lyy622516-web/basestation/05_嘉立创EDA工程/UHF_Reader_MultiFuntion_V5/3D模型与结构腔体/1412b6973b29b4b69cf0d955ecb4523.png

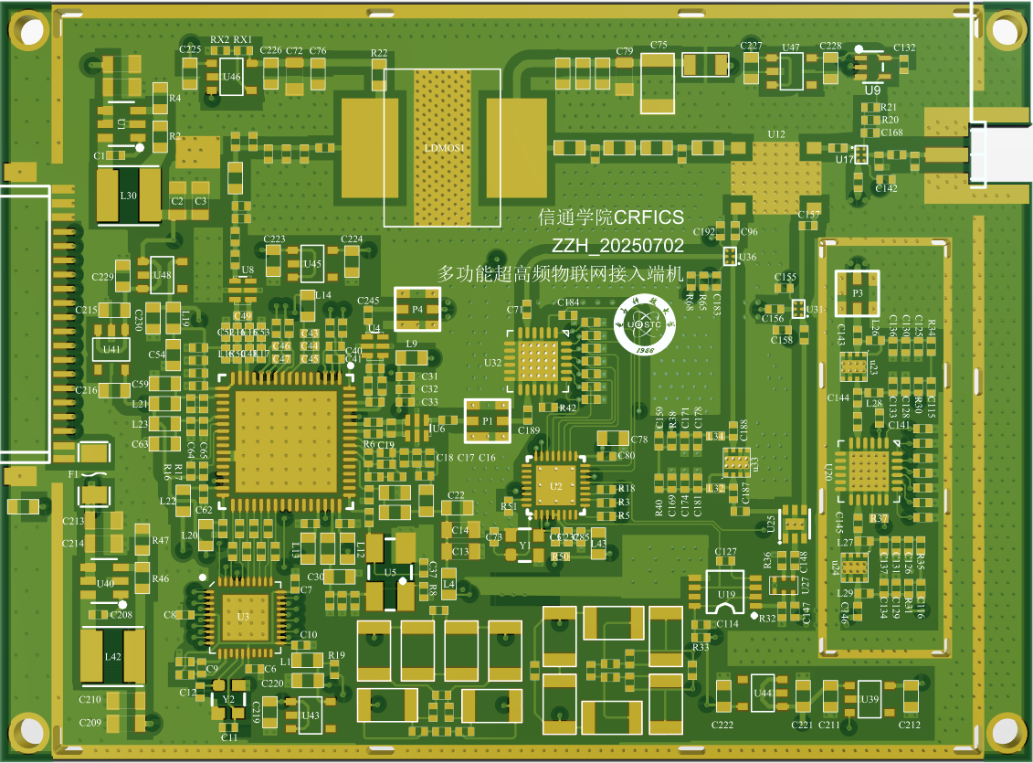
05_嘉立创EDA工程/UHF_Reader_MultiFuntion_V5/3D模型与结构腔体/1412b6973b29b4b69cf0d955ecb4523.png
