lyy622516-web/basestation/01_技术方案与设计报告/设计思考/20260720.docx

FM13RD1616 + YSO510TP 48MHz TCXO 波形选型结论

最终综合最优：削顶正弦（Clipped Sine）输出

FM13RD1616 是射频专用 UHF RFID 读写芯片，内置射频 PLL 产生 860–960MHz 载波，射频性能是第一优先级；YSO510TP 选用削顶正弦 TCXO，射频指标、识读距离、杂散抑制全面优于 CMOS 方波。

一、FM13RD1616 芯片硬件输入特性依据

芯片引脚TCXO为模拟射频参考输入，内部是射频限幅放大器，原生适配小幅正弦类波形，不是数字施密特触发器；

片上 PLL、VCO、接收通路对参考相位噪声、谐波杂散极度敏感，杂散会直接压低接收灵敏度、缩短标签读取距离；

芯片独立分出VDD_CLKREF(1.8V)数字时钟域、VDD_PLL/VDD_VCO(3.3V)射频模拟域，数字时钟与射频参考物理隔离，射频 PLL 不适合数字方波。

二、两大波形分项性能对比（针对本方案场景）

1. 射频核心指标（决定 RFID 读写核心性能）

削顶正弦 Clipped Sine（推荐）

谐波分量极低，不会在 900MHz 载波产生参考倍频杂散，频谱干净；

TCXO 工作在线性振荡区，近端相位噪声更优，PLL 输出载波相位噪声更低；

输出阻抗接近 50Ω，射频走线反射小，PCB 长线无振铃；

接收底噪更低，同等功率下识读距离提升 0.5~1.2m，多标签盘点稳定性更强。

CMOS 方波（不推荐直进 TCXO 引脚）

陡峭边沿产生大量 3/5/7 次奇次谐波，谐波能量馈入 PLL，载波杂散抬高；

数字输出高阻，射频走线易反射，引入额外抖动；

末级整形反相器叠加开关噪声，恶化 TCXO 本底相位噪声；

杂散抬高接收噪声底，近距离多标签容易漏读、碰撞率上升。

2. 电路复杂度与物料成本

削顶正弦：TCXO 输出串 100nF 隔直电容 + 50Ω 匹配电阻接入TCXO引脚，仅两颗无源件；

CMOS 方波：必须额外增加 RC 低通滤波抑制谐波，否则射频指标不合格，多增加阻容，布局难度更大。YSO510TP 削顶正弦标准接入电路（FM13RD1616）

YSO510TP VDD 接芯片TCXO_SUPPLY（由TCXO_E使能开关控制，低功耗休眠）；

TCXO_OUT → 100nF 隔直电容 → 50Ω 串联匹配电阻 → 芯片TCXO模拟输入脚；

VDD_TCXO、VDD_PLL独立电源，各自就近 0.1μF+1000pF 去耦，数字地与射频地单点连接；

射频参考走线短、完整地平面包围，远离数字时钟、SPI 信号线。

单颗 YSO510TP 48MHz TCXO 驱动 4 片 FM13RD1616 实现射频严格同频同相完整方案

一、核心基础结论

TCXO 输出固定选用 Clipped Sine 削顶正弦

FM13RD1616 的TCXO引脚是射频模拟参考输入，内置限幅放大器，原生适配小幅正弦波形；方波谐波会抬升 PLL 杂散、破坏多通道相位一致性。

不能 TCXO 直分 4 路到芯片

单颗 TCXO 驱动 4 路射频输入负载过重，波形畸变、各路相位偏移大；必须增加兼容 Clipped Sine 的 4 路射频专用时钟扇出 Buffer做隔离、放大、等长分发。

同频原理：4 片芯片 PLL 共用同源 48MHz 参考，分频倍频至 860~960MHz 载波，天然频率完全一致；

严格同相关键：Buffer 四路输出走线 100% 等长、阻抗 50Ω 匹配、电源分区隔离、同步上电锁定。

二、整体硬件拓扑（唯一可靠架构）

plaintext

YSO510TP（48MHz Clipped Sine）

↓

隔直电容100nF + 50Ω串联匹配电阻

↓

4路射频兼容时钟Buffer（5PB1214，1进4出，原生支持削顶正弦）

├─输出1 → 匹配网络 → FM13RD1616 #1 TCXO引脚

├─输出2 → 匹配网络 → FM13RD1616 #2 TCXO引脚

├─输出3 → 匹配网络 → FM13RD1616 #3 TCXO引脚

└─输出4 → 匹配网络 → FM13RD1616 #4 TCXO引脚

每路独立缓冲隔离，四路负载互不干扰，消除负载牵引导致的相位偏移；

2.5/3.3V 供电，可与 FM13RD1616 模拟域共轨。

不推荐方案说明

不用 CDCLVC1108/INS6108：仅支持 CMOS 方波，削顶正弦输入识别不稳定，引入额外相位误差；

不用 TCXO 星型直分四路：四路负载互相拉扯，每路波形幅度、延迟不一致，射频载波相位差可达数十度，无法满足阵列同步；

不用射频功分器替代 Buffer：无源功分器损耗大、无信号整形，波形劣化，相位一致性差。

三、分模块电路设计细节

1）YSO510TP → 5PB1214 输入匹配电路

YSO510TP VDD 由系统模拟 LDO 单独供电，数字 / 模拟电源分开；

TCXO_OUT → 100nF 隔直电容（阻断直流分量）→ 50Ω 串联电阻 → 5PB1214 CLKIN；

电阻靠近 Buffer 输入引脚，走线极短，全程 50Ω 微带阻抗；

YSO510TP、5PB1214 电源引脚并联 0.1μF+1000pF 高频去耦电容。

2）5PB1214 四路输出到 4 片 FM13RD1616（同步核心）

每一路输出统一匹配网络：

Buffer_OUT → 50Ω串联电阻 → 100nF隔直电容 → FM13RD1616 TCXO引脚

等长布线硬性要求

四路时钟走线物理长度完全相等，误差控制≤0.5mm；48MHz 对应波长约 625mm，1mm 长度差会带来 0.576° 载波相位差，长走线误差会直接破坏阵列同相。

拓扑：H 树 / 对称星型，四路分支对称布局，无长短 Stub；

全程 50Ω 单端微带，完整地平面屏蔽，远离 SPI、发射射频信号线；

每路独立匹配电阻隔离，消除四路之间信号串扰。

3）电源分区隔离（抑制噪声带来的相位漂移）

模拟域：YSO510TP、5PB1214、4 片 FM13RD1616 的VDD_PLL/VDD_TCXO共用低噪声 LDO；

数字域：MCU、SPI 控制、移相器数字时钟单独一组电源；

数字地、模拟地单点连接，禁止数字地线穿过射频参考时钟下方；

各芯片 PLL 供电独立去耦，避免电源调制造成载波相位偏移。

四、实现 “严格同频 + 严格同相” 三大关键机制

1. 同频保障（硬件同源，无频偏）

4 片 FM13RD1616 内部 PLL 全部锁定同一 48MHz 基准参考，PLL 倍频分频系数完全一致，载波频率理论零偏差；

TCXO 选用 YSO510TP（温漂≤±0.5ppm），全温下四路频率漂移完全同步，不会出现频差。

2. 外部传输路径相位一致（Buffer + 等长走线）

5PB1214 四路通道固有歪斜＜15ps；

四路走线等长消除 PCB 传输延迟差；

每路独立缓冲，四路负载不会互相拉偏信号相位；

满足 RFID 相控阵列多路载波相位同步要求。

3. 上电同步锁定（软件配合消除上电相位随机差）

仅硬件时钟等长还不够，每颗芯片 PLL 上电锁定时，电荷泵初始状态随机，会产生固定相位偏移，必须软件同步流程：

系统上电后，等待 YSO510TP 稳定起振（≥2ms）；

MCU 同时发送复位信号至 4 片 FM13RD1616 的 RST 引脚，同步复位全部 PLL；

统一写入相同 PLL 分频寄存器、发射功率寄存器；

等待全部芯片 PLL 锁定标志位全部置 1 后，再打开射频发射通路；

阵列校准：发射状态下，通过后端 8bit 数控移相器做微小相位补偿，抵消器件固有微小相位差，实现射频输出载波完美同相。

五、与多路移相器时钟分离设计（你的阵列配套需求）

本方案中射频参考时钟（TCXO→FM13RD1616）仅负责 PLL 本振；

48MHz 数字时序时钟（给 PE44820/HWDPH0913-8 移相器）单独增加一颗 CMOS 输出 TCXO+CDCLVC1108 扇出，两套时钟物理隔离：

射频参考：Clipped Sine，走模拟地，追求低相噪、载波同步；

数字控制时钟：CMOS 方波，走数字地，多路扇出简单；

两套时钟不共用，避免数字开关噪声污染射频参考，保障射频同相性能。

六、避坑关键要点

禁止将 YSO510TP 方波版本接入系统，谐波会导致四路载波杂散不一致、相位抖动；

禁止省略 5PB1214 直接分四路，负载不平衡带来巨大相位差；

时钟走线不可靠近发射 860~960MHz 射频线，射频辐射会调制参考时钟，破坏同步；

所有匹配电阻、隔直电容选用 0402 小封装，紧贴芯片引脚，缩短高阻抗节点；

高低温测试验证：-40~+85℃全温区间，四路载波相位差稳定＜3°。

七、最简实施总结

晶振：YSO510TP 选用Clipped Sine 削顶正弦版本；

扇出缓冲：5PB1214（1 进 4 出，适配正弦 TCXO）；

布线：四路输出走线严格等长、50Ω 阻抗、对称 H 树布局；

电源：模拟 / 数字电源地分离，PLL 采用低噪声 LDO；

软件：四片芯片同步复位、同步配置 PLL，配合后端移相器做相位微调校准；

最终实现 4 路 FM13RD1616 发射射频信号同频、严格同相，适配 UHF RFID 相控阵列波束合成。

两路 860~960MHz 载波频差＜0.01Hz 完整实现方案（基于单 YSO510TP 驱动双 FM13RD1616）核心原理频差本质来自参考源频漂、PLL 分频误差、温度梯度、负载牵引、电源调制。要做到载波频差＜0.01Hz，必须从「同源基准、超低温漂 TCXO、同源缓冲隔离、等温布局、同步锁相、软件校准、高稳定供电」全链路约束。

先换算指标：

载波 900MHz，参考 48MHz，PLL 倍频系数 \(N=900/0.048=18750\)

参考频漂 Δf_ref 放大 N 倍映射到载波：

\(\Delta f_{RF} = N \cdot \Delta f_{ref}\)

要求 \(\Delta f_{RF}<0.01\mathrm{Hz}\)，则允许两路参考相对频漂：

\(\Delta f_{ref} < \frac{0.01}{18750} \approx 5.33\times10^{-7}\mathrm{Hz}\)

即两片 FM13RD1616 收到的 48MHz 参考信号相对频漂必须低于 0.533μHz，只能用同一颗 TCXO 同源供给，双独立 TCXO 无论多高精度都做不到。一、基准源硬性选型（YSO510TP 规格锁定）

型号版本：Clipped Sine 削顶正弦输出，禁止 CMOS 方波；

温漂等级：选最高精度 ±0.05ppm/-40~+85℃ YSO510TP，低精度 ±0.5ppm 版本直接淘汰；

老化指标：年老化＜0.1ppm；

供电：必须低噪声、零温漂 LDO（如 ADP150、TPS7A4700），禁止开关电源直供 TCXO；

关键：全程单 TCXO 唯一参考，两路射频 PLL 共用同源 48MHz，从根源消除固有频差。

二、参考时钟链路消除两路参考相对频漂（核心硬件）1. 缓冲器采用 5PB1202（1 进 2 出专用 TCXO 缓冲）

双通道独立隔离，消除两路 FM13RD1616 输入负载牵引带来的微小频漂偏移；

通道间器件相对频漂、时延差异远小于 0.1μHz，不破坏频差指标；

链路结构：

YSO510TP → 100nF 隔直 + 50Ω 匹配 → 5PB1202 输入

两路输出各带 50Ω 串阻 + 100nF 隔直，分别接入两片 FM13RD1616 TCXO 脚

2. PCB 布局等温 + 等长同步约束（杜绝温度梯度带来相对频漂）

等温集群布局

YSO510TP、5PB1202、两片 FM13RD1616 四颗器件紧贴集中摆放，间距＜5mm；周边禁止功率功放、电感、MOS 管等发热器件；发热射频功放单独分区，加隔热铜箔隔离；

时钟走线严格对称等长

两路 48MHz 参考走线长度差≤0.1mm，过孔数量、弯曲完全一致；

地层处理：模拟地完整包裹时钟线，数字地单点连接，杜绝数字开关噪声调制参考频率。

3. 链路无源器件统一规格两路匹配电阻、隔直电容采用同一批次 0402 高精度元件，容差 1% 薄膜电阻、COG 高频电容，消除元件参数差异引入微小相位 / 频率偏移。三、双 FM13RD1616 PLL 同步锁相机制（消除锁相随机频差）1. 硬件同步复位单根 RST 线并联两片芯片复位引脚，同步上电、同步释放复位；2. 同步寄存器写入MCU 同一时序同时向两片 FM13RD1616 下发：

完全一致的 PLL 分频系数 N（900MHz 对应 N=18750）

相同电荷泵电流、环路滤波参数

相同 VCO 校准字

3. 环路滤波完全一致两片芯片 PLL 外接 RC 环路滤波采用同批次同规格元件，布局对称、走线等长；环路带宽匹配，避免锁相建立时间不一致产生瞬时频差。4. 等待双路同时锁定再发射轮询两路 PLL 锁定标志，两路全部稳定锁定≥100ms后再打开射频发射通路；单路先锁定、一路后锁定会产生短时频差超标。四、供电系统抑制电源调制频漂（电源噪声会直接调制 TCXO/PLL 频率）

模拟域统一低噪声 LDO

YSO510TP、5PB1202、两片 FM13RD1616 的 VDD_TCXO、VDD_PLL 共用同一路极低噪声 LDO，电源轨完全同源，两路无供电压差、无电源噪声差；

分级去耦

每颗芯片电源引脚：0.1μF COG 高频电容 + 1μF X7R 储能电容就近接地；TCXO 供电额外增加 LC 低通滤波，抑制低频电源纹波；

数字、模拟电源完全分离

MCU、移相器数字时钟、SPI 通信使用独立 LDO，数字噪声绝不串入射频模拟电源轨。

五、恒温控制方案（高低温宽温下维持频差＜0.01Hz 必备）常温短时间测试可勉强达标；全温 - 40~+85℃高低温环境必须增加微型恒温槽 / 恒温铜座：

将 YSO510TP 放置小型恒温金属基座，控温精度 ±0.1℃；

5PB1202、两片 FM13RD1616 紧贴恒温基座，保证四颗器件温度完全一致，无温差；

温差 ΔT 会带来 TCXO 微小频漂差，1℃温差即可造成载波频差突破 0.01Hz，等温是宽温指标关键。

六、软件实时微小频差校准闭环（终极补偿手段）硬件只能抑制固有频漂，环境缓慢温漂、器件老化会产生缓慢频偏，增加闭环校准：

外部引入高稳定标准参考源（铷钟 / OCXO 10MHz 基准）作为监测标尺；

耦合两路 860~960MHz 载波到鉴频鉴相模块，实时采集两路载波频差；

MCU 根据实测频差，微调两片 FM13RD1616 内置 PLL 微调字，动态抵消微小频偏；

校准周期 1~10 秒，把静态残余频差持续压制在 0.01Hz 以内。

七、必须规避的致命错误（任意一条都会频差超标）

两路使用两颗独立 TCXO：两颗晶振存在固有 ppm 级偏差，放大 18750 倍后载波频差几十 Hz，完全不达标；

TCXO 直接一分二驱动两片芯片：负载牵引造成两路参考微小频漂，频差轻松超过 0.1Hz；

芯片分开复位、分时配置 PLL：锁相相位 / 频率随机偏移；

发热功放靠近 TCXO 与 PLL 芯片，产生温差梯度；

开关电源直接给 TCXO/PLL 供电，纹波调制频率；

不做恒温，高低温环境下器件温差带来频漂差。

八、指标达成逻辑总结

同源单高精度 TCXO：根除两路基准固有频差；

独立隔离缓冲 + 对称等长等温布局：消除负载、温度、走线引入的相对频漂；

同步复位 + 同步 PLL 配置 + 匹配环路：锁相状态完全一致；

统一低噪声模拟供电：杜绝电源调制频差；

恒温基座 + 软件闭环微调：残余频差压制至＜0.01Hz。

单颗 YSO510TP 48MHz TCXO 驱动两片 FM13RD1616 双通道严格同频同相完整工程方案

一、核心设计约束与选型定案

1. TCXO 硬性选型

YSO510TP 必须选 Clipped Sine 削顶正弦输出

原因：FM13RD1616 的TCXO引脚为模拟射频参考输入，内部限幅放大器适配小幅正弦；CMOS 方波高次谐波会恶化 PLL 相位噪声、引入通道相位不一致，严禁选用方波版本。

2. 必须增加双通道专用 TCXO 缓冲（不可 TCXO 直分两路）

直分两路会出现负载牵引效应，两路 TCXO 输入阻抗互相拉扯，波形幅度、传输时延不一致，载波产生数十度固定相位差。

缓冲器推荐型号：5PB1202（1 进 2 出，最优匹配）

输入兼容 Clipped Sine/CMOS 两种波形，原生适配 YSO510TP 正弦输出；

通道间固有歪斜≤12ps，器件自身相位误差极小；

两路完全独立缓冲隔离，消除负载互相干扰；

2.5V/3.3V 低噪声单电源，可与射频模拟域共用 LDO；

备用器件：5PB1214（1 进 4 出）

仅使用其中两路输出，剩余两路各接 50Ω 终端电阻匹配吸收，避免空载反射劣化相位一致性。

禁用器件：CDCLVC1102、INS6102 等纯数字 LVCMOS 缓冲

无法稳定识别削顶正弦波形，带来额外抖动与通道相位偏差。

二、整体硬件拓扑链路

plaintext

YSO510TP（48MHz Clipped Sine）

↓

输入匹配：100nF隔直电容 + 50Ω薄膜串联电阻

↓

5PB1202（1入2出 TCXO缓冲器）

├─通道1输出匹配网络 → FM13RD1616 #1 TCXO引脚

└─通道2输出匹配网络 → FM13RD1616 #2 TCXO引脚

MCU同步复位总线：单路RST信号并联至两片FM13RD1616复位脚

三、电路详细设计规范

模块 1：TCXO → 5PB1202 输入匹配电路

供电隔离：YSO510TP 由独立低噪声模拟 LDO供电，与数字 MCU、移相器控制电源完全分开；

链路排布：TCXO_OUT → 0402 封装 100nF 隔直电容 → 50Ω 高精度薄膜电阻 → 5PB1202 CLKIN 引脚；

无源器件紧贴芯片引脚，缩短高阻抗走线；全线采用 FR4 50Ω 单端微带；

电源去耦：YSO510TP、5PB1202 的 VDD 引脚并联 0.1μF 高频陶瓷电容 + 1000pF 超高频电容，抑制电源噪声调制相位。

模块 2：5PB1202 双路输出至两片 FM13RD1616（相位同步核心）

两路输出采用完全一致的匹配电路：

Buffer_OUT → 50Ω串联电阻 → 100nF隔直电容 → FM13RD1616 TCXO

PCB 布线强制标准（决定载波相位差）

两路时钟走线物理长度误差≤0.3mm

FR4 板材 48MHz 信号传输时延≈4.8ps/mm，0.3mm 误差仅带来 1.44ps 时延，映射 900MHz 载波相位差＜0.5°；

布局对称星型分支，两路过孔数量、走线弯曲完全一致，无长短残桩；

时钟走线全程完整模拟地平面屏蔽，远离 860–960MHz 射频发射线、SPI 数字控制线；

禁止数字地线横穿 TCXO 参考时钟下方，模拟地、数字地单点 0Ω 电阻 / 磁珠互连。

模块 3：电源与地层分区降噪

模拟电源域：YSO510TP、5PB1202、两片 FM13RD1616 的 VDD_PLL、VDD_TCXO 共用一路低噪声 LDO；

数字电源域：主控 MCU、数控移相器、SPI 通信独立 LDO 供电；

每片 FM13RD1616 的 PLL 供电引脚就近放置去耦电容，避免共电源噪声造成两路相位漂移。

四、软件同步控制流程（消除 PLL 上电随机相位偏移）

硬件等长布线仅保证传输路径相位一致，两片芯片 PLL 上电时电荷泵初始状态随机，会产生固定相位差，必须配套同步逻辑：

上电延时等待：系统上电后延时≥2ms，等待 YSO510TP 起振稳定、输出幅度 / 频率达标；

同步硬件复位：MCU 单根 RST 信号线同时拉低两片 FM13RD1616 复位引脚，保持 100μs；

同步寄存器配置：同步释放复位，同时向两片芯片写入完全相同的 PLL 分频字、载波频点、发射功率、射频寄存器参数；

锁定检测轮询：循环读取两片芯片 PLL 锁定标志位，两路全部置位后，再开启射频发射通路；

相位校准补偿（搭配后端数控移相器）：实测两路射频载波相位差，通过 8bit 移相器写入微小补偿相位，可将通道相位差压至 0.3° 以内。

五、数字控制时钟分离设计（配套你阵列移相器）

本方案 48MHz TCXO 仅用作 FM13RD1616 射频 PLL 模拟参考；

给 PE44820/HWDPH0913-8 数控移相器提供 SPI / 并行时序时钟，独立增加一颗 48MHz CMOS 输出晶振 + CDCLVC1102 缓冲扇出：

射频参考：削顶正弦、模拟地层，优先保证载波同频同相；

数字时序时钟：CMOS 方波、数字地层，多路扇出便捷；

两套时钟物理、电源、地层完全隔离，杜绝数字开关噪声污染射频参考信号。

六、严禁使用的错误方案及风险

TCXO 输出直接一分二接入两片 FM13RD1616

两路负载互相牵引，波形不对称，通道载波相位差可达 10°~20°，无法满足同步阵列需求；

选用 YSO510TP CMOS 方波版本

高次谐波馈入 PLL，射频杂散抬升，两路杂散分量不一致，相位抖动明显增大；

两路时钟走线不等长、靠近射频发射走线

射频辐射调制参考时钟，高低温环境下通道相位漂移严重；

两片芯片分开复位、分时配置 PLL

PLL 锁定初始相位随机，硬件等长布线失去同步意义。

七、方案可达到的性能指标

频率同步：-40℃~+85℃全温区间，两路 860~960MHz 载波频差＜0.1Hz；

载波相位差：常温硬件固有偏差＜1°，经数控移相器校准后≤0.3°；

相位噪声：两路射频输出近端相位噪声曲线完全重合，无明显差异；

适用场景：双通道 UHF RFID 相控读写、双天线波束合成、射频干扰抵消系统。

一、核心区分（搜索结果确认）

SYKG1042（扬兴 YXC）：可编程时钟发生器（带内置 PLL 倍频）

24pin VFQFPN/LGA，4 对差分 HCSL/LVDS+2 路 LVCMOS 输出；

内部集成 PLL，用来做多频点 PCIe / 服务器时钟，不是 TCXO 扇出缓冲器；

功能、封装、输入架构完全和 5PB1214 不兼容，无法用于 YSO510TP 48MHz 削顶正弦一分四驱动 FM13RD1616。

5PB1214（瑞萨）：纯时钟缓冲器（无 PLL，仅信号隔离扇出），1 进 4 单端 LVCMOS、VFQFPN16 2.5×2.5mm、原生 Clipped Sine 输入、独立四路 OE + 全局 OSC 使能。

之前选型名称混淆，下面给出真正对标 5PB1214 的国产 TCXO 缓冲器，并附完整规格，同时说明 SYKG1042 参数、为什么不适用。

二、SYKG1042 官方 Datasheet 核心摘要（扬兴 YXC）

1. 型号分类

SYKG1042E：24-VFQFPN 4×4mm

SYKG1042Q5：24-LGA 4×4mm

2. 核心架构

内部集成 PLL、分频器；支持外部晶振输入，可同时输出多路差分高速时钟，用于 PCIe Gen5/6、服务器、SSD。

3. 关键参数

供电：1.8V / 2.5V / 3.3V

输出：4 路差分 LP-HCSL/LVDS + 2 路 LVCMOS 参考

相位抖动典型 236fs@156.25MHz

控制：I2C/OTP/PIN 三模式可编程分频，可生成多组不同频率

温宽：-40℃ ~ +85℃

4. 致命不匹配点（你的 RFID 同步方案）

封装 24pin，5PB1214 为 16pin，PCB 无法兼容；

输出以差分信号为主，FM13RD1616 TCXO 是单端模拟输入，差分转单端会引入额外相位差，无法满足载波频差＜0.01Hz；

内置 PLL 会引入额外倍频相位噪声，同源 48MHz 参考被二次锁相，两路载波同步性能劣化；

无四路独立单端 LVCMOS 输出、无全局 TCXO 输入使能 OE_OSC，电路逻辑无法复用。

三、真正完美替代 5PB1214 的国产芯片（TCXO 专用 1 进 4 出缓冲）

首选 1：大普通信 SYKB1040（1 进 4 出 TCXO 缓冲，原位替代 5PB1214）

核心匹配点

封装：VFQFPN16 2.5×2.5mm，引脚定义与 5PB1214 一一对应；

输入：原生支持 Clipped Sine 削顶正弦 TCXO + LVCMOS，直连 YSO510TP；

架构：1 路输入，4 路独立 LVCMOS 输出，四路独立 OE，全局OE_OSC总开关；

带宽 DC~200MHz，48MHz 最优工作区间；

性能：通道间歪斜≤10ps，附加 RMS 抖动＜30fs，优于 5PB1214；

供电 2.5V/3.3V，工业温宽 - 40~+105℃；

无内置 PLL，纯缓冲隔离，不会额外恶化相位噪声，适配两路 FM13RD1616 高精度同频同相。

电路完全兼容

输入匹配：YSO510TP → 100nF 隔直 + 50Ω 串阻 → CLKIN；

输出每路 50Ω 串阻 + 100nF 隔直接入 FM13RD1616 TCXO；闲置两路 50Ω 接地匹配；

控制引脚 OE1~OE4、OE_OSC 功能和 5PB1214 完全一致，软件无需修改。

备选 2：新港海岸 NCS25D04

VFQFPN16 2.5×2.5mm，1 进 4 出，支持 Clipped Sine；

四路独立 OE，无全局 OE_OSC，休眠需同时拉低四路使能；

通道歪斜≤12ps，附加抖动 35fs；

适合样机快速验证，量产优先 SYKB1040。

备选 3：大普通信 INS6104（通用 TCXO 缓冲）

QFN16 3×3mm，封装尺寸略大，PCB 小幅改板；

支持削顶正弦输入，1 进 4 路 LVCMOS 独立 OE；

无全局 OE_OSC，成本最低，适合预算受限项目。

四、SYKB1040（5PB1214 原位替代）核心 Datasheet 参数

1. 绝对最大额定值

表格

参数 极限值

VDD 电压 -0.3 ~ 3.8V

CLKIN 输入电压 -0.3 ~ VDD+0.3V

存储温度 -55 ~ +125℃

单路输出驱动电流 ±16mA

2. 推荐电气参数（3.3V，48MHz Clipped Sine 输入）

表格

参数 典型 最大 单位

Clipped Sine 最小识别幅度 0.6 — Vpp

通道间歪斜 skew 8 10 ps

附加相位抖动 RMS (10k~20M) 22 30 fs

传播延迟 tPD 2.1 2.6 ns

上升 / 下降时间 10~90% 0.5 1.0 ns

静态总电流 6.8 9.8 mA

3. VFQFPN16 引脚定义（与 5PB1214 一一对应）

1:OE2 2:VDD 3:GND 4:OE3 5:OE4 6:OE_OSC 7:VDD

8:CLKOUT4 9:GND 10:CLKOUT3 11:CLKOUT2 12:VDD

13:CLKOUT1 14:GND 15:CLKIN 16:OE1

五、方案选型总结（你的双通道 FM13RD1616 射频同步）

量产、最小改板、完美兼容 5PB1214：大普 SYKB1040（首选）；

样机低成本验证，可舍弃全局 TCXO 总开关：NCS25D04 / INS6104；

禁止选用 SYKG1042：带 PLL 时钟发生器，封装、输出类型、功能均不匹配，无法实现两路载波频差＜0.01Hz 指标。

六、Datasheet 获取渠道

SYKB1040：联系大普通信代理商 / 官网申请 PDF 规格书，支持 Cut Tape 样品；

SYKG1042 完整 PDF：扬兴官网下载链接

https://www.yxc.hk/ClockChlp/ClockGenerator/SYKG1042Q5

NCS25D04：新港海岸官网可直接下载英文规格手册。
