lyy622516-web/basestation/01_技术方案与设计报告/设计思考/20260723开关插入损耗.docx

ADG9218 0.4-0.7

GX1258EA 0.6

削顶正弦波输入开关后输出幅度大概再0.74到0.76vpp
