lyy622516-web/basestation/01_技术方案与设计报告/设计思考/20260903可重构RFID端机_Ethernet协同组网与Master-Slave角色设计方案_V1.1.docx

可重构 RFID 端机
Ethernet 协同组网与 Master-Slave 角色设计方案

Technical Design Specification

文档版本 | V1.1
系统形式 | 同构可重构端机协同网络
协同网络 | Ethernet + Switch
角色模型 | 1 Master + N Slave
频率参考 | 公共 48 MHz
日期 | 2026-09-03

# 1 方案目标

本方案只描述多台可重构 RFID 端机之间如何通过 Ethernet 形成协同网络，以及同构端机在组网后如何承担不同的软件角色。端机之间的 Master/Slave 关系不由硬件固定，而是在软件运行时确定，因此任意一台端机都可以根据当前任务切换为 Master 或 Slave。

设计目标是把多个完全独立工作的 Reader 节点组织成一个逻辑协同组。组内节点通过交换机进行 Ethernet 通信，Master 负责建立协同任务、确定关键盘存参数和推进协同轮次，Slave 按照 Master 的任务上下文和参数执行对应操作，并通过网络返回 READY、运行状态和盘存结果。硬件保持同构，可以从两节点平滑扩展为 1 Master + N Slave。

# 2 Ethernet 协同组网架构

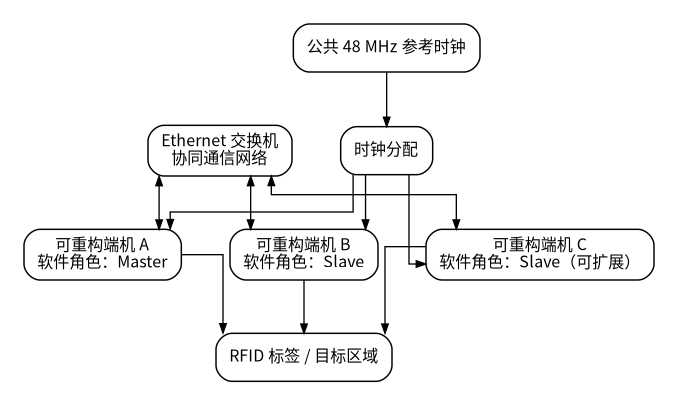
[picture p71: figure]

图 2-1 Ethernet 协同组网总体架构

所有可重构端机通过标准 Ethernet 接口接入同一交换机，由交换机提供节点之间的双向数据通道。网络本身不区分主从，Master/Slave 只存在于端机软件逻辑中。这样可以避免为主端机和从端机设计不同的网络接口或不同的 PCB，降低硬件种类和维护成本。

在两点式模式下，可以由端机 A 作为 Master、端机 B 作为 Slave；下一次任务也可以交换角色。扩展到多节点后，可形成一个 Master 同时协调多个 Slave 的星型协同结构。只要节点能够接入同一 Ethernet 网络，角色和协同关系都可以由软件重新组织。

## 2.1 网络拓扑原则

推荐采用交换机为中心的星型拓扑。每个端机拥有独立 IP 地址和 Node ID，通过 UDP 或 TCP 等现有网络传输机制进行消息交互。Ethernet 在本方案中的主要作用是传递协同控制信息、关键协议参数、节点状态和盘存结果，而不是承担 922.5 MHz RF 载波的相位参考。

内容 | 通过 Ethernet 传输的典型信息 | 作用
节点身份 | Node ID、Role、Group ID | 明确每个节点在协同组中的身份
协同任务 | Round ID、模式、开始/停止命令 | 保证节点处于同一个协同轮次
盘存参数 | Q、Session、Target 等关键参数 | 保证 Master/Slave 生成一致或兼容的协议行为
节点状态 | READY、RUNNING、ERROR | 让 Master 判断组内节点是否可继续协同
盘存结果 | 标签数据、状态、统计信息 | 用于组级结果汇总和下一轮决策

# 3 同构端机与软件定义角色

Master 与 Slave 应理解为“软件角色”，而不是两种不同的硬件型号。所有端机都保留完整的 RFID 发射、接收、控制和 Ethernet 通信能力。角色只决定一次协同任务中谁负责决策、谁负责跟随。这样既符合可重构端机的设计定位，也便于现场替换、故障切换和节点扩展。

角色 | 核心职责 | 不应承担的职责
Master | 建立协同轮次；确定关键盘存参数；向 Slave 同步任务和参数；确认 Slave 状态；推进下一轮协同流程 | 不需要通过专用硬线永久占据“主节点”地位
Slave | 接收 Master 的任务和参数；校验一致性；进入 READY；按协同要求执行发射/接收；回传状态和结果 | 在要求同波形协同时，不应独立修改会改变 Query 内容的关键动态参数

## 3.1 Master 角色

Master 是当前协同组的逻辑协调节点。它负责生成本轮 Round ID，确定需要同步给 Slave 的关键盘存参数，并通过 Ethernet 下发协同消息。Master 在收到各 Slave 的 READY 或状态反馈后，决定是否进入协同执行阶段。盘存结束后，Master 可以依据各节点返回的结果更新下一轮参数。

对于现有协议栈，Master 可以继续使用原有 INVENTORY_18k6c、invDynamicQ、xmitQueryCmd 等主要流程。需要新增的主要内容是：把本轮关键参数从本地变量提升为“协同组参数”，在适当时机通过 Ethernet 同步给 Slave。

## 3.2 Slave 角色

Slave 并不是简单的功放辅助设备，而是具备完整 Reader 能力的协同节点。它从 Ethernet 接收 Master 的任务上下文和关键盘存参数，在本地完成参数校验后进入 READY，并按照 Master 的协同轮次执行对应的发射、接收和状态上报。

当目标是让 Master 和 Slave 发射相同 Query 波形时，Slave 不应独立运行会改变 Query 内容的 Dynamic Q 决策。否则可能出现 Master 的 Q=4、Slave 的 Q=5，导致两路调制数据本身不同。更合理的方式是由 Master 进行关键协议决策，Slave 加载或镜像相同参数，再由本地协议栈生成一致的 Query。

## 3.3 角色可切换性

为了体现可重构特性，角色切换不应要求改变硬件连接。端机 A 在一次任务中可以是 Master，下一次任务中可以变为 Slave；端机 B 则可以反向切换为 Master。角色变化只影响软件状态机和 Ethernet 消息处理逻辑。

Role ∈ { STANDALONE, MASTER, SLAVE }

任务 1：Node A = MASTER，Node B = SLAVE

任务 2：Node A = SLAVE，Node B = MASTER

多节点：Node A = MASTER，Node B/C/D = SLAVE

# 4 Ethernet 协同通信机制

端机之间的 Ethernet 通信建议按“任务级协同”设计，而不是把每一个 RFID 空口命令都通过网络实时转发。Master 需要向 Slave 同步的是一轮协同任务的上下文和关键参数；Query、RN16、ACK、EPC 等严格时序动作仍尽量由各端机本地协议栈执行。这样可以避免把网络时延和操作系统调度直接引入 Gen2 的细粒度空口时序。

## 4.1 建议的协同消息类型

消息 | 发送方向 | 主要内容
ROLE_SYNC | Master/系统 → 节点 | Role、Group ID、Node ID
PARAM_SYNC | Master → Slave | Round ID、Q、Session、Target、频点/模式相关参数
READY | Slave → Master | 参数校验通过，可进入本轮协同任务
START / ARM | Master → Slave | 本轮任务正式进入执行阶段
STATUS | 双向 | RUNNING、ERROR、完成度等状态
RESULT | Slave → Master | 标签结果、接收状态、统计信息
STOP | Master → Slave | 终止当前协同任务

## 4.2 协同通信流程

协同通信主线：Master 建立 Round ID 和关键参数 → Ethernet 参数同步 → Slave 校验并返回 READY → Master 确认组内就绪 → START / ARM → Master 与 Slave 按角色执行本地协议 → Slave 回传状态和结果。

一轮协同工作的基本过程是：Master 首先建立 Round ID 和本轮关键参数，然后通过 Ethernet 同步给所有 Slave；Slave 校验后返回 READY；Master 确认组内节点均满足条件，再进入 START 或 ARM；随后各端机按各自角色执行本地 RFID 协议流程，并通过 Ethernet 持续反馈状态和结果。

这种方式的重点不是追求“一个 Ethernet 报文同时到达所有节点”，而是保证所有节点在逻辑上处于同一个协同轮次，并且使用一致的关键参数。若后续需要精确到 RF 发射时刻，还应在协同网络之上叠加统一执行时刻 T0 或其他时间同步机制。

# 5 Master 与 Slave 的协议分工

对于现有盘存协议链，协同改造的核心不是把整条链路拆开，而是在角色判断处明确谁负责动态协议决策。Master 保留完整的盘存决策逻辑，Slave 在需要一致 Query 的协同模式下采用 Master 的关键参数。

Master：

INVENTORY_18k6c

→ invDynamicQ

→ 得到本轮关键参数

→ Ethernet PARAM_SYNC

→ 生成 Query

Slave：

接收 PARAM_SYNC

→ 校验 Round ID / 参数

→ 加载 Master 参数

→ 生成相同 Query

→ READY / 执行

这种分工可以保证 Master 和 Slave 的“逻辑角色”清晰，同时最大程度复用现有代码。Master 不需要通过 Ethernet 逐字节远程控制 Slave 的 TX FIFO；Slave 也不需要把整个协议控制权交给 Master。双方只同步决定协同行为所需的最小参数集合。

# 6 共享 48 MHz 与 Ethernet 角色的边界

虽然本文件重点是 Ethernet 组网和角色分工，但两者需要与现有公共 48 MHz 参考时钟保持清晰边界。Ethernet 负责建立协同关系、同步任务和参数；公共 48 MHz 负责让多个端机具有统一的频率基准。Master/Slave 软件角色改变时，共享时钟拓扑无需改变。

因此 Master 不应被定义为“48 MHz 时钟提供者”，而应定义为“本轮协同任务的逻辑协调者”。共享参考时钟属于系统同步资源，与软件角色解耦。后续如果需要实现相干发射，再在公共频率参考基础上增加时间对齐和相位校准。

层次 | 主要作用 | Master/Slave 是否相关
Ethernet 协同网络 | 任务、参数、状态、结果通信 | 强相关：角色决定消息方向和决策权
公共 48 MHz | 统一频率参考 | 基本无关：角色切换不改变时钟连接
时间同步/T0 | 进一步统一 RF 执行时刻 | Master 可作为逻辑协调者
相位校准 | 实现目标点 RF 相干增强 | Master 可作为参考，Slave 进行补偿

# 7 可扩展性设计

两端机方案应从一开始按照 1 Master + N Slave 设计消息格式和状态机，而不是把协议写死为两个固定 IP 地址。Master 对多个 Slave 的处理可以采用节点表方式，每个 Slave 独立维护 Node ID、状态、参数版本和最近一次心跳/结果。

Cooperative Group

Master : Node A

Slave : Node B

Slave : Node C

Slave : Node D

每个 Slave 独立维护：

Node_ID / IP / READY / Round_ID / Param_Version / Status

这样后续从两点式扩展到三点式、多点式时，不需要重新定义整个 Ethernet 协议，只需要增加节点数量和相应的同步策略。

# 8 建议验证项目

第一阶段验证不需要追求最终相干增益，而应先确认 Ethernet 协同组本身工作可靠。测试时重点观察角色切换是否正确、参数是否一致、Round ID 是否匹配、Slave 是否能稳定进入 READY，以及在网络丢包或节点掉线时 Master 能否识别异常。

测试项 | 验证内容 | 通过标准
NET-01 | 端机经交换机双向通信 | Master 与 Slave 可稳定收发协同消息
ROLE-01 | 软件角色切换 | 同一硬件可在 Master/Slave 间切换
PARAM-01 | Master 参数同步 | Slave 接收到的关键参数与 Master 一致
ROUND-01 | 协同轮次一致性 | Master/Slave 的 Round ID 始终匹配
READY-01 | 组级就绪状态 | Slave 校验后正确返回 READY
FAULT-01 | 节点掉线/丢包 | Master 能进入异常处理而不是继续错误协同
SCALE-01 | 1 Master + N Slave | 增加节点后协议结构无需改动

# 9 结论

新版协同方案的核心是“同构硬件、Ethernet 组网、软件定义角色”。多台端机通过交换机组成统一协同网络，Master 负责建立协同轮次、确定关键盘存参数和推进任务，Slave 负责接收并镜像关键参数、进入 READY、跟随执行并反馈状态和结果。Master/Slave 不是固定硬件身份，任意端机都可以在软件上切换角色。

这一架构能够直接支持两点式 Master-Slave 协同，并自然扩展为 1 Master + N Slave。Ethernet 解决节点间的任务和参数协同，公共 48 MHz 继续承担统一频率参考。后续若需要实现更严格的同步发射或相干增强，可在本协同网络之上继续增加时间同步和 RF 相位校准，而不需要改变端机的基本组网方式。

# 附录 A Mermaid 图源码

以下 Mermaid 源码用于后续在 Markdown 或研发文档中复用。

flowchart TD

SW[Ethernet 交换机]

A[可重构端机 A\nRole = Master]

B[可重构端机 B\nRole = Slave]

C[可重构端机 C\nRole = Slave]

TAG[RFID 标签/目标区域]

CLK[公共 48 MHz 参考时钟]

SW <--> A

SW <--> B

SW <--> C

A --> TAG

B --> TAG

C --> TAG

CLK --> A

CLK --> B

CLK --> C

flowchart TD

M1[Master 建立 Round ID 和关键参数]

M2[PARAM_SYNC]

S1[Slave 校验并 READY]

M3[Master 确认组内就绪]

M4[START / ARM]

EX[Master/Slave 按角色执行本地协议]

R[Slave 返回状态和结果]

M1 --> M2 --> S1 --> M3 --> M4 --> EX --> R

可重构 RFID 端机 Ethernet 协同组网与 Master-Slave 角色设计方案
