lyy622516-web/basestation/01_技术方案与设计报告/设计思考/20260903可重构RFID端机_以太网协同通信与Master-Slave同步技术方案_V1.0.docx

可重构 RFID 端机
以太网协同通信与 Master-Slave 同步技术方案

Technical Design Specification

文档版本 | V1.0
适用对象 | 可重构 UHF RFID 端机系统
核心频点 | 922.5 MHz（按现有项目配置）
同步参考 | 公共 48 MHz 参考时钟
协同网络 | Ethernet + Switch
日期 | 2026-09-03

# 文档修订记录

版本 | 日期 | 修订说明
V1.0 | 2026-09-03 | 基于现有“分别配置、分别点击盘存”流程，提出以太网协同、软件定义 Master/Slave、共享 48 MHz、时间同步与 RF 相位校准的分阶段改造方案。

# 1 项目背景与改造目标

现有可重构端机已经具备独立配置和 RFID 盘存能力。当前使用方式是：在上位机上分别选择不同端机，完成频率、发射功率、工作模式等参数配置后，再分别点击各端机对应的“盘存”按钮，使端机进入标准 RFID 盘存流程。该方式适用于单端机调试和多个端机独立工作，但端机之间没有形成显式的协同组关系，也没有统一的 READY、START、轮次和角色管理机制。

本方案的目标不是推翻现有射频硬件与 RFID 协议栈，而是在现有基础上增加一层以太网协同控制机制，将多个同构端机从“分别受控的独立设备”升级为“软件定义角色的协同节点”。硬件层继续共用现有 48 MHz 参考时钟，软件层通过上位机配置 Master/Slave 角色、协同组、盘存任务和状态，并为后续统一执行时刻 T0、相位校准以及 PushID 类协同发射预留接口。

方案坚持兼容性优先。单机盘存、单端机调试和现有 0x52/0x12 调用链应继续保留；新增协同功能通过扩展上位机界面、网络控制帧和端机状态机实现，避免一次性大范围改写底层 RFID 驱动。

# 2 现有系统与问题定义

## 2.1 当前上位机控制方式

现阶段上位机对端机的控制是“先配置、后盘存”，且两个端机的盘存按钮分别点击。参数配置阶段本身没有明显问题，因为协同工作所需的大部分静态参数可以在正式盘存前完成。真正需要改变的是启动阶段：人工分别点击两个盘存按钮会引入明显的启动时间差，而且两台端机后续经过各自的软件调度和 RFID 芯片发送流程，最终 RF Query 的起始时刻更加无法保证一致。

环节 | 现有方式 | 协同方案要求
参数配置 | 分别配置各端机 | 继续保留，增加 Role、Group ID、协同模式等参数
盘存启动 | 分别人工点击盘存按钮 | 增加组级“协同盘存”入口
端机状态 | 主要面向单机 | 增加 CONFIG_OK / READY / ARMED / RUNNING 等状态
角色关系 | 端机之间无明确角色 | 上位机软件定义 Master / Slave
时间基准 | 盘存命令到达后直接执行 | 相干模式增加 ARM + T0
频率基准 | 公共 48 MHz | 继续保留并纳入同步架构说明

## 2.2 已确认的盘存命令调用链

现有端机从自定义开始帧进入 RFID 发射的主要软件调用链如下。该链路是本方案进行最小侵入式改造的重要依据。

0x52 自定义开始帧

→ 注入 0x12 标准盘存命令

→ handle_tag_query()

→ HST_CMD = CMD_18K6CINV

→ protocol_scheduler

→ INVENTORY_18k6c

→ invDynamicQ

→ xmitQueryCmd()

→ TxBuffer 写入 FM13RD TX FIFO

→ RF 发射

本方案不假设 FM13RD 内部尚未确认的寄存器时序。对于“xmitQueryCmd() 到 RF 真正出现在天线口之间还包含多少固定或随机延迟”，应在后续测试阶段通过示波器或包络检波实测，而不在设计阶段虚构。

# 3 总体技术架构

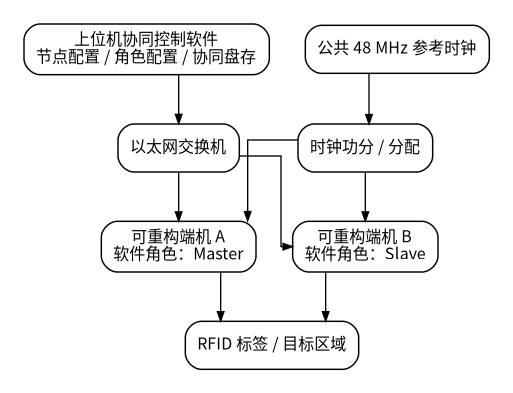
[picture p72: figure]

图 3-1 以太网协同与共享时钟总体架构

新架构将系统分成控制网络和同步参考两条相互独立但协同工作的路径。以太网负责节点发现、参数配置、角色设置、任务下发、状态确认和盘存结果回传；公共 48 MHz 参考时钟负责为多端机提供统一的频率基准。Master/Slave 是软件运行角色，不等同于时钟源角色，因此软件角色切换时不需要改变 48 MHz 的物理连接关系。

端机硬件保持同构，即任意一台端机原则上均具备作为 Master 或 Slave 的能力。上位机在一次协同任务开始前确定节点角色，并将角色写入端机。下一次任务可以交换角色。该方式可以避免把“主基站”和“从基站”固化为两套硬件版本，同时便于后续扩展为 1 Master + N Slave。

# 4 以太网协同控制层设计

## 4.1 设计定位

以太网在本项目中承担的是控制面，而不是 922.5 MHz 载波相位参考。换句话说，以太网需要保证多个节点收到同一个协同任务、使用同一组参数并按照同一轮次执行，但不要求普通 Ethernet 报文到达的瞬间就是 RF 发射时刻。

Ethernet：做什么 48 MHz：频率是否一致 T0：什么时候做 相位校准：能否相干叠加

## 4.2 节点与协同组模型

建议上位机在现有端机列表基础上新增协同组概念。每个节点至少具有 Node ID、IP 地址、Role、Group ID、工作模式、RF 参数和当前状态。协同组由一个 Master 和一个或多个 Slave 组成。单机模式继续使用 STANDALONE 角色，避免影响现有调试流程。

字段 | 建议含义 | 说明
Node ID | 节点唯一编号 | 用于上位机和日志定位
Group ID | 本次协同组编号 | 避免不同任务相互串扰
Role | STANDALONE / MASTER / SLAVE | 由上位机软件配置
Mode | 普通盘存 / 协同盘存 / 相干验证 | 便于分阶段实现
Round ID | 盘存轮次号 | 用于消息匹配和日志追踪
Status | IDLE / CONFIGURED / READY / ARMED / RUNNING / ERROR | 作为组级启动条件

## 4.3 上位机界面改造

现有“每个端机独立配置、独立盘存”的界面建议保留，以保证单机调试能力。在此基础上新增一个“协同组”区域：用户先选择参与的端机，为其中一台配置 Master、其余配置 Slave；分别完成参数下发后，上位机等待各节点返回 READY；当所有节点满足条件后，启用一个统一的“协同盘存”按钮。

第一阶段不必删除原有两个盘存按钮。原按钮继续用于单端机排障，新按钮只用于协同模式。这样软件回归风险最低，也便于对比独立盘存和协同盘存的行为差异。

# 5 Master/Slave 软件角色设计

## 5.1 角色原则

Master 与 Slave 均是完整可重构端机，只是一次协同盘存任务中的软件职责不同。Master 负责关键盘存参数决策和协同流程基准，Slave 不应在需要发射同一 Query 波形的模式下独立决定会改变 Query 内容的动态参数。

该要求尤其影响现有 invDynamicQ。若 Master 和 Slave 分别执行独立 Dynamic Q 决策，则可能出现不同的 Q 值，最终两台设备产生的 Query 调制内容不同。即使两路 RF 频率和相位已经一致，也无法形成预期的同波形协同发射。因此相干/同波形模式下，应采用“Master 决策、Slave 镜像”的机制。

## 5.2 Master 建议职责

Master 负责本轮盘存的关键协议参数选择与轮次推进。对于现有代码，可优先保持 Master 侧的 INVENTORY_18k6c、invDynamicQ 和 xmitQueryCmd 主流程不变，只在协同控制接口处增加参数发布和 READY/ARM 状态处理。Master 的目标不是把每一个 Gen2 时序动作都通过以太网实时控制 Slave，而是向 Slave 提供本轮需要一致的关键参数和统一任务上下文。

## 5.3 Slave 建议职责

Slave 在协同模式下加载上位机或 Master 已确定的协同参数，并按照与 Master 一致的 Query 构造逻辑进入 QUERY_READY。Slave 仍保留完整 Reader 能力，必要时可以独立接收标签回复；但在需要同波形发射的阶段，不独立修改 Q、Session、Target 等会导致 Query 内容变化的关键字段。

# 6 盘存流程与状态机改造

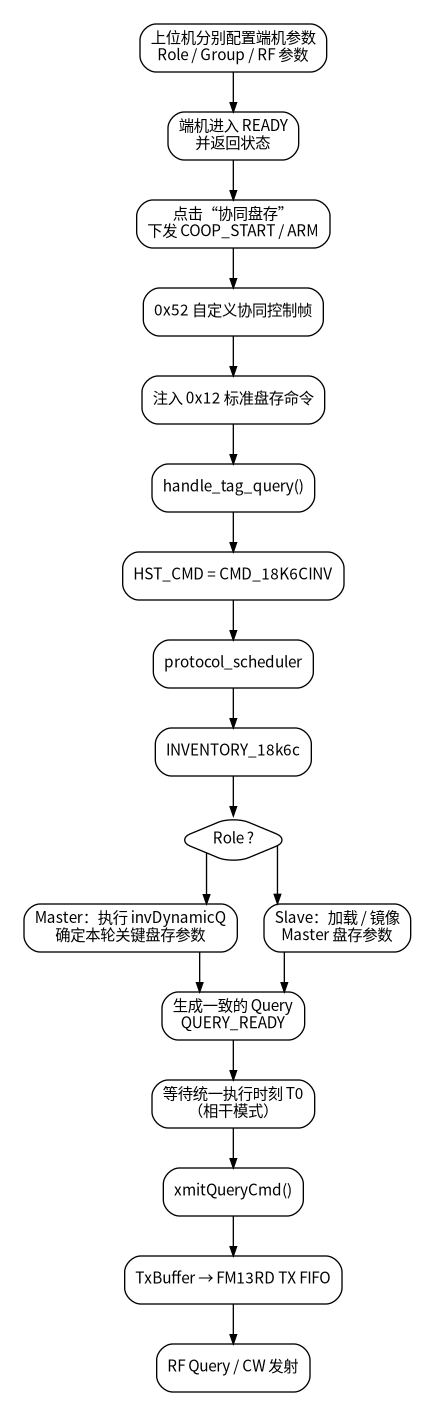
[picture p73: figure]

图 6-1 协同盘存建议软件主线

图 6-1 所示改造以现有调用链为核心，只在其前后增加协同状态。端机收到协同 PREPARE 后先完成角色和 RF 参数配置，不立即触发 0x12；完成配置后进入 READY。上位机确认整个 Group 的节点均 READY 后，再下发 COOP_START 或 COOP_ARM。

对于第一阶段的软件协同验证，COOP_START 可以直接进入现有 0x52/0x12 主线。对于后续相干模式，则建议在 Query 生成完成后增加 QUERY_READY/WAIT_T0 状态，等到统一执行时刻再进入 xmitQueryCmd()。

## 6.1 推荐状态定义

状态 | 含义 | 典型进入条件 | 典型退出条件
IDLE | 空闲 | 上电或任务结束 | 收到配置
CONFIGURED | 协同参数已写入 | Role/Group/RF 参数完成 | 本地检查通过
READY | 具备启动条件 | 配置和硬件状态正常 | 收到 START/ARM
ARMED | 已接收本轮任务，等待 T0 | 相干模式收到 ARM | 本地时间到达 T0
RUNNING | 正在盘存 | 进入 0x12 / RFID 协议流程 | 任务结束或 STOP
ERROR | 异常状态 | 网络、RF、参数或芯片错误 | 复位/重配

## 6.2 现有 0x52 的改造建议

0x52 可以继续保留为自定义控制入口，但建议增加子命令或扩展字段，使其从单纯的“立即开始”语义升级为协同控制帧。第一版最少应支持 PREPARE、START、STOP、STATUS；相干版再增加 ARM 和 START_TIME/T0。具体字节编码应由现有协议规范和兼容要求决定，本方案仅给出逻辑字段，不直接虚构字节值。

逻辑字段 | 用途 | 第一阶段是否必须
CMD_TYPE | PREPARE / START / ARM / STOP / STATUS | 必须
GROUP_ID | 协同组标识 | 建议必须
NODE_ID | 节点标识 | 建议必须
ROLE | Master / Slave / Standalone | 必须
ROUND_ID | 本轮协同盘存编号 | 建议必须
MODE | 普通协同 / 相干模式 | 必须
START_TIME(T0) | 统一执行时刻 | 相干阶段必须
PARAM_VERSION | 协同参数版本 | 可选

# 7 共享 48 MHz 频率同步设计

现有方案中多端机共用同一个 48 MHz 参考时钟，这一设计建议继续保留，并在新版技术方案中明确其工程作用：公共参考主要用于压低端机之间的长期频率偏差，使各端机 PLL 的频率基准一致。相比每台端机使用独立 TCXO 的方案，这会显著降低后续相位持续漂移的压力。

Δφ(t) = 2π·Δf·t + Δφ₀

当 Δf 被公共参考显著压低后，系统主要面对的是固定或缓慢变化的相位偏差 Δφ₀，以及不同射频链路、PLL 初相、线缆和空间传播带来的路径相位差。需要注意，共用 48 MHz 不等同于 RF 绝对相位天然一致，也不等同于两台端机的软件计数器具有相同起点。

# 8 时间同步与统一执行时刻 T0

## 8.1 为什么不能直接用 Ethernet 到达时刻作为发射时刻

即使上位机增加一个“协同盘存”按钮，内部依次向两个 IP 地址发送 START 报文，报文仍会经历操作系统调度、协议栈、交换机、端机 MAC/MCU 处理等不同延迟。更重要的是，这些延迟存在抖动。因此第一阶段的单按钮可以消除人工点击产生的几十毫秒甚至更大的差异，但不能直接视为 RF 精确同步。

建议把网络报文从“立即执行命令”升级为“提前下发任务”。在相干模式下，端机完成 Query 准备后进入 ARMED，等待本地统一时间基准到达 T0，再触发真正的发送流程。

## 8.2 T0 的工程实现路线

T0 机制可以分阶段实现。近期可以先通过软件统一启动并实测 Query 包络时间差，得到真实系统数据；中期在端机中增加硬件或高精度定时器和统一时间基准；后续根据 MCU/Ethernet MAC 能力考虑 PTP 硬件时间戳，或者利用 Master 的 RF Query 前导进行 OTA 时间校准。

阶段 | 同步机制 | 主要目标
V1 | 一个协同盘存按钮 + Ethernet START | 消除人工点击误差，建立组级协同
V2 | READY / ROUND_ID / 状态确认 | 保证任务一致性与可追踪性
V3 | 实测 Query 包络 Δt | 确定真实同步误差来源
V4 | ARM + T0 + 本地 Timer | 把网络到达时间与 RF 执行时间解耦
V5 | PTP/硬件时间戳或 OTA 时间校准 | 提高多端机时间一致性

# 9 RF 相位协同与相干发射

时间同步解决的是“Query 什么时候开始”，但相干增强还需要解决“相同 RF 波形在目标位置是否具有合适相位”。对于两路等幅信号，目标点的叠加功率取决于相位差。

P = P₁ + P₂ + 2√(P₁P₂)·cos(Δφ)

当两路等幅且 Δφ = 0° 时，相对单路理论上可以获得约 6 dB 功率提升；当相位偏差增大时，相干增益下降。因此公共 48 MHz 主要压低 Δf，移相器和相位校准机制负责补偿 Δφ。

建议近期先采用固定场景标定：在目标点测量功率或相位，扫描 Slave 移相器寻找增强点并记录补偿值。后续再升级为 OTA Master-Slave 相位反馈闭环。该分阶段路线可以避免同时引入网络同步、协议同步和实时相位闭环三个复杂变量。

# 10 三层同步架构

图 10-1 协同系统分层同步关系

技术方案中应把不同层次的“同步”严格区分，避免软件、硬件和 RF 团队使用同一个词却指不同问题。以太网协同层负责让节点处于同一个任务和轮次；公共 48 MHz 负责频率基准；T0/Timer/PTP/OTA 负责时间对齐；移相器和 RF 校准负责相位对齐。

这种分层还便于故障定位。例如两个端机频率一致但 Query 包络错位，优先检查时间同步；Query 同时出现但目标点功率没有增强，优先检查相位和幅度；两个节点进入不同 Q 参数，则应检查 Master/Slave 协议参数同步，而不是检查 RF。

# 11 软件改造建议

## 11.1 上位机侧

上位机侧建议新增协同组管理模块，同时保持现有单端机控制页。协同组模块至少负责节点选择、角色配置、参数一致性检查、状态收集和单按钮协同盘存。第一版不必追求复杂的自动 Master 选举，可以由用户在界面上手工选择 Master/Slave。

点击“协同盘存”后，上位机应先确认所有节点处于 READY，再下发同一 Round ID 的 START/ARM。任何节点未 READY 时，应阻止组级盘存并在界面上明确显示原因。

## 11.2 端机侧

端机侧建议在现有 0x52 处理逻辑前增加协同控制解析，在 protocol_scheduler/INVENTORY_18k6c 周围增加 Role 和协同状态判断。不要在第一版中重写 FM13RD 底层驱动；优先通过增加状态变量和参数镜像完成兼容性改造。

建议逻辑（示意，不代表现有源码）：

收到 PREPARE：

保存 Group_ID / Role / Mode / Round_ID

应用本地 RF 参数

状态 = READY

回复 READY

收到 START：

if 状态 != READY:

拒绝启动

else:

进入现有 0x52 → 0x12 盘存主线

相干模式：

Master：invDynamicQ → 生成本轮关键参数

Slave ：加载 Master 参数

两端生成一致 Query

状态 = QUERY_READY / ARMED

等待 T0

→ xmitQueryCmd()

# 12 不建议采用的实现方式

第一，不建议继续依赖人工分别点击两个盘存按钮作为协同方案，因为它只能实现两个独立 Reader 的先后启动，不能形成可重复的组级时序。

第二，不建议把普通 Ethernet 报文到达时刻直接定义为 RF 同步触发时刻。网络适合提前传递任务和时间信息，但精确执行应下沉到端机本地。

第三，不建议在需要同波形发射时让 Master 和 Slave 各自独立运行 Dynamic Q 决策。这样会造成 Query 内容不一致。

第四，不建议第一版就让每一个 Query、RN16、ACK 等 RFID 命令都通过 Ethernet 在端机间实时转发。Gen2 交互时序较紧，网络调度和软件栈的不确定性会显著增加实现难度。更合理的边界是“以太网负责盘存任务/轮次级协同，端机本地负责协议细节时序”。

# 13 验证与测试方案

## 13.1 V1 软件组网功能验证

首先完成两个端机通过交换机连接上位机，支持 Role/Group 配置和一个“协同盘存”按钮。测试重点是确认两个节点能够稳定进入同一 Round ID、均返回 READY、均收到 START，并且单机调试功能不受影响。

## 13.2 Query 包络同步误差测试

V1 完成后应立即测量两台端机实际 RF Query 的起始时间差。建议在保证仪器安全的前提下，通过合适衰减将两路 RF 输出接入示波器或先经过包络检波后接两个通道，重复触发多次，统计 Δt_Query 的平均值、最大值和抖动范围。

Δt_Query = t_Query,Slave − t_Query,Master

该测试结果决定下一步是否必须把同步点继续下沉到 xmitQueryCmd()、FM13RD 发送触发层，或者通过 T0/硬件 Timer 执行。设计报告中不要用估算替代这一关键实测数据。

## 13.3 频率与相位验证

在公共 48 MHz 条件下测量两端机 922.5 MHz 输出频率差和相位稳定性，确认共享参考是否真正进入两套 RF 生成链路。随后固定目标位置，保持两路功率接近，扫描 Slave 移相器并记录目标点功率曲线。若出现稳定的周期性增强/抵消关系，可作为相干控制链路有效性的直接证据。

测试编号 | 测试内容 | 判定目的
NET-01 | 节点上线、IP 与 Node ID 识别 | 确认网络基础连接
COOP-01 | Master/Slave 角色配置 | 确认软件定义角色有效
COOP-02 | READY / START / Round ID | 确认组级状态机闭环
TIME-01 | 两端 Query 包络 Δt 统计 | 量化 Ethernet+软件启动误差
CLK-01 | 公共 48 MHz 与 922.5 MHz 频差 | 确认频率基准同步
PHASE-01 | 移相扫描与目标点功率 | 验证相位可控与相干趋势
RF-COH-01 | 两路协同相对单路功率提升 | 验证最终相干增强效果

# 14 风险与工程边界

风险 | 影响 | 建议措施
Ethernet 启动抖动 | Query 起始时刻不稳定 | 采用 READY + ARM + T0，将网络到达时间与执行时间解耦
Master/Slave Query 参数不一致 | 调制波形不同，无法协同 | Master 决策、Slave 镜像关键参数
共享时钟但 RF 初相不一致 | 目标点相干增益不稳定 | 移相器标定，后续 OTA 相位闭环
Timer 起点不一致 | 即使频率相同仍无法按同一 T0 执行 | 增加时间同步/硬件时间戳/OTA 时间校准
底层 FM13RD 发送延迟未知 | 软件同步点与 RF 实际时刻存在偏差 | 示波器实测 xmitQueryCmd 到 RF 的行为
一次性改动过大 | 难以定位问题 | 按 V1~V5 分阶段实现并保留单机模式

# 15 分阶段实施计划

推荐按照“先组网、再测量、再精同步、最后相干”的顺序推进。该顺序能够让每一阶段都有独立可验证结果，避免出现协同失败后无法区分是上位机、Ethernet、协议参数、时间同步还是 RF 相位的问题。

版本阶段 | 主要改动 | 交付结果
V1 | 协同组 + Role + 单按钮协同盘存 | 两个端机由独立控制升级为组级任务
V2 | READY / Round ID / 状态与错误处理 | 形成可追踪的控制闭环
V3 | Query 包络 Δt 实测与日志 | 得到真实同步误差模型
V4 | ARM + T0 + 本地 Timer | 建立确定性启动框架
V5 | 时间校准 + 移相标定 | 具备稳定协同发射能力
V6 | OTA 相位/时间闭环（可选） | 向 PushID 类动态协同演进
V7 | 相干增益完整验证 | 形成系统级性能证明

# 16 与 PushID 思路的关系

本方案借鉴 PushID 中“多个完整 Reader 组网、指定 Master/Slave、通过同步保证协同发射”的系统思想，但不直接照搬其实现。PushID 原型需要面对多个独立时钟节点的频率与时间同步问题；本项目已经具备公共 48 MHz 参考，因此可以优先利用现有硬件降低长期频偏，再把主要工程资源放在组级控制、统一执行时刻和 RF 相位校准上。

因此，本项目更适合采用“共享频率参考 + Ethernet 控制协同 + 本地 T0 执行 + RF 相位补偿”的路线。若后续需要支持远距离分布式节点、不方便共享 48 MHz，再考虑引入更完整的 OTA Master-Slave 同步机制。

# 17 结论

现有技术方案的核心射频链路和 FM13RD 盘存调用链可以继续保留。以太网协同改造的重点不是更换射频器件，而是把上位机从“分别控制多个端机”升级为“管理一个协同组”，把端机从“收到盘存立即执行”升级为“配置、READY、任务、必要时 ARM/T0 后执行”，并把 Master/Slave 的协议职责明确下来。

最终技术路线可以概括为：以太网负责让所有节点执行同一个任务；公共 48 MHz 负责让各端机具有统一频率基准；时间同步和 T0 负责让任务在可控时刻执行；移相器及相位校准负责让多路 RF 在目标处形成相干增强。该分层设计既兼容当前系统，又为后续两点式、多点式和 PushID 类分布式协同提供了扩展基础。

# 附录 A Mermaid 架构图源码

以下 Mermaid 源码用于后续在 Markdown、Typora、Obsidian 或研发文档平台中复用系统架构图。

flowchart TD

PC[上位机协同控制软件]

SW[以太网交换机]

A[可重构端机 A<br/>Role = Master]

B[可重构端机 B<br/>Role = Slave]

TAG[RFID 标签/目标区域]

CLK[公共 48 MHz 参考时钟]

DIV[时钟功分/分配]

PC -->|配置/角色/READY/协同盘存| SW

SW --> A

SW --> B

A -->|RF 发射与接收| TAG

B -->|RF 发射与接收| TAG

CLK --> DIV

DIV -->|频率基准| A

DIV -->|频率基准| B

flowchart TD

A[分别配置端机参数] --> B[节点返回 READY]

B --> C[点击协同盘存]

C --> D[0x52 协同控制帧]

D --> E[注入 0x12]

E --> F[handle_tag_query]

F --> G[CMD_18K6CINV]

G --> H[protocol_scheduler]

H --> I[INVENTORY_18k6c]

I --> J{Role}

J -->|Master| K[invDynamicQ<br/>确定关键盘存参数]

J -->|Slave| L[加载/镜像 Master 参数]

K --> M[生成一致 Query]

L --> M

M --> N[QUERY_READY / ARMED]

N --> O[等待 T0]

O --> P[xmitQueryCmd]

P --> Q[TxBuffer → FM13RD TX FIFO]

Q --> R[RF 发射]

# 附录 B 参考文献

[1] Jingxian Wang, Junbo Zhang, Rajarshi Saha, Haojian Jin, Swarun Kumar, “Pushing the Range Limits of Commercial Passive RFIDs,” 16th USENIX Symposium on Networked Systems Design and Implementation (NSDI 2019), pp. 301–316.

[2] IEEE 1588, Precision Clock Synchronization Protocol for Networked Measurement and Control Systems. 本方案仅将其作为后续时间同步候选技术，是否采用取决于端机 MCU/Ethernet MAC 的硬件时间戳能力。

可重构 RFID 端机以太网协同通信与 Master-Slave 同步技术方案
