lyy622516-web/basestation/01_技术方案与设计报告/设计思考/20260904可重构RFID端机_相干增强与PushID分布式同步理论分析.docx

# 可重构 RFID 端机相干增强与 PushID 分布式同步理论分析

面向 922.5 MHz 多端机协同与相干增强设计

公式格式：Word 原生公式（可编辑）

2026-09-04

# 1. 文档目的

本文面向现有可重构 UHF RFID 端机方案，对多端机相干增强的基本理论进行系统整理，并结合 PushID 论文 Pushing the Range Limits of Commercial Passive RFIDs 中的分布式 MIMO、Master-Slave 频率同步、时间同步和多节点扩展方法，分析这些理论如何映射到当前“Ethernet 协同组网 + 公共 48 MHz 参考时钟 + 软件定义 Master/Slave + 移相器”的端机架构。

本文重点讨论的是多端机如何形成可控的相干发射条件，而不是上位机界面如何配置。公式均采用复数基带和相位模型表达，便于后续直接作为技术报告中的“相干增强工作原理”和“多端机同步理论”章节使用。

# 2. 多端机相干增强基本原理

## 2.1 两路同频信号的相干叠加

对于两路频率相同的射频信号，可分别表示为

s_1 (t)=A_1 cos(2πft+ϕ_1 )

s_2 (t)=A_2 cos(2πft+ϕ_2 )

两路信号经过各自的射频链路和空间传播后，在目标位置形成合成场。若以到达目标位置后的功率分别记为 P_1 、 P_2 ，两路信号在该位置的相位差记为 Δϕ ，则合成功率可表示为

P_(sum) =P_1 +P_2 +2√(P_1 P_2)cos(Δϕ)

当两路到达功率相等，即

P_1 =P_2 =P_0

且相位差满足

Δϕ=0^(∘)

两路信号完全同相，得到

P_(sum) =4P_0

因此相对于单路发射，理想功率增益为

G_(coh) =10log_10 ((4P_0)/(P_0))≈6 dB

这就是两路等幅信号相干增强能够获得理论 6 dB 增益的根本原因。这里的 6 dB 并不是“两台设备各自增加 3 dB”简单相加，而是由于两个电场矢量同相相加后，场幅翻倍，功率与场幅平方成正比，因此功率变为单路的 4 倍。

当 Δϕ 不为零时，相干增益会下降；当 Δϕ=180^(∘) 且两路等幅时，两路信号发生理想相消。因此，相干增强最核心的控制量不是“两个端机是否同时打开”，而是它们在目标位置处的幅度关系和相位关系。

## 2.2 相位差的来源

对于两个独立的发射端机，目标位置处的总相位差可以分解为本振/PLL 初相、射频链路相位和空间传播相位等部分，可写为

Δϕ_(tot) =Δϕ_(RF) +Δϕ_(chain) +Δϕ_(channel)

其中， Δϕ_(RF) 表示两个端机载波源本身的相位差， Δϕ_(chain) 表示滤波器、放大器、射频开关、线缆等链路产生的相位差， Δϕ_(channel) 表示空间传播路径产生的相位差。

因此，即使两个端机设置为相同的 922.5 MHz，目标位置仍然不一定同相。移相器的作用就是在已知或可估计的相位误差基础上，增加一个可控补偿量 ϕ_c ，使得

Δϕ_(tot) +ϕ_c ≈0

从而使目标点进入相干增强状态。

## 2.3 频率偏差导致的相位漂移

若两个端机存在载波频率偏差 Δf ，即使在某一时刻已经调到同相，相位关系仍会随时间持续变化：

Δϕ(t)=2πΔf t+Δϕ_0

其中 Δϕ_0 为初始相位差。由此可见，固定移相器只能补偿固定相位误差；如果 Δf 较大，相位会不断旋转，最大增强点也会不断漂移。

当前端机采用公共 48 MHz 参考时钟，其重要意义就在于显著减小不同端机的长期频率偏差，使 Δf 尽可能接近零，从而把问题从“不断追赶快速相位漂移”简化为“校准固定或缓慢变化的相位偏差”。但公共参考并不能保证两套 PLL 的绝对射频初相天然一致，因此仍然需要相位校准或移相补偿。

## 2.4 时间误差与射频相位的关系

同一正弦载波如果存在时间偏移 Δt ，也会表现为相位偏移：

Δϕ_(time) =2πfΔt

在 f=922.5 MHz 时，载波周期为

T_(RF) =1/(922.5×10^6)≈1.084 ns

因此，纳秒级时间误差对于载波相位已经非常显著。这个关系说明：Ethernet 可以承担协同控制和任务下发，但普通网络报文的到达时间不能直接等价为 RF 载波相位同步。网络同步解决的是“多个端机执行同一任务”，而真正的载波相干还需要公共频率参考、确定的发射时序以及相位补偿共同保证。

# 3. 多端机分布式波束形成模型

PushID 将多个空间分离的 RFID Reader 看作分布式 MIMO 发射节点。对于 L 个发射节点，可将其复数波束形成权重写为

b=[w_1 ,w_2 ,…,w_L ]^T

其中

w_l =a_l e^(jθ_l)

a_l 表示第 l 个节点的幅度权重， θ_l 表示其发射相位控制量。对于空间中的目标点 j ，定义从各 Reader 到该点的复信道向量为

h_j =[h_(1j) ,h_(2j) ,…,h_(Lj) ]^T

在自由空间近似下，第 l 个 Reader 到目标点 j 的信道可以表示为

h_(lj) =(α_(lj))/(d_(lj))e^(−j(2πd_(lj))/λ)

其中 d_(lj) 为传播距离， λ 为波长， α_(lj) 可用于综合表示天线方向图、极化和其他幅度衰减因素。目标点接收到的复数合成幅度与

b^T h_j

成正比，因此该点的接收能量可写成

E_j ∝|b^T h_j |^2

PushID 的本质就是通过选择不同的波束形成向量 b ，改变各 Reader 的相位与幅度，使空间中不同位置形成能量峰值和谷值。当某个目标点满足

|b^T h_j |^2 >τ

其中 τ 为无源 RFID 标签能够被激活并产生有效响应所需的能量阈值，则该波束形成向量能够“覆盖”该位置。[1]

对于当前两端机方案，上述分布式 MIMO 模型可以简化为两个节点。Master 端机的幅度和相位作为参考，Slave 端机通过可调衰减和移相改变 w_2 ，本质上就是在搜索一个合适的二维波束形成权重，使目标位置的 |b^T h_j |^2 最大。

# 4. PushID 的 Master-Slave 分布式同步理论

## 4.1 为什么 PushID 需要专门做同步

PushID 要求多个空间分散的 RFID Reader 同时参与分布式 MIMO。论文指出，RFID 场景相比 Wi-Fi 有两个突出困难：一是 RFID 交互持续时间更长，残余频偏会在较长时间内积累成明显的相位漂移；二是 RFID 信号本身较窄带，直接利用宽带相位斜率估计时延比 Wi-Fi 更困难。[1]

PushID 因此采用 Master-Slave 架构：指定一个 Reader 作为 Master，其余 Reader 作为 Slave。Slave 的目标不是独立产生任意相位，而是不断估计自己相对于 Master 的频率、相位和时间误差，并在发射时进行补偿，使多个 Reader 的波形能够保持相干关系。[1]

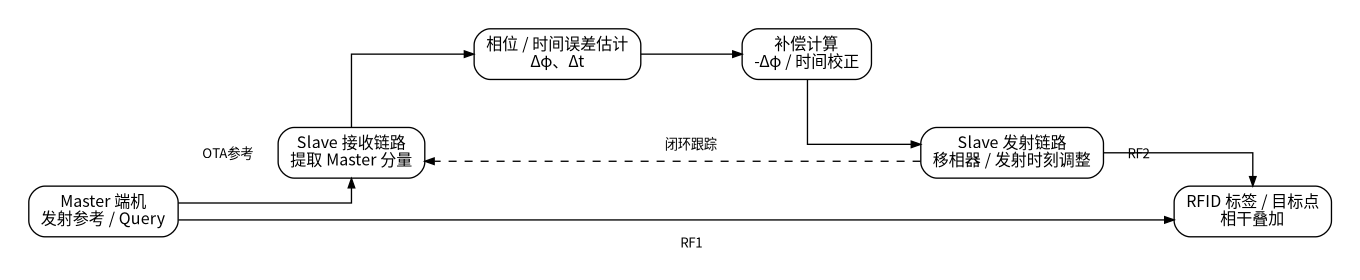
[picture p74: figure]

PushID 类 Master-Slave OTA 闭环同步原理

## 4.2 全双工条件下的 Master 相位提取

PushID 利用了 RFID Reader 的全双工特性。Slave 在自身也进行发射时，接收端观测信号可抽象为

y_S (t)=h_(MS) x_M (t)+h_(SS) x_S (t)+n(t)

其中 x_M (t) 为 Master 发射信号， x_S (t) 为 Slave 自身发射信号， h_(MS) 为 Master 到 Slave 的无线信道， h_(SS) x_S (t) 为 Slave 的自干扰分量。

若 Slave 能够利用已知的自身发射波形消除或抑制自干扰，则得到近似的 Master 分量

y_S (t)≈h_(MS) x_M (t)+n(t)

Slave 就可以从该参考中估计 Master 的相位随时间如何变化。这一点是 PushID 频偏闭环补偿的基础。[1]

## 4.3 频偏的闭环补偿

PushID 首先完成初始相位同步，然后持续观察 Master 相位是否随时间漂移。若在相邻两次同步之间观测到 Master 相位变化量

δϕ_M =phase(t+Δt)−phase(t)

则 Slave 对自己的发射相位施加反向补偿

ϕ_(S,new) =ϕ_(S,old) −δϕ_M

从控制角度看，这是一个典型闭环：测量相位漂移，估计残余频偏带来的相位误差，再把误差的负值反馈到 Slave 发射相位中。这样即使初始同步以后仍存在很小的残余频差，系统也能持续抑制相位漂移。[1]

这一思想与当前端机方案具有直接对应关系。当前公共 48 MHz 已经能够从硬件上显著减小 Δf ，因此闭环补偿所面对的残余频偏通常会比 PushID 的独立时钟场景更小。现阶段可以先使用移相器扫描完成开环校准，后续再增加 OTA 相位测量，把固定相位值升级为动态闭环补偿。

## 4.4 粗时间同步：利用 Query 已知前导

PushID 的时间同步分为粗同步和细同步。粗同步利用 RFID Query 命令具有已知前导这一特点。Slave 接收 Master 的 Query，并将接收序列 y[n] 与已知前导模板 p[n] 做相关：

R_(yp) [k]=∑_n^() y[n]p^(*) [n−k]

相关峰位置可用于估计 Master 信号的到达位置

k_(max) =argmaxk|R_(yp) [k]|

若采样周期为 T_s ，则粗时间偏移可近似表示为

Δt_(coarse) =k_(max) T_s

PushID 论文中正是利用 Query 的已知 preamble 进行符号级粗对齐，并通过多次相关提高可靠性。[1]

对于当前可重构端机，这一思路很有价值，因为现有盘存流程中本来就会产生标准 Query。后续若希望减少单纯依赖 Ethernet START 所带来的不确定性，可以让 Slave 监听 Master 实际发出的 Query，并把其前导作为真实 RF 时间参考。

## 4.5 细时间同步：频率-相位斜率法

一个时间偏移 Δt 会在不同射频频率上产生不同相位偏移：

Δϕ(f)=2πfΔt+ϕ_0

因此相位关于频率的斜率为

m=(dϕ)/(df)=2πΔt

于是可以反推出时间偏移

Δt=m/(2π)

PushID 利用了 UHF RFID 在 900 MHz ISM 频段内的跳频特性，在多个工作频率上测量 Master 的相位，并通过线性拟合估计相位-频率曲线的斜率，从而获得细时间漂移。[1]

这一方法与当前固定 922.5 MHz 的实验条件并不完全相同。如果现阶段只在单一频点进行相干增强验证，则无法直接复现这种跨频率斜率估计；此时更现实的做法是利用共享 48 MHz 降低频漂，使用 Query 包络或硬件 Timer 解决发射时刻对齐，再通过移相器补偿固定 RF 相位误差。若后续恢复跳频工作，则可以进一步考虑 PushID 的细时间同步思想。

## 4.6 多节点扩展：生成树同步

当系统从两个 Reader 扩展到多个分布式 Reader 时，并非所有 Slave 都一定能够直接可靠接收到 Master。PushID 因此构造以 Master 为根节点的同步生成树，使距离 Master 较远的 Slave 可以先同步到附近已同步节点，再间接继承 Master 的时间和频率基准。[1]

这一思想与当前 Ethernet 组网中的“1 Master + N Slave”具有很好的架构兼容性。当前端机若主要部署在同一实验区域并且共享 48 MHz，可暂时不需要复杂的多跳 RF 同步；但在未来远距离、多区域部署且无法共用参考时钟时，可以把每个 Slave 的“参考节点”抽象成软件可配置关系，从两节点主从逐步扩展成同步树。

# 5. PushID 理论与当前可重构端机方案的对应关系

当前方案和 PushID 的共同点是：多个完整 RFID 端机参与同一协同任务，需要通过角色划分和同步控制保证 RF 信号能够形成有效的分布式合成。不同点在于，PushID 原型的 USRP 节点使用独立时钟，因此必须主动估计并补偿频率和时间偏差；当前可重构端机已经设计公共 48 MHz 参考时钟，从硬件层先解决了最主要的频率基准统一问题。[1]

因此，当前方案可以把同步问题分成三个层次理解。Ethernet 负责端机之间的协同组网和信息交换，它决定“哪些节点参与、谁是 Master、谁是 Slave、需要执行什么协同任务”；公共 48 MHz 负责“各端机的长期频率基准是否一致”；移相器和后续 OTA 校准负责“各路信号到达目标位置后是否满足相干相位关系”。如果进一步要求 Query 起始时刻也高度一致，则需要再增加确定性时间同步机制，例如统一执行时刻 T_0 、本地硬件 Timer 或利用 Master Query 进行 OTA 时间校准。

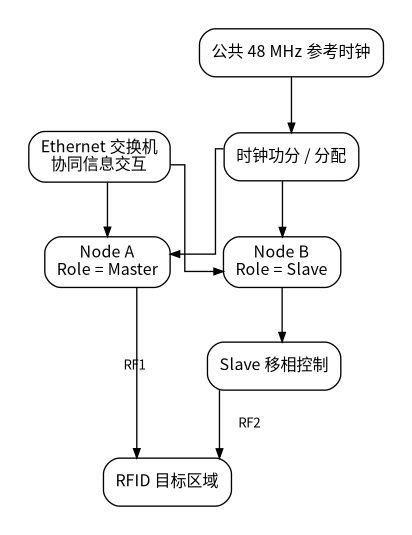
[picture p75: figure]

当前端机的 Ethernet 协同、公共时钟与相干增强关系

从当前项目的实现难度看，最合理的演进路线不是一步完全复现 PushID，而是分阶段把关键理论映射到现有硬件中。第一阶段利用公共 48 MHz 保证同频，并通过 Slave 移相器全范围扫描，观察目标位置功率是否形成明显的周期性增强/减弱；第二阶段固定 Master/Slave 角色，并确保两路发射的 Query 参数和调制波形一致；第三阶段测量 Master 与 Slave 的 Query 起始时间差，必要时加入统一执行时刻；第四阶段再引入 OTA 相位测量和闭环补偿，使相干增强从静态标定升级为动态跟踪。

# 6. 对当前设计最关键的理论结论

对于现有可重构端机，公共 48 MHz 并不是“相干增强已经完成”的充分条件，而是把困难的独立频率同步问题大幅简化。真正的相干条件仍然要求相同工作频率、可接受的波形时间对齐、相同或兼容的 RFID 调制内容、以及目标位置处受控的相位差。

从数学上看，相干增强最终只取决于每个节点复权重与空间信道的乘积之和，即

E_j ∝|∑_(l=1)^L w_l h_(lj) |^2

因此，对于当前两端机验证系统，只要能够使两路 w_l h_(lj) 在目标位置接近同相，就可以观察到相干增强；对于未来多端机系统，则需要进一步解决更多节点的权重选择、同步传播和空间多径问题。

PushID 给当前项目最有价值的启发并不是必须完全复制其算法，而是建立了一条清晰的工程逻辑：先建立 Master-Slave 参考关系，再从频率、时间和相位三个维度逐层消除误差，最终让分布式 Reader 的发射信号具有稳定的相干关系。当前项目使用共享 48 MHz，可以把其中的频率同步大幅简化，而把重点放在 Ethernet 协同、Query 时序一致性和 RF 相位补偿上。

# 7. Mermaid 图源码

下面给出可用于后续 Markdown/技术笔记中的 Mermaid 图源码。

flowchart LR
CLK[公共48 MHz参考时钟]
ETH[Ethernet协同网络]
M[Master端机]
S[Slave端机]
PH[移相与相位校准]
TAG[RFID目标区域]

CLK --> M
CLK --> S
ETH --> M
ETH --> S
M -->|RF1| TAG
S --> PH
PH -->|RF2| TAG

flowchart LR
M[Master RF参考 / Query]
RX[Slave接收Master]
EST[估计 Δφ / Δt]
CTRL[计算补偿量]
TX[Slave移相 / 时间调整]
TAG[目标点相干叠加]

M --> RX
RX --> EST
EST --> CTRL
CTRL --> TX
M --> TAG
TX --> TAG
TX -.闭环跟踪.-> RX

# 参考文献

[1] Jingxian Wang, Junbo Zhang, Rajarshi Saha, Haojian Jin, Swarun Kumar. “Pushing the Range Limits of Commercial Passive RFIDs.” 16th USENIX Symposium on Networked Systems Design and Implementation (NSDI 2019), pp. 301-316, 2019.
