lyy622516-web/basestation/01_技术方案与设计报告/设计思考/20260907协议.docx

在盘存命令之前，先进行一个上位机和两台端机的同步，比如先做准备信息的下发，然后两台端机各自进行响应，比如说A先到达上位机完成响应有一个时间戳，B后到达上位机响应又有一个时间戳，这样两个时间戳对比就有一个两台端机传输时延差，在上位机下发给两个端机时可以人为补偿这个时延差，这个时延可能会不固定，我们可以规定经过十个盘存周期之后，对这个时延进行一个重新计算
