lyy622516-web/basestation/01_技术方案与设计报告/设计思考/20260909ISO18000-6C_T1_T2阈值计算_5-320kbps.docx

ISO/IEC 18000-6C 标签后向散射速率下 T1/T2 时序阈值计算

— 按用户文档计算口径，并结合协议表 11 / 表 12 / 表 13 校核 —

1. 计算目标与结论说明

本文以用户提供文档中的示例参数 Tari = 25 μs、RTcal = 75 μs 为固定前向链路条件，按照 ISO/IEC 18000-6C 的 T1/T2 公式，计算标签后向散射数据速率从 5 kbps 到 320 kbps 时的时序阈值。

• 协议规定 Miller 副载波数据速率为 R = LF/M，其中 M ∈ {2,4,8}；因此“数据速率 R”本身不能唯一决定 T1/T2，必须同时知道 M（或等价地知道 LF）。

• 主表列出 5、10、20、40、80、160、320 kbps 这些代表性速率下所有满足 40 kHz ≤ LF ≤ 640 kHz 的 Miller 组合。它们覆盖用户要求的最低到最高 320 kbps 范围，但不是说协议只允许这些离散速率。

• T1/T2 最终应以 FM13RD1616/E 实际 Query 中的 DR、M、TRcal 为准；本表可直接作为底层代码排查和时延预算的计算模板。

2. 协议依据与计算公式

ISO/IEC 18000-6C 表 12 给出标签到读写器的数据速率关系：FM0 时数据速率等于 LF；Miller 副载波时数据速率为 LF/M。表 13 定义 T1、T2 的时序窗口；Tpri = 1/LF。FT 取表 11 中的标签链路频率容差。

R_tag = LF / M

LF = M × R_tag

Tpri = 1 / LF

B = max(RTcal, 10 × Tpri)

T1_min = B × (1 − FT) − 2 μs

T1_typ = B

T1_max = B × (1 + FT) + 2 μs

T2_min = 3 × Tpri

T2_max = 20 × Tpri

采用 kbps / kHz / μs 单位时，可直接写成：

Tpri[μs] = 1000 / (M × R_tag[kbps])

T2_min[μs] = 3000 / (M × R_tag[kbps])

T2_max[μs] = 20000 / (M × R_tag[kbps])

3. FT 取值口径

FT 并不是单纯由“数据速率”决定，而是由 DR、TRcal 和 LF 在协议表 11 中的位置决定。为了与用户文档的示例完全衔接，主表采用“正常温度、文档一致/偏保守”的 FT 口径：

LF (kHz) | 主表采用 FT | 说明
40 | 4% | DR=8 的低 LF 区间
80 | 4% | DR=8，40<LF<107 kHz 区间
160 | 10% | 为复现用户文档示例，采用 FT=10% 的保守口径
320 | 10% | 协议表 11 的 320 kHz 标称点
640 | 15% | DR=64/3、LF=640 kHz 标称点

边界说明：用户文档在 LF=160 kHz 时直接采用 FT=10%，从而得到 T1=65.5~84.5 μs。严格按协议表 11 的某些精确 DR/TRcal 组合（例如 DR=8、TRcal=50 μs）可得到 FT=7%，此时 T1 会变为 67.75~82.25 μs。为保证与原文档计算结果一致，主表保留 10% 口径；实际写入技术报告或固件前，应根据 FM13 的真实 DR/TRcal 再做一次最终校核。

4. Miller 5~320 kbps 的 T1/T2 完整代表性计算表

固定条件：Tari=25 μs，RTcal=75 μs。表中同一数据速率出现多行，表示不同 M 会产生不同 LF，因此 Tpri、T1、T2 也会不同。

R_tag (kbps) | M | LF (kHz) | Tpri (μs) | FT | T1_min (μs) | T1_typ (μs) | T1_max (μs) | T2_min (μs) | T2_max (μs)
5 | 8 | 40 | 25 | 4% | 238 | 250 | 262 | 75 | 500
10 | 4 | 40 | 25 | 4% | 238 | 250 | 262 | 75 | 500
10 | 8 | 80 | 12.5 | 4% | 118 | 125 | 132 | 37.5 | 250
20 | 2 | 40 | 25 | 4% | 238 | 250 | 262 | 75 | 500
20 | 4 | 80 | 12.5 | 4% | 118 | 125 | 132 | 37.5 | 250
20 | 8 | 160 | 6.25 | 10% | 65.5 | 75 | 84.5 | 18.75 | 125
40 | 2 | 80 | 12.5 | 4% | 118 | 125 | 132 | 37.5 | 250
40 | 4 | 160 | 6.25 | 10% | 65.5 | 75 | 84.5 | 18.75 | 125
40 | 8 | 320 | 3.125 | 10% | 65.5 | 75 | 84.5 | 9.375 | 62.5
80 | 2 | 160 | 6.25 | 10% | 65.5 | 75 | 84.5 | 18.75 | 125
80 | 4 | 320 | 3.125 | 10% | 65.5 | 75 | 84.5 | 9.375 | 62.5
80 | 8 | 640 | 1.5625 | 15% | 61.75 | 75 | 88.25 | 4.6875 | 31.25
160 | 2 | 320 | 3.125 | 10% | 65.5 | 75 | 84.5 | 9.375 | 62.5
160 | 4 | 640 | 1.5625 | 15% | 61.75 | 75 | 88.25 | 4.6875 | 31.25
320 | 2 | 640 | 1.5625 | 15% | 61.75 | 75 | 88.25 | 4.6875 | 31.25

5. 关键结果解读

• 最低 5 kbps：只能采用 M=8、LF=40 kHz。Tpri=25 μs，T1=238~262 μs，T2=75~500 μs。低 LF 时 10Tpri 大于 RTcal，因此 T1 主要由 10Tpri 决定。

• 用户文档的 LF=160 kHz 示例可对应 Miller 20 kbps (M=8)、40 kbps (M=4) 或 80 kbps (M=2)。按原文档 FT=10% 口径，这三种组合都得到相同的 T1=65.5~84.5 μs、T2=18.75~125 μs，成功复现原文计算。

• 最高 320 kbps：只能采用 M=2、LF=640 kHz。Tpri=1.5625 μs，按 FT=15% 得 T1=61.75~88.25 μs，T2=4.6875~31.25 μs。此时真正紧张的是 T2，而不是 T1。

• 当 LF≥160 kHz 后，10Tpri 已小于 RTcal=75 μs，因此 T1 的中心值被 RTcal“钳住”在约 75 μs；但 T2 仍随 LF 增大而按 1/LF 快速缩短。

• 因此，在分布式/三点式结构中，如果“标签响应结束 → 主/从基站完成处理并开始下一条 Reader 命令”的整条路径落在 T2 约束内，则高后向链路速率会显著压缩网络、MCU、SPI 和 FM13 触发所能占用的时延预算。

关于此前 68 μs 测量值：该 68 μs 是三点式架构中主基站到辅助/从基站的信号转发链路时延，并不等同于交换机两个端口的 skew，也不能在未确认测量端点前直接当作 T1 或 T2。若后续确认这 68 μs 完整落在某个 T2 受限路径上，则在 LF=320 kHz 时 T2_max=62.5 μs、LF=640 kHz 时 T2_max=31.25 μs，均会出现超限风险；应以实际时序端点重新测量和分解。

6. 对 FM13RD1616/E 底层代码排查的直接要求

• 确认 Query 中 DR、M、TRcal 的真实设置位置；只有拿到这三个量，才能唯一确定 LF、FT 和最终 T1/T2。

• 确认 FM13 是否由芯片自动控制 T1/T2，还是 MCU 在 RN16/ACK/QueryRep 间负责软件调度；若由 MCU 参与，则需要统计中断、SPI/QSPI、Ethernet 和任务切换时延。

• 记录标签实际编码模式（FM0 / Miller）以及 M=1/2/4/8。若当前 FM13 固件固定使用某一种 M，可从主表中直接删去其他组合，形成最终工程阈值表。

• 对于双端机协同，最终应测“Tag 最后一位响应结束 → 下一条 Reader 指令 RF 第一边沿”的实际 T2，而不是只测上位机/交换机/MCU中的某一段软件时延。

附录 A：若 FM13 使用 FM0，40~320 kbps 的对应结果

FM0 对应 M=1，数据速率 R=LF。虽然 FM0 协议范围可到 640 kbps，但这里仅列到用户要求的 320 kbps。

FM0 R (kbps) | LF (kHz) | Tpri (μs) | FT | T1_min (μs) | T1_typ (μs) | T1_max (μs) | T2_min (μs) | T2_max (μs)
40 | 40 | 25 | 4% | 238 | 250 | 262 | 75 | 500
80 | 80 | 12.5 | 4% | 118 | 125 | 132 | 37.5 | 250
160 | 160 | 6.25 | 10% | 65.5 | 75 | 84.5 | 18.75 | 125
320 | 320 | 3.125 | 10% | 65.5 | 75 | 84.5 | 9.375 | 62.5

7. 计算示例：320 kbps

对于 Miller 320 kbps，仅有 M=2、LF=640 kHz 这一代表性组合：

LF = M × R = 2 × 320 = 640 kHz

Tpri = 1 / 640 kHz = 1.5625 μs

B = max(75, 10 × 1.5625) = 75 μs

T1_min = 75 × (1 − 0.15) − 2 = 61.75 μs

T1_max = 75 × (1 + 0.15) + 2 = 88.25 μs

T2_min = 3 × 1.5625 = 4.6875 μs

T2_max = 20 × 1.5625 = 31.25 μs

8. 来源与使用说明

• 用户提供《新建 DOCX 文档》：第 6 页表 2-3 及示例计算，给出 Tari=25 μs、RTcal=75 μs、LF=160 kHz、FT=10%，并得到 T1=65.5~84.5 μs、T2=18.75~125 μs。

• ISO/IEC CD 18000-6C 中文版：表 11（标签到读写器链接频率及 FT）、表 12（FM0/Miller 数据速率）、表 13（T1/T2 链路时序）。

• 本文主表按正常温度 FT 计算；非正常温度下 FT 可不同，如需做极限环境时序预算，应按表 11 的非正常温度列重新计算。

T1/T2 时序阈值计算 - ISO/IEC 18000-6C / FM13RD1616/E
