lyy622516-web/basestation/01_技术方案与设计报告/设计思考/20260918可重构端机接收链路灵敏度分析_两点式与三点式_160k_40k.docx

可重构超高频蜂窝物联网端机
接收链路灵敏度分析与预算

两点式自发自收模式 / 三点式收发分离模式
160 kbps 与 40 kbps 等效带宽案例

分析依据：白若明硕士论文、邹卓航硕士论文及当前可重构端机设计
编制日期：2026 年 9 月 18 日

# 结论摘要

本报告采用“热噪声 + 级联噪声系数 + 最小载噪比 + 工程余量”的标准接收灵敏度模型，并将自干扰作为独立于热噪声预算之外的附加限制项进行分析。白若明论文给出的接收灵敏度公式为 Smin=-174+10log10(BW)+NF+CNRmin，并指出 UHF RFID 接收灵敏度还会受到自干扰相位噪声、阻塞和链路线性度影响。因此，仅用芯片标称灵敏度直接加减耦合损耗，无法完整反映本端机的两点式和三点式接收能力。

按当前接收链路器件与典型参数计算，两点式接收链路的外部前端总增益约为 8.65 dB、级联噪声系数约为 10.63 dB；三点式基站 RX 支路总增益约为 37.25 dB、级联噪声系数约为 3.31 dB。两点式噪声系数主要被 10 dB 耦合接收路径所支配，而三点式噪声系数主要由接收开关、前置 BPF 及第一级 LNA 之前的损耗决定。

采用 CNRmin=10 dB、工程余量 M=3 dB，并以等效噪声带宽 Bn=160 kHz 和 40 kHz 分析时，两点式热噪声受限灵敏度分别约为 -98.33 dBm 和 -104.35 dBm，远优于 -74 dBm 指标。因此两点式在 33 dBm 发射条件下的实际灵敏度并非由热噪声决定，而主要由强自干扰、相位噪声、阻塞和压缩决定。三点式热噪声受限灵敏度分别约为 -105.65 dBm 和 -111.67 dBm，相对于 -100 dBm@-40 dBm 自干扰指标分别保留约 5.65 dB 和 11.67 dB 的理论余量。

从既有论文与当前样机测试结果看，邹卓航论文给出的两点式实测灵敏度约 -75 dBm，三点式在 -40 dBm 自干扰下达到 -100 dBm；当前可重构端机报告也记录了两点式约 -76 dBm、三点式 -100 dBm 的结果。上述实测结果与本报告的理论判断一致：两点式属于“自干扰受限”，三点式在低衰减高增益状态下属于“噪声系数 + 残余自干扰共同受限”。

# 1 分析依据与边界条件

## 1.1 两篇论文对本次分析的直接依据

白若明论文给出了完整的接收机灵敏度理论框架：在 290 K 条件下，以 -174 dBm/Hz 为热噪声密度，通过等效噪声带宽、接收机噪声系数和最低载噪比计算接收灵敏度；同时进一步指出，自干扰载波的相位噪声会抬高接收机噪声基底，因此强自干扰条件下不能只看热噪声。该论文还给出了级联噪声系数分析思路，并在一个 160 kHz 带宽、CNRmin=10 dB 的案例中直接使用灵敏度公式进行计算。

邹卓航论文则与当前端机硬件架构高度一致：两点式模式下，标签反向散射信号由天线进入 10 dB 定向耦合支路，再经过 SPDT、LNA、BPF 后进入 FM13RD1616E RX；三点式基站模式下，天线信号经过 SPDT 和 AGC 链路后分成 RX 与 LO 两路。论文实测结果给出了 -40 dBm 自干扰下约 -100 dBm 的三点式灵敏度，以及 33 dBm 发射下约 -75 dBm 的两点式灵敏度。

## 1.2 关于“PIE 160 kbps / 40 kbps”的说明

严格按照 ISO/IEC 18000-6C 的物理层定义，PIE 是读写器到标签的前向链路编码；标签到读写器的反向链路通常采用 FM0 或 Miller（MMS）编码。因此，读写器“接收灵敏度”本质上应按反向链路实际 BLF、FM0/Miller 编码及接收滤波器等效噪声带宽确定。用户本次要求以 160 kbps 和 40 kbps 的 PIE 编码信号为例，本报告将其作为两个“等效基带速率/噪声带宽案例”用于比较灵敏度随带宽的变化，方法本身可直接替换为实际反向链路 BLF。

白若明论文指出，PIE 的第一零点带宽随 PW 在约 80～320 kHz 之间变化；同时，增加 BLF/数据率会增加噪声带宽，从而恶化接收灵敏度。因此，本报告除按 Bn≈Rb（40 kHz、160 kHz）进行主预算外，还按 Bn≈2Rb（80 kHz、320 kHz）进行一组偏保守的工程校核。这里的 2Rb 仅作为带宽裕量校核，并非把 PIE 的第一零点带宽强制定义为 2Rb。

# 2 接收灵敏度理论模型

## 2.1 热噪声与灵敏度公式

在常温 T0=290 K 下，50 Ω 匹配系统的可用热噪声功率谱密度可近似写为 -174 dBm/Hz。设接收机等效噪声带宽为 Bn，总噪声系数为 NFtotal，解调所需最小载噪比为 CNRmin，则接收端口的热噪声受限灵敏度为：

P_sens = -174 + 10log10(B_n) + NF_total + CNR_min + M [dBm] (1)

其中 M 为工程余量。本报告采用白若明论文案例中的 CNRmin=10 dB，并取 M=3 dB，用于覆盖 PCB 走线、连接器、器件离散性、滤波器实际带宽以及芯片内部未公开噪声参数等未建模因素。

## 2.2 级联噪声系数

多级接收链路的总噪声因子采用 Friis 公式计算。所有增益和噪声因子先转为线性量；对于无源器件，若插入损耗为 L dB，则其功率增益为 10^(-L/10)，噪声系数在常温下可近似等于其插入损耗。

F_total = F_1 + (F_2-1)/G_1 + (F_3-1)/(G_1G_2) + ... (2)

该公式说明：第一级之前的无源损耗会直接恶化整个接收机噪声系数，而第一级高增益低噪声 LNA 之后的损耗贡献会被前级增益压低。因此，两点式的 10 dB 耦合接收路径是总 NF 的主要来源；三点式则应重点压低 SPDT、前置 BPF 等位于第一级 LNA 之前的损耗。

## 2.3 自干扰条件下的等效噪声

强自干扰并不能简单用“自干扰功率直接加到热噪声上”的方式处理。白若明论文基于距离相关效应指出，当解调 LO 与自干扰信号同源或高度相关时，残余相位噪声与 LO/自干扰相对时延有关，相关解调可以显著抑制一部分近端相位噪声。工程上可把自干扰产生的相位噪声、互调、压缩和阻塞等影响归结为附加等效噪声 N_SI。

N_SI(Δf) ≈ P_SI + L(Δf) + 10log10[4sin²(πΔf·t_d)] [dBm/Hz] (3)

其中 P_SI 为接收机输入端自干扰载波功率，L(Δf) 为载波单边带相位噪声，td 为 LO 与自干扰路径相对时延。由于当前资料没有给出 FM13/发射本振的完整相位噪声曲线和实际 td，本报告不虚构 N_SI 的具体数值，而是通过“为满足目标灵敏度，允许的带内附加干扰噪声上限”反推设计约束。

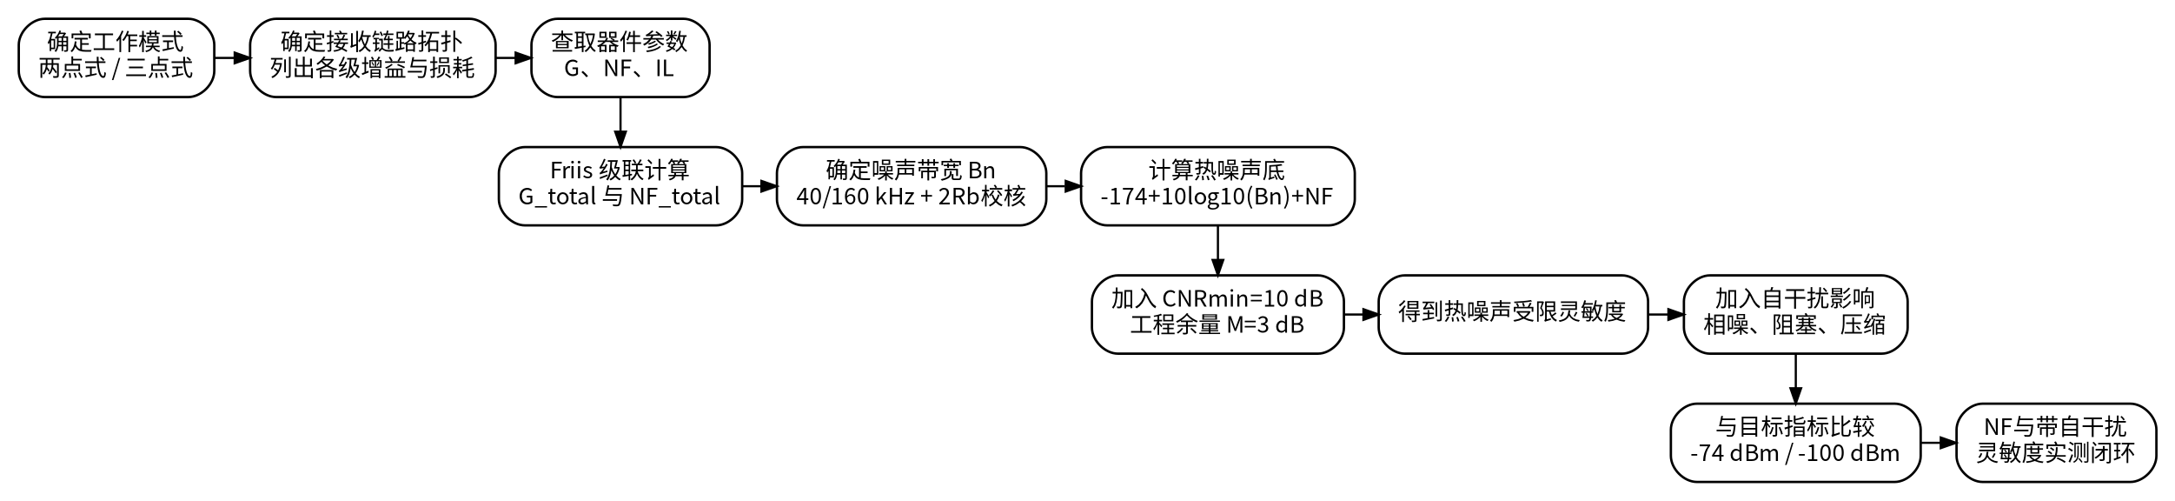
[picture p126: figure]

图 2-1 接收链路灵敏度分析流程图

# 3 器件参数与预算假设

器件参数优先采用论文中已经用于本端机链路预算的数值；对能够从公开资料核实的器件，使用厂家/数据手册典型值。对于同一器件在论文图和正文中存在轻微差异的情况，本报告采用偏保守值。

项目 | 采用参数 | 预算处理 | 依据
DC0900P10 定向耦合器 | 接收耦合路径约 10.0 dB；920 MHz 典型耦合约 9.92 dB | 两点式期望信号走耦合口，因此按 10 dB 接收损耗计入 NF | Yantel 数据手册 + 端机论文
MXD8625C SPDT | 700～960 MHz 典型插损 0.25 dB；隔离典型约 40 dB；P0.1dB 约 36 dBm | 灵敏度计算取 0.4 dB | Maxscend 数据手册
FW1103 LNA | 增益约 23 dB；最低 NF 约 0.35 dB | 计算取 G=21 dB、NF=0.35 dB | 通量科技公开参数；论文约 0.37 dB
SF9078 BPF | 插入损耗约 2.7 dB | 按无源器件 NF=2.7 dB | 邹卓航论文/当前端机链路预算
HGC2005LP4 数控衰减器 | 0 dB 衰减设置仍有固有插损；论文正文预算取 1.4 dB | 本报告取 1.5 dB；图示 1.2 dB，取较保守值 | 邹卓航论文
功分器 | 理想分配损耗约 3 dB | RX 分支按 3 dB；额外损耗由 3 dB 工程余量覆盖 | 端机论文
SLBL18-1R500G-05-31T RX 巴伦 | 插入损耗约 1.4 dB | 作为 FM13 RX 前最后一级无源损耗 | 邹卓航论文
最低载噪比 CNRmin | 10 dB | 与白若明论文 160 kHz 灵敏度计算案例保持一致 | 白若明论文
工程余量 M | 3 dB | 覆盖未建模损耗、器件离散性及芯片内部未知项 | 本报告工程假设

# 4 两点式自发自收模式灵敏度预算

## 4.1 接收链路及强自干扰特点

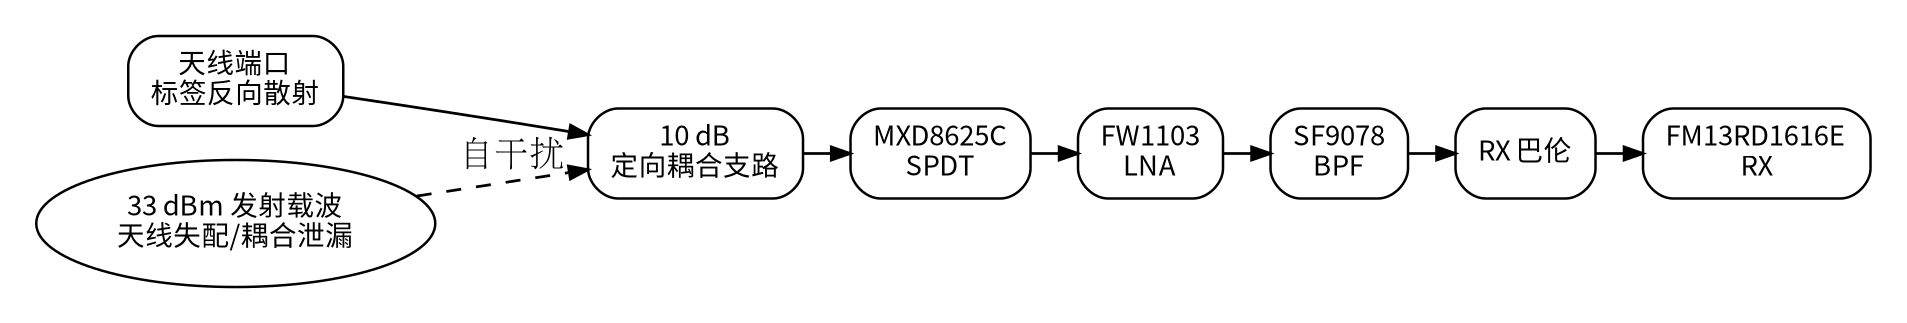
[picture p127: figure]

图 4-1 两点式自发自收模式接收链路

两点式模式中，端机同时以 33 dBm 量级发射并接收标签反向散射。期望信号由天线进入定向耦合器的耦合支路，因此在到达第一级 LNA 之前已经承受约 10 dB 的耦合损耗。与此同时，发射载波通过耦合器有限方向性和天线失配反射进入接收链路。邹卓航论文按天线回波损耗约 15 dB 计算，反射路径形成的自干扰约 7.25 dBm，明显高于微弱标签信号。因此两点式不是单纯的热噪声受限接收机，而是典型的自干扰/阻塞受限接收机。

## 4.2 级联增益与噪声系数

级次 | 增益/损耗 (dB) | NF (dB) | 说明
10 dB 定向耦合支路 | -10.00 | 10.00 | 第一级前大损耗，主导 NF
MXD8625C SPDT | -0.4 | 0.4 | 典型值
FW1103 LNA | +21.00 | 0.35 | 第一级有源低噪声放大
BPF | -3 | 3 | LNA 后损耗贡献被前级增益压低
RX 巴伦 | -1.5 | 1.5 | FM13 RX 前无源损耗
合计/级联结果 | | | Friis 计算

级联结果表明，两点式外部接收前端的总增益约 8.65 dB，总噪声系数约 10.63 dB。尽管 FW1103 本身的 NF 只有约 0.35 dB，但由于其前面存在约 10 dB 的耦合损耗，低 NF LNA 的优势无法恢复已经损失的信噪比。因此，若只从热噪声角度优化两点式灵敏度，继续降低 LNA NF 的收益有限；实际优化重点应放在降低接收耦合损耗和强自干扰影响。

## 4.3 160 kbps 与 40 kbps 灵敏度计算

速率 (kbps) | 带宽口径 | Bn (kHz) | 输入噪声底 (dBm) | CNR=10 dB 灵敏度 | +3 dB余量后 | 相对 -74 dBm 指标余量
160 | 主预算 Bn≈Rb | 160 | -111.33 | -101.33 | -98.33 | 24.33
160 | 保守校核 Bn≈2Rb | 320 | -108.32 | -98.32 | -95.32 | 21.32
40 | 主预算 Bn≈Rb | 40 | -117.35 | -107.35 | -104.35 | 30.35
40 | 保守校核 Bn≈2Rb | 80 | -114.34 | -104.34 | -101.34 | 27.34

按 Bn=160 kHz 的主预算，两点式热噪声受限灵敏度为约 -98.33 dBm；按 40 kHz 预算为约 -104.35 dBm。即使采用更保守的 320 kHz 和 80 kHz 带宽，结果仍分别约为 -95.32 dBm 与 -101.34 dBm，均远优于 -74 dBm 的系统指标。

## 4.4 33 dBm 发射条件下的自干扰预算解释

上述 -98～-104 dBm 是“接收机保持线性且只受热噪声限制”的理论值，并不能直接作为两点式实际灵敏度。若要求在 -74 dBm 有用信号下保留 10 dB 最低 CNR 和 3 dB 工程余量，则接收决策带宽内允许的总等效噪声上限约为 -87 dBm。以 160 kHz 主预算为例，热噪声经前端 NF 后仅约 -111.33 dBm，因此从功率预算上看，系统允许约 -87.02 dBm 的附加自干扰相关噪声/失真；换言之，两点式约有 24 dB 的“自干扰恶化空间”，最终仍能达到 -74 dBm 指标。

需要特别强调：约 7.25 dBm 的自干扰载波本身并不等于 -87 dBm 的噪声。载波会通过同源 LO、滤波和芯片内部解调机制被大幅抑制，真正决定灵敏度的是进入判决带宽的残余相位噪声、互调失真、基带残留以及前端是否发生阻塞/压缩。白若明论文也明确指出，自干扰会通过抬高噪声基底使灵敏度恶化。

从已有样机结果看，邹卓航论文在 33 dBm 发射条件下得到约 -75 dBm 的两点式灵敏度，当前可重构端机报告记录约 -76 dBm。二者均优于本次要求的 -74 dBm，说明该指标在现有架构下具有实测基础。但由于当前端机器件、PCB 和屏蔽结构已有变化，最终仍应重新实测确认。

# 5 三点式收发分离模式灵敏度预算

## 5.1 RX 支路结构与 AGC 工作点

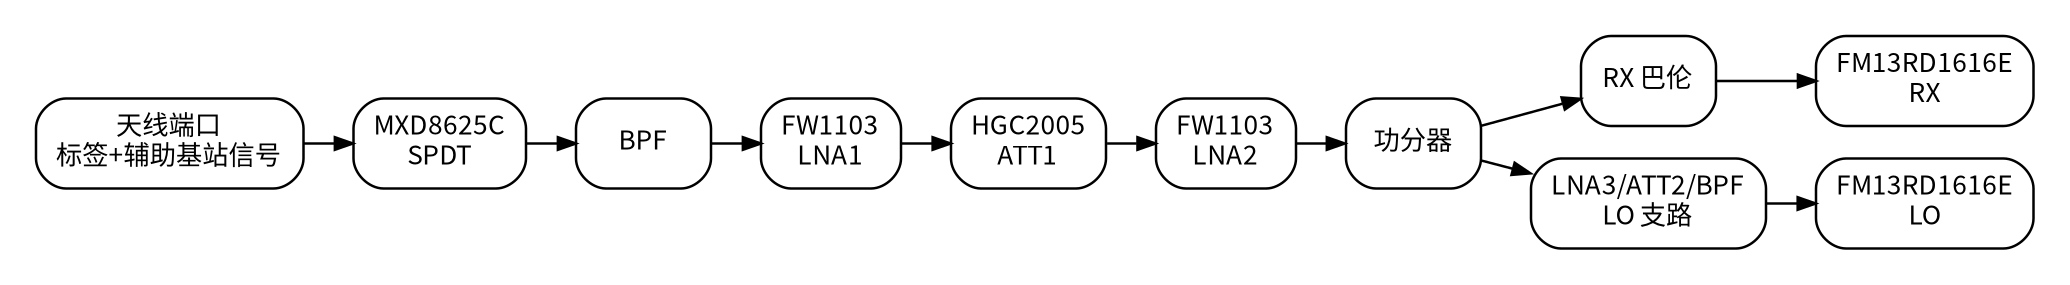
[picture p128: figure]

图 5-1 三点式基站模式 RX/LO 接收链路

三点式基站端不承担同频高功率发射，天线同时接收到标签反向散射与辅助基站载波。输入首先经过 SPDT、BPF、LNA 和第一级数控衰减器，再经第二级 LNA 与功分器分为 RX 与 LO 两支。当前端机测试记录显示，当输入自干扰为 -40 dBm 时，ATT1 设为 0 dB、ATT2 约 11 dB，RX 输出约 -9.9 dBm、LO 约 0.4 dBm。因 ATT1 位于 RX 主链路中，在目标 -40 dBm 工况下保持最小衰减有利于获得最低级联 NF。

用于 LO 支路的第三只 LNA、第二只衰减器和末端 BPF主要决定 LO 功率调节范围，并不直接进入 RX 有用信号的级联 NF，因此本节 RX 灵敏度预算只计算到功分器后的 RX 巴伦和 FM13 RX 端。

## 5.2 RX 支路级联增益与噪声系数

级次 | 增益/损耗 (dB) | NF (dB) | 说明
MXD8625C SPDT | -0.25 | 0.25 | 天线后首级
前置 BPF | -2.70 | 2.70 | 第一级 LNA 前损耗，直接抬高 NF
FW1103 LNA1 | +23.00 | 0.35 | 关键低噪声增益级
HGC2005 ATT1（0 dB码） | -1.40 | 1.40 | 按论文正文的保守固有插损
FW1103 LNA2 | +23.00 | 0.35 | 进一步提高增益
功分器 RX 支路 | -3.00 | 3.00 | 理想分配损耗
RX 巴伦 | -1.40 | 1.40 | FM13 RX 前损耗
合计/级联结果 | 37.25 | 3.31 | Friis 计算

三点式 RX 支路总增益约 37.25 dB，总噪声系数约 3.31 dB。这里最值得注意的是：总 NF 约 3.31 dB 并不是由 LNA 的 0.35 dB NF 决定，而主要由第一级 LNA 之前约 0.25 dB 的开关损耗和 2.7 dB 的 BPF 损耗决定。第一级 LNA 之后的 ATT、第二级 LNA、功分器和巴伦对总 NF 的增量已经被前级 23 dB 增益显著压低。

## 5.3 160 kbps 与 40 kbps 灵敏度计算

速率 (kbps) | 带宽口径 | Bn (kHz) | 输入噪声底 (dBm) | CNR=10 dB 灵敏度 | +3 dB余量后 | 相对 -100 dBm 指标余量
160 | 主预算 Bn≈Rb | 160 | -118.65 | -108.65 | -105.65 | 5.65
160 | 保守校核 Bn≈2Rb | 320 | -115.64 | -105.64 | -102.64 | 2.64
40 | 主预算 Bn≈Rb | 40 | -124.67 | -114.67 | -111.67 | 11.67
40 | 保守校核 Bn≈2Rb | 80 | -121.66 | -111.66 | -108.66 | 8.66

以 Bn=160 kHz 为主预算时，三点式在包含 3 dB 工程余量后可达到约 -105.65 dBm 的热噪声受限灵敏度，相对 -100 dBm 指标保留约 5.65 dB；40 kHz 时约 -111.67 dBm，余量约 11.67 dB。即使采用 Bn=320 kHz 的偏保守校核，理论值仍约 -102.64 dBm，仍比指标好约 2.64 dB。

## 5.4 -40 dBm 自干扰下的剩余噪声预算

在 -100 dBm 有用信号、CNRmin=10 dB 且另保留 3 dB 工程余量的设计口径下，接收带内总噪声目标应低于约 -113 dBm。对 160 kHz 带宽，热噪声+前端 NF 为 -118.65 dBm，因此允许叠加的自干扰相关等效噪声约不高于 -114.38 dBm；对 40 kHz 带宽，相应上限约为 -113.31 dBm。该值是“带内残余噪声/失真”的要求，而不是要求把 -40 dBm 的载波本身衰减到该水平。

三点式中的 -40 dBm 辅助基站载波比 -100 dBm 标签信号高 60 dB，但它同时被用于构造 LO 参考。只要接收链路保持线性、AGC 不在第一级前引入过多衰减，并且相关解调后的残余相位噪声与失真满足上述等效噪声预算，-100 dBm 灵敏度在理论上可实现。邹卓航论文和当前端机测试均在 -40 dBm 自干扰条件下得到 -100 dBm 量级的实测结果，为该预算提供了工程验证。

# 6 两种模式预算对比与结论

模式 | 外部前端增益 | 外部前端 NF | 160 kHz（含3 dB余量） | 40 kHz（含3 dB余量） | 指标 | 判定
两点式，自发自收 | 8.65 | 10.63 | -98.33 dBm | -104.35 dBm | 优于 -74 dBm@33 dBm TX | 热噪声余量很大；强自干扰/阻塞主导
三点式，收发分离 | 37.25 | 3.31 | -105.65 dBm | -111.67 dBm | 优于 -100 dBm@-40 dBm SI | 160 kHz 下约 5.65 dB 理论余量；需控制残余 SI 噪声

综合判断如下：第一，两点式目标 -74 dBm 并不是一个热噪声极限问题。当前 10 dB 耦合接收结构使理论 NF 已达到约 10.63 dB，但即便如此，160 kHz 下的热噪声受限灵敏度仍约 -98.33 dBm。真正把实际灵敏度拉回 -75 dBm 左右的是 33 dBm 发射带来的自干扰相位噪声、残余载波、前端阻塞和非线性。因此，两点式后续测试应优先测“带发射条件的灵敏度”，不能用关掉发射载波后的静态灵敏度替代。

第二，三点式目标 -100 dBm 是一个更典型的低噪声接收问题。其链路在 -40 dBm 自干扰工作点可以把第一级数控衰减器保持在最小衰减，从而获得约 3.31 dB 的外部前端 NF。160 kHz 下理论余量约 5.65 dB，说明指标具有可实现性，但余量并不宽裕；若实际接收滤波带宽接近 320 kHz，则理论余量收窄至约 2.64 dB，因此必须控制 BPF 插损、第一 LNA 前走线/开关损耗以及自干扰残余噪声。

第三，40 kbps 相比 160 kbps 的理论灵敏度改善约 6.02 dB，这是因为热噪声功率与带宽成正比，带宽缩小 4 倍使噪声下降 10log10(4)=6.02 dB。因此，在允许降低数据率的场景中，40 kbps 可以显著增加灵敏度裕量；代价是盘存吞吐率降低。

# 7 设计与测试建议

## 7.1 两点式模式

两点式应把“自干扰下的线性工作能力”放在比 LNA 噪声系数更高的优先级。建议在 33 dBm 天线口发射条件下分别测量：天线反射回来的接收端自干扰功率、LNA 输入/输出是否压缩、FM13 RX 前噪声底、不同天线回波损耗下的灵敏度变化。若自干扰过强，优先改善天线 S11、耦合器方向性、屏蔽腔隔离与自干扰抵消，而不是简单增加接收增益。

## 7.2 三点式模式

三点式应尽量避免在第一只 LNA 之前增加可调衰减。当前 -40 dBm 工况下 ATT1=0 dB 的控制策略是合理的。若后续需要进一步提高 160 kbps 灵敏度，最有效的硬件方向是降低前置 BPF 插损、缩短天线到第一 LNA 的走线、选择更低插损开关，并确保第一级 LNA 供电和匹配稳定。按照 Friis 公式，第一 LNA 之后再优化功分器或巴伦的损耗，对总 NF 的改善相对有限。

## 7.3 推荐的灵敏度测试闭环

建议实际测试同时输出“静态 NF”和“带自干扰灵敏度”两个结果。静态 NF 可参考白若明论文的方法：注入与 LO 略有频偏的点频信号，测量链路增益 G；关闭信号源后在相同 IF 频点测量输出噪声功率谱密度，再折算输入 NF。带自干扰灵敏度则保持两点式 33 dBm 发射或三点式 -40 dBm 自干扰条件，逐步降低标签模拟信号功率，以规定盘存成功率作为判决门限。这样可以把“热噪声能力”和“自干扰惩罚”分开量化。

# 附录 A Mermaid 流程图源码

以下源码用于后续在 Markdown/Typora/Obsidian 等环境中复用本报告的分析流程图。

```mermaid
flowchart TD
A[确定工作模式：两点式/三点式] --> B[列出接收链路各级器件]
B --> C[查取增益、插损、噪声系数]
C --> D[用Friis公式计算G_total与NF_total]
D --> E[确定等效噪声带宽：40/160 kHz，并做2Rb校核]
E --> F[计算热噪声底 -174+10log10(Bn)+NF]
F --> G[加入CNRmin=10 dB和工程余量3 dB]
G --> H[得到热噪声受限灵敏度]
H --> I[叠加自干扰相位噪声、阻塞与非线性影响]
I --> J[对比两点式-74 dBm与三点式-100 dBm指标]
J --> K[通过NF与带自干扰灵敏度实测闭环验证]
```

# 参考资料

[1] 白若明. 国产化超高频 RFID 读写器射频前端电路技术研究与设计[D]. 电子科技大学, 2024.

[2] 邹卓航. 多功能超高频物联网接入端机及标签设计与实现[D]. 电子科技大学, 2026.

[3] 可重构超高频蜂窝物联网端机设计报告, 2026-09-12/13 版本（用户提供）.

[4] 成都通量科技. FW1103 0.4～2.0 GHz 高线性高增益低噪声放大器公开产品参数：增益 23 dB，最低 NF 0.35 dB.

[5] Maxscend. MXD8625C SPDT datasheet：700～960 MHz 典型插损 0.25 dB，典型隔离约 40 dB，P0.1dB 约 36 dBm.

[6] Yantel. DC0900P10 Directional Coupler datasheet：800～1000 MHz，约 10 dB 耦合；920 MHz 典型耦合约 -9.92 dB.

[7] 上海复旦微电子集团. FM13RD1616E 超高频读写器芯片产品页：支持 EPC Global C1G2 / ISO18000-6C.

公开器件资料网址（检索日期 2026-09-18）：

https://www.fluxworks.cn/products_detail.aspx?cid=17&t=12

https://manuals.plus/m/73457f334385dfa9ccd67eee915d64a5fed228e783c13fbc6fcac24266f99ae7

https://datasheet4u.com/pdf/908258/DC0900P10.pdf

https://www.fmsh.com/cgpdxqxp/

说明：本报告中的噪声系数为依据当前公开/论文参数得到的理论预算值，不替代样机噪声系数实测。尤其是 FM13RD1616E 芯片内部接收机的完整 NF、相位噪声抵消细节和实际基带等效噪声带宽未在公开资料中完整给出，因此采用 3 dB 工程余量进行覆盖。正式验收应以实测 NF、带自干扰灵敏度和盘存成功率为准。
