lyy622516-web/basestation/02_硬件架构与拓扑图/L1_Top_Layer_Routing.png

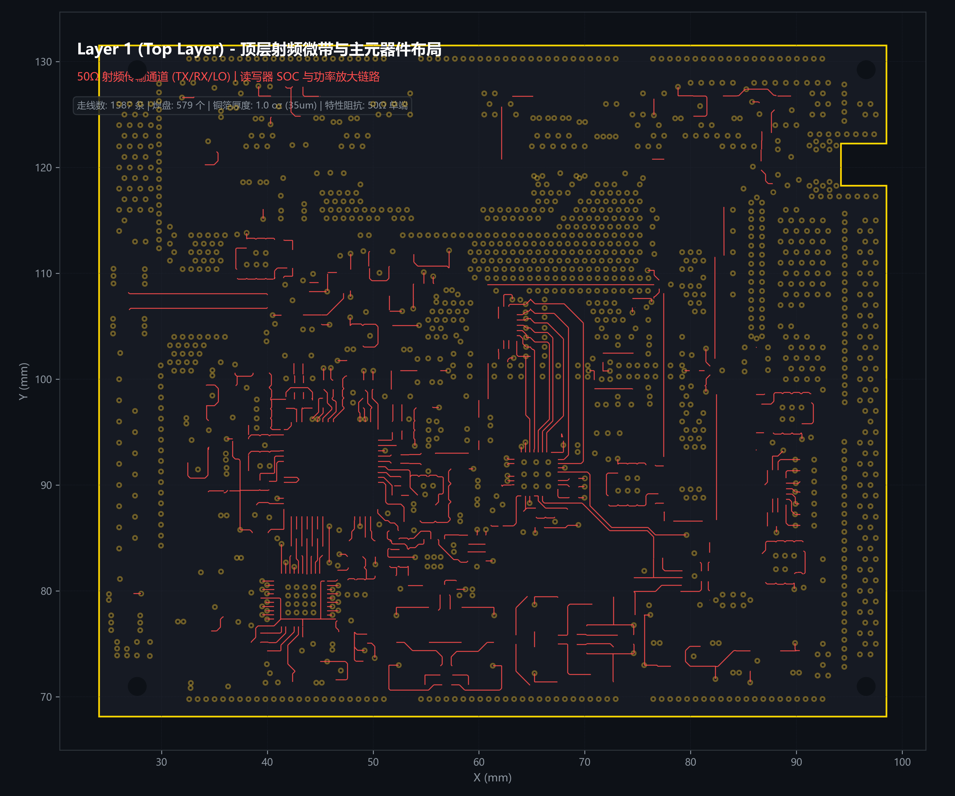
02_硬件架构与拓扑图/L1_Top_Layer_Routing.png
