lyy622516-web/basestation/02_硬件架构与拓扑图/L2_GND_Plane_Routing.png

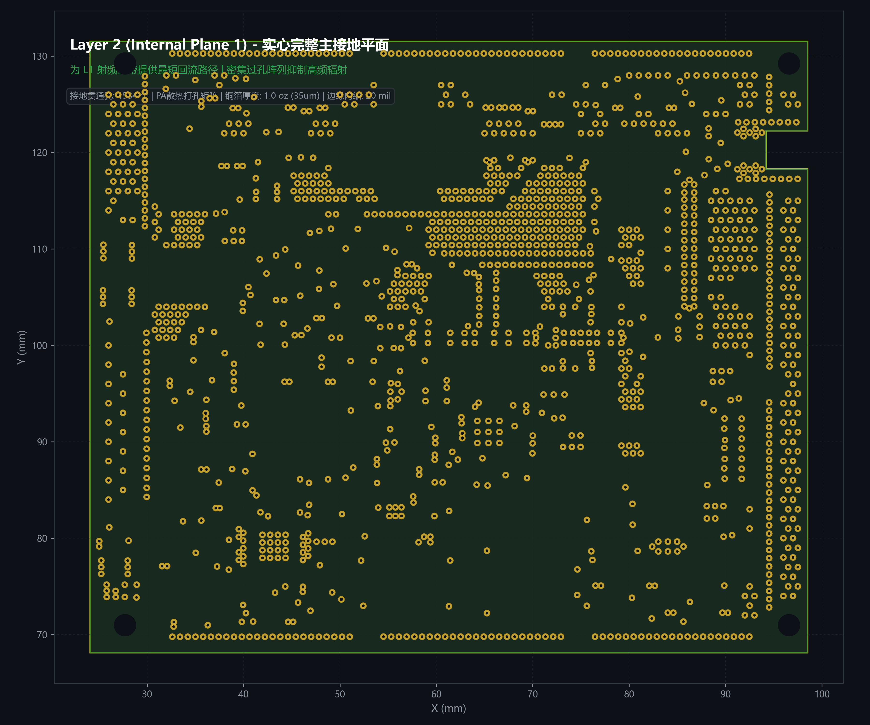
02_硬件架构与拓扑图/L2_GND_Plane_Routing.png
