lyy622516-web/basestation/02_硬件架构与拓扑图/L3_Signal1_Power_Routing.png

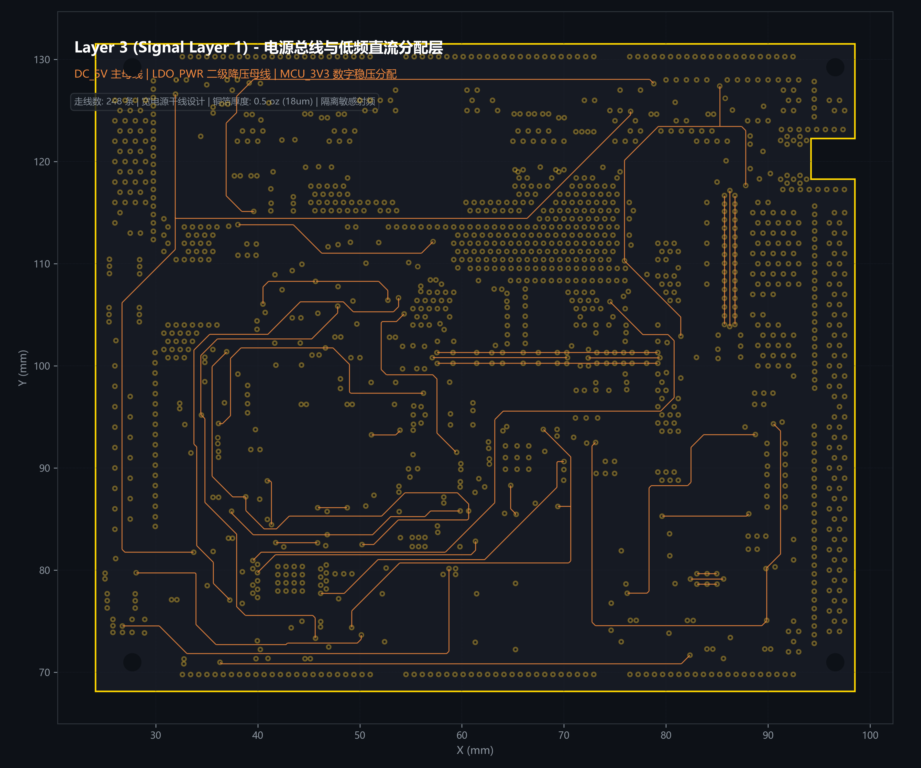
02_硬件架构与拓扑图/L3_Signal1_Power_Routing.png
