lyy622516-web/basestation/02_硬件架构与拓扑图/L4_Signal2_Digital_Routing.png

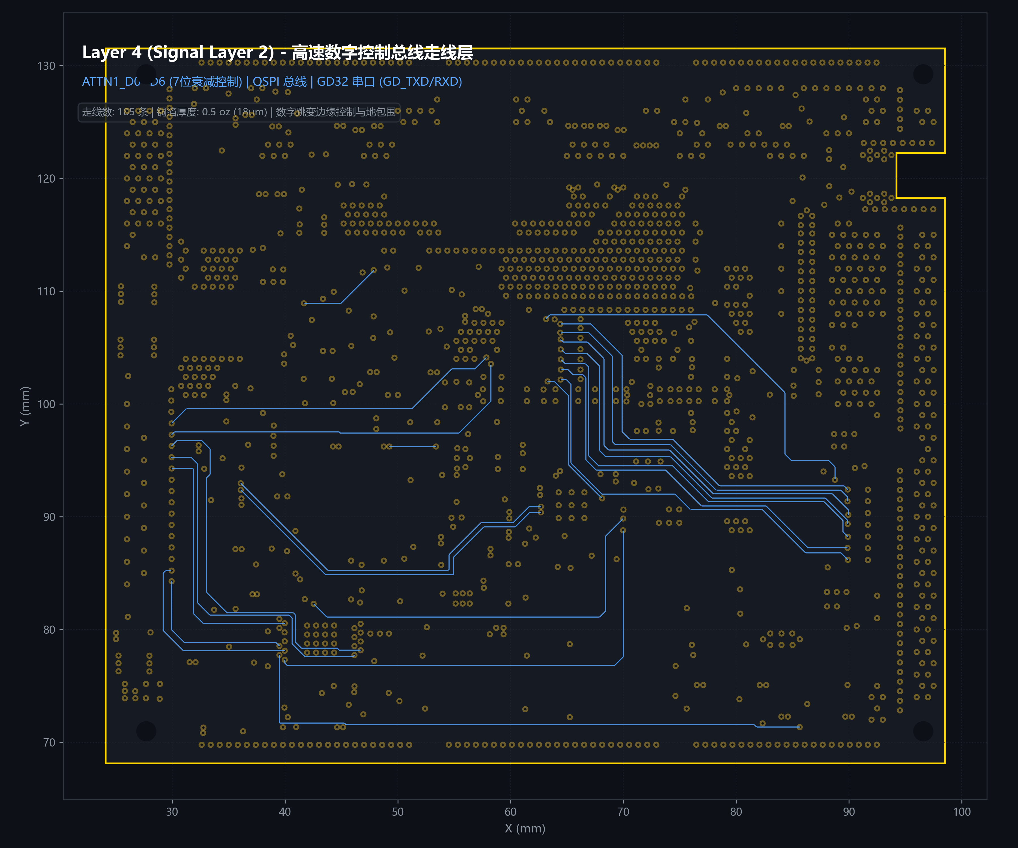
02_硬件架构与拓扑图/L4_Signal2_Digital_Routing.png
