lyy622516-web/basestation/02_硬件架构与拓扑图/L5_Signal3_Analog_Routing.png

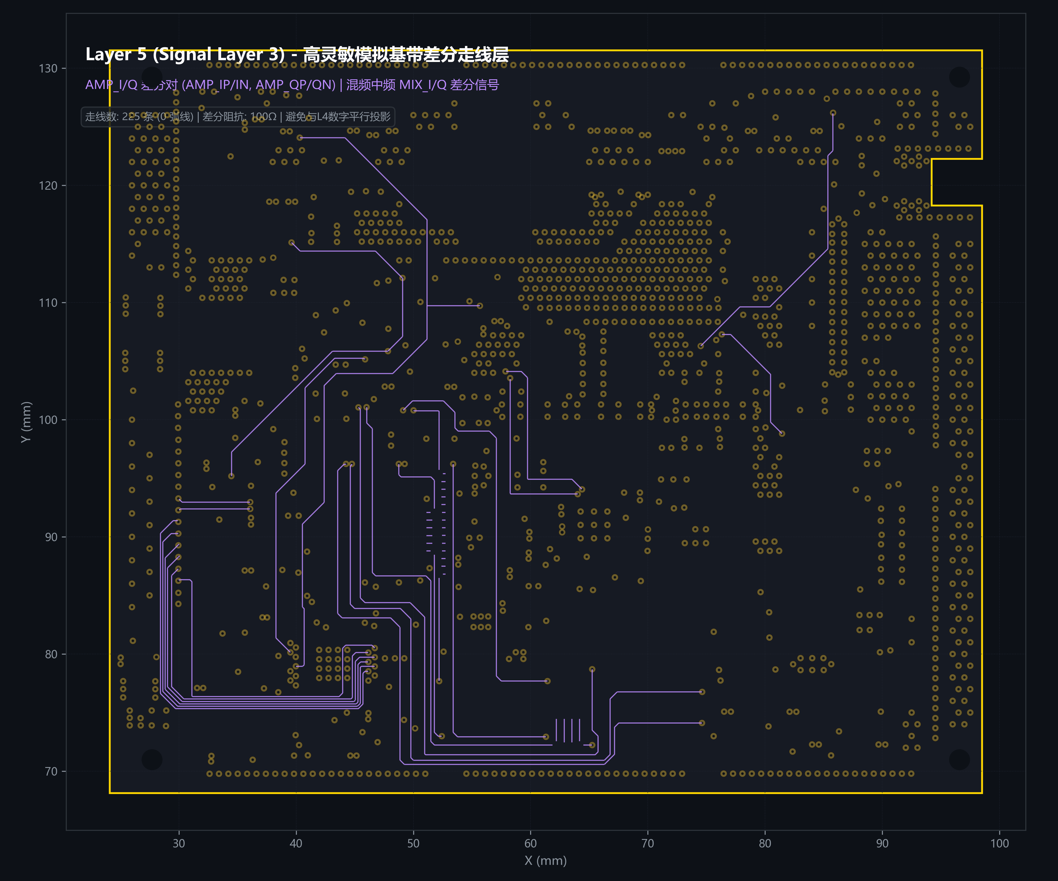
02_硬件架构与拓扑图/L5_Signal3_Analog_Routing.png
