lyy622516-web/basestation/02_硬件架构与拓扑图/PCB_All_Layers_Composite.png

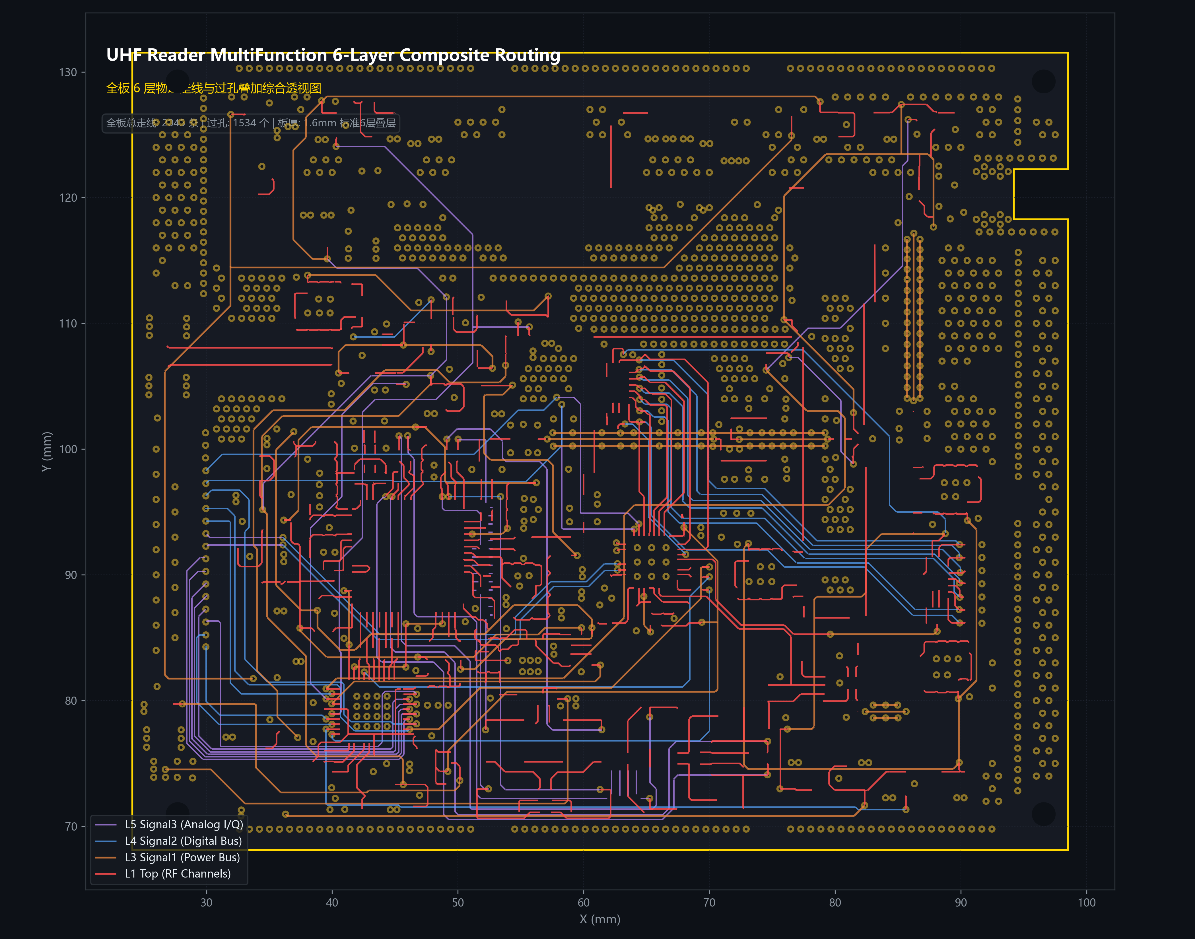
02_硬件架构与拓扑图/PCB_All_Layers_Composite.png
