lyy622516-web/basestation/03_BOM_物料清单/UHF_Reader_MultiFunction_V5_LCSC_BOM.csv

Designator | Value | Package | LCSC_Part_No | Manufacturer | MPN | Description | Layer | X_mm | Y_mm | Rotation | Module
RF6 | BWIPX-1-001E | IPEX-SMD_BWIPX-1-001E | C2934254 | 星坤(XKB) | BWIPX-1-001E | 一代 IPEX/U.FL 贴片射频插座 2x2mm | TOP | 74.6 | 97.6 | 270.0 | U_RF_circuit
RF5 | BWIPX-1-001E | IPEX-SMD_BWIPX-1-001E | C2934254 | 星坤(XKB) | BWIPX-1-001E | 一代 IPEX/U.FL 贴片射频插座 2x2mm | TOP | 74.6 | 103.95 | 90.0 | U_RF_circuit
R49 | 0 | 0402_Z | C17168 | 厚声(UniOhm)/风华高科 | 0402WGF0000TCE | 0402 0Ω ±1% 贴片电阻 | TOP | 71.325 | 100.775 | 180.0 | U_RF_circuit
R48 | 0 | 0402_Z | C17168 | 厚声(UniOhm)/风华高科 | 0402WGF0000TCE | 0402 0Ω ±1% 贴片电阻 | TOP | 70.9 | 99.5 | 90.0 | U_RF_circuit
R46 | 0 | 0402_Z | C17168 | 厚声(UniOhm)/风华高科 | 0402WGF0000TCE | 0402 0Ω ±1% 贴片电阻 | TOP | 71.725 | 102.05 | 270.0 | U_RF_circuit
U36 | SGM2036-2.8V | SOT-23-5 | C312520 | 圣邦微(SGMICRO) | SGM2036-2.8YN5G/TR | 300mA 超低噪声高PSRR LDO SOT-23-5 | TOP | 50.6 | 109.275 | 270.0 | U_Power_Sch
C215 | 1uF | 0603_Z | C15849 | 国巨(Yageo)/风华高科 | CC0603KRX7R9BB105 | 0603 1uF ±10% 50V X7R | TOP | 50.8 | 106.4 | 0.0 | U_Power_Sch
C214 | 1uF | 0603_Z | C15849 | 国巨(Yageo)/风华高科 | CC0603KRX7R9BB105 | 0603 1uF ±10% 50V X7R | TOP | 50.425 | 112.1 | 180.0 | U_Power_Sch
U7 | ADG918 | ADG918 | C128537 | ADI/国产宽带替代 | ADG918BRM | 宽带DC-4GHz 50Ω SPDT射频开关 MSOP-8 | TOP | 55.782 | 82.726 | 180.0 | U_FMRD1616E
C83 | 1uF | 0402_Z | C52923 | 国巨(Yageo)/风华高科 | CC0402KRX5R6BB105 | 0402 1uF ±10% 10V X5R | TOP | 51.532 | 86.076 | 90.0 | U_FMRD1616E
R15 | 50 | 0402_Z | C25118 | 厚声(UniOhm)/风华高科 | 0402WGF499JTCE | 0402 49.9Ω ±1% 贴片电阻 | TOP | 53.332 | 82.776 | 270.0 | U_FMRD1616E
R20 | 100 | 0402_Z | C25078 | 厚声(UniOhm)/风华高科 | 0402WGF1000TCE | 0402 100Ω ±1% 贴片电阻 | TOP | 51.545 | 84.426 | 270.0 | U_FMRD1616E
R19 | 100 | 0402_Z | C25078 | 厚声(UniOhm)/风华高科 | 0402WGF1000TCE | 0402 100Ω ±1% 贴片电阻 | TOP | 58.899 | 85.344 | 270.0 | U_FMRD1616E
R16 | 0 | 0402_Z | C17168 | 厚声(UniOhm)/风华高科 | 0402WGF0000TCE | 0402 0Ω ±1% 贴片电阻 | TOP | 60.545 | 85.326 | 90.0 | U_FMRD1616E
C85 | 100pF | 0402_Z | C1546 | 国巨(Yageo)/风华高科 | CC0402JRNPO9BN101 | 0402 100pF ±5% 50V C0G | TOP | 52.932 | 83.901 | 180.0 | U_FMRD1616E
C84 | 1uF | 0402_Z | C52923 | 国巨(Yageo)/风华高科 | CC0402KRX5R6BB105 | 0402 1uF ±10% 10V X5R | TOP | 53.307 | 80.926 | 270.0 | U_FMRD1616E
C82 | 1uF | 0402_Z | C52923 | 国巨(Yageo)/风华高科 | CC0402KRX5R6BB105 | 0402 1uF ±10% 10V X5R | TOP | 52.407 | 85.301 | 90.0 | U_FMRD1616E
C81 | 100pF | 0402_Z | C1546 | 国巨(Yageo)/风华高科 | CC0402JRNPO9BN101 | 0402 100pF ±5% 50V C0G | TOP | 58.057 | 83.758 | 90.0 | U_FMRD1616E
C80 | 100pF | 0402_Z | C1546 | 国巨(Yageo)/风华高科 | CC0402JRNPO9BN101 | 0402 100pF ±5% 50V C0G | TOP | 53.332 | 85.319 | 270.0 | U_FMRD1616E
U12 | AiP74LVC1G14GC.TR | SOT-353 L2.1-W1.3-P0.65 | C386629 | 无锡中微爱芯(I-CORE) | AiP74LVC1G14GC.TR | 单路反相施密特触发器 SOT-353 | TOP | 45.757 | 111.726 | 0.0 | U_RF_circuit
U11 | MXD8625C | MXD8625C | C2838505 | 卓胜微(Maxscend) | MXD8625C | 高隔离度大功率 SPDT 射频开关 DFN-6 | TOP | 42.564 | 108.378 | 270.0 | U_RF_circuit
U10 | MXD8625C | MXD8625C | C2838505 | 卓胜微(Maxscend) | MXD8625C | 高隔离度大功率 SPDT 射频开关 DFN-6 | TOP | 42.223 | 106.474 | 90.0 | U_RF_circuit
C122 | 100 pF | 0402_Z | C1546 | 国巨(Yageo)/风华高科 | CC0402JRNPO9BN101 | 0402 100pF ±5% 50V C0G | TOP | 45.282 | 109.951 | 180.0 | U_RF_circuit
C119 | 100 pF | 0402_Z | C1546 | 国巨(Yageo)/风华高科 | CC0402JRNPO9BN101 | 0402 100pF ±5% 50V C0G | TOP | 41.357 | 105.644 | 270.0 | U_RF_circuit
C118 | 100 pF | 0402_Z | C1546 | 国巨(Yageo)/风华高科 | CC0402JRNPO9BN101 | 0402 100pF ±5% 50V C0G | TOP | 45.307 | 113.301 | 0.0 | U_RF_circuit
C103 | 100 pF | 0402_Z | C1546 | 国巨(Yageo)/风华高科 | CC0402JRNPO9BN101 | 0402 100pF ±5% 50V C0G | TOP | 43.932 | 108.701 | 90.0 | U_RF_circuit
C102 | 100 pF | 0402_Z | C1546 | 国巨(Yageo)/风华高科 | CC0402JRNPO9BN101 | 0402 100pF ±5% 50V C0G | TOP | 43.382 | 105.644 | 270.0 | U_RF_circuit
U6 | 48MHzÎÂ²¹¾§Õñ | 48MHÎÂ²¹¾§Õñ | C99999 | 国产优质供应 | 48MHzÎÂ²¹¾§Õñ | 48MHÎÂ²¹¾§Õñ 48MHzÎÂ²¹¾§Õñ | TOP | 51.157 | 80.951 | 0.0 | U_FMRD1616E
RF2 | BWIPX-1-001E | IPEX-SMD_BWIPX-1-001E | C2934254 | 星坤(XKB) | BWIPX-1-001E | 一代 IPEX/U.FL 贴片射频插座 2x2mm | TOP | 26.942 | 105.051 | 270.0 | U_RF_circuit
RF3 | BWIPX-1-001E | IPEX-SMD_BWIPX-1-001E | C2934254 | 星坤(XKB) | BWIPX-1-001E | 一代 IPEX/U.FL 贴片射频插座 2x2mm | TOP | 26.932 | 109.751 | 90.0 | U_RF_circuit
RF1 | BWIPX-1-001E | IPEX-SMD_BWIPX-1-001E | C2934254 | 星坤(XKB) | BWIPX-1-001E | 一代 IPEX/U.FL 贴片射频插座 2x2mm | TOP | 26.732 | 77.026 | 90.0 | U_FMRD1616E
R24 | 1k | 0402_Z | C25087 | 厚声(UniOhm)/风华高科 | 0402WGF1001TCE | 0402 1kΩ ±1% 贴片电阻 | TOP | 45.107 | 105.644 | 270.0 | U_RF_circuit
R23 | 2k | 0402_Z | C25890 | 厚声(UniOhm)/风华高科 | 0402WGF2201TCE | 0402 2.2kΩ ±1% 贴片电阻 | TOP | 44.245 | 105.644 | 270.0 | U_RF_circuit
R22 | 1k | 0402_Z | C25087 | 厚声(UniOhm)/风华高科 | 0402WGF1001TCE | 0402 1kΩ ±1% 贴片电阻 | TOP | 60.557 | 83.776 | 270.0 | U_FMRD1616E
R21 | 2k | 0402_Z | C25890 | 厚声(UniOhm)/风华高科 | 0402WGF2201TCE | 0402 2.2kΩ ±1% 贴片电阻 | TOP | 59.728 | 83.776 | 270.0 | U_FMRD1616E
R14 | 10K | 0402_Z | C25744 | 厚声(UniOhm)/风华高科 | 0402WGF1002TCE | 0402 10kΩ ±1% 贴片电阻 | TOP | 52.42 | 82.776 | 270.0 | U_FMRD1616E
R18 | 100 | 0402_Z | C25078 | 厚声(UniOhm)/风华高科 | 0402WGF1000TCE | 0402 100Ω ±1% 贴片电阻 | TOP | 58.887 | 83.758 | 90.0 | U_FMRD1616E
R17 | 0 | 0402_Z | C17168 | 厚声(UniOhm)/风华高科 | 0402WGF0000TCE | 0402 0Ω ±1% 贴片电阻 | TOP | 59.716 | 85.326 | 90.0 | U_FMRD1616E
L34 | BEAD | 0603_Z | C1005 | 顺络(Sunlord)/麦捷科技 | SDCL1005CBEADSTF | 0402 BEAD 高频叠层贴片电感 | TOP | 48.996 | 83.99 | 90.0 | U_FMRD1616E
C121 | NC | 0402_Z | C1525 | 国巨(Yageo)/风华高科 | CC0402KRX7RNC | 0402 NC ±10% X7R | TOP | 40.432 | 107.951 | 180.0 | U_RF_circuit
C120 | NC | 0402_Z | C1525 | 国巨(Yageo)/风华高科 | CC0402KRX7RNC | 0402 NC ±10% X7R | TOP | 40.432 | 106.801 | 180.0 | U_RF_circuit
C86 | 100 pF | 0402_Z | C1546 | 国巨(Yageo)/风华高科 | CC0402JRNPO9BN101 | 0402 100pF ±5% 50V C0G | TOP | 44.832 | 108.701 | 90.0 | U_RF_circuit
C116 | 100 pF | 0402_Z | C1546 | 国巨(Yageo)/风华高科 | CC0402JRNPO9BN101 | 0402 100pF ±5% 50V C0G | TOP | 42.382 | 105.626 | 90.0 | U_RF_circuit
C74 | 10pF | 0402_Z | C1551 | 国巨(Yageo)/风华高科 | CC0402JRNPO9BN100 | 0402 10pF ±5% 50V C0G | TOP | 51.545 | 82.776 | 270.0 | U_FMRD1616E
C79 | 1uF | 0402_Z | C52923 | 国巨(Yageo)/风华高科 | CC0402KRX5R6BB105 | 0402 1uF ±10% 10V X5R | TOP | 57.882 | 80.576 | 270.0 | U_FMRD1616E
C78 | 100pF | 0402_Z | C1546 | 国巨(Yageo)/风华高科 | CC0402JRNPO9BN101 | 0402 100pF ±5% 50V C0G | TOP | 58.057 | 85.344 | 270.0 | U_FMRD1616E
C69 | 1uF | 0603_Z | C15849 | 国巨(Yageo)/风华高科 | CC0603KRX7R9BB105 | 0603 1uF ±10% 50V X7R | TOP | 48.382 | 82.226 | 180.0 | U_FMRD1616E
C68 | 100nF | 0402_Z | C1525 | 国巨(Yageo)/风华高科 | CC0402KRX7R7BB104 | 0402 100nF ±10% 16V X7R | TOP | 48.412 | 80.901 | 270.0 | U_FMRD1616E
C67 | 1nF | 0402_Z | C1532 | 国巨(Yageo)/风华高科 | CC0402KRX7R9BB102 | 0402 1nF ±10% 50V X7R | TOP | 47.586 | 80.901 | 270.0 | U_FMRD1616E
C66 | 100 pF | 0402_Z | C1546 | 国巨(Yageo)/风华高科 | CC0402JRNPO9BN101 | 0402 100pF ±5% 50V C0G | TOP | 49.237 | 80.901 | 270.0 | U_FMRD1616E
U27 | SGM2036-5V | SOT-23-5 | C312522 | 圣邦微(SGMICRO) | SGM2036-5.0YN5G/TR | 300mA 超低噪声高PSRR LDO SOT-23-5 | TOP | 54.799 | 110.415 | 90.0 | U_Power_Sch
C197 | 1uF | 0603_Z | C15849 | 国巨(Yageo)/风华高科 | CC0603KRX7R9BB105 | 0603 1uF ±10% 50V X7R | TOP | 57.182 | 109.767 | 90.0 | U_Power_Sch
C196 | 1uF | 0603_Z | C15849 | 国巨(Yageo)/风华高科 | CC0603KRX7R9BB105 | 0603 1uF ±10% 50V X7R | TOP | 54.574 | 107.577 | 180.0 | U_Power_Sch
u8 | FW1103 | FW1103W | C2901240 | 国产射频 | FW1103 | 多功能射频数字衰减/移相器 QFN-16 | TOP | 42.642 | 111.356 | 0.0 | U_RF_circuit
R30 | 292R | 0402_Z | C25076 | 厚声(UniOhm)/风华高科 | 0402WGF292RTCE | 0402 292R ±1% 贴片电阻 | TOP | 40.882 | 103.551 | 180.0 | U_RF_circuit
R31 | 292R | 0402_Z | C25076 | 厚声(UniOhm)/风华高科 | 0402WGF292RTCE | 0402 292R ±1% 贴片电阻 | TOP | 40.875 | 104.425 | 180.0 | U_RF_circuit
R29 | 17R | 0402_Z | C25076 | 厚声(UniOhm)/风华高科 | 0402WGF17RTCE | 0402 17R ±1% 贴片电阻 | TOP | 42.357 | 104.026 | 270.0 | U_RF_circuit
R26 | 50 | 0402_Z | C25118 | 厚声(UniOhm)/风华高科 | 0402WGF499JTCE | 0402 49.9Ω ±1% 贴片电阻 | TOP | 37.143 | 109.953 | 90.0 | U_RF_circuit
R25 | 6.5k | 0402_Z | C25076 | 厚声(UniOhm)/风华高科 | 0402WGF6.5kTCE | 0402 6.5k ±1% 贴片电阻 | TOP | 38.057 | 112.822 | 270.0 | U_RF_circuit
P3 | SF9078 | SF8009 | C99999 | 国产优质供应 | SF9078 | SF8009 SF9078 | TOP | 42.378 | 116.248 | 0.0 | U_RF_circuit
L37 | 47nH | 0402_Z | C1005 | 顺络(Sunlord)/麦捷科技 | SDCL1005C47nHSTF | 0402 47nH 高频叠层贴片电感 | TOP | 41.107 | 113.176 | 0.0 | U_RF_circuit
L36 | 18nH | 0402_Z | C1005 | 顺络(Sunlord)/麦捷科技 | SDCL1005C18nHSTF | 0402 18nH 高频叠层贴片电感 | TOP | 41.132 | 109.626 | 0.0 | U_RF_circuit
C105 | 100 pF | 0402_Z | C1546 | 国巨(Yageo)/风华高科 | CC0402JRNPO9BN101 | 0402 100pF ±5% 50V C0G | TOP | 42.384 | 113.521 | 90.0 | U_RF_circuit
C104 | 100 pF | 0402_Z | C1546 | 国巨(Yageo)/风华高科 | CC0402JRNPO9BN101 | 0402 100pF ±5% 50V C0G | TOP | 42.407 | 109.301 | 90.0 | U_RF_circuit
C93 | 100 pF | 0402_Z | C1546 | 国巨(Yageo)/风华高科 | CC0402JRNPO9BN101 | 0402 100pF ±5% 50V C0G | TOP | 39.862 | 109.953 | 90.0 | U_RF_circuit
C91 | 100 pF | 0402_Z | C1546 | 国巨(Yageo)/风华高科 | CC0402JRNPO9BN101 | 0402 100pF ±5% 50V C0G | TOP | 38.96 | 112.822 | 270.0 | U_RF_circuit
C90 | 1nF | 0402_Z | C1532 | 国巨(Yageo)/风华高科 | CC0402KRX7R9BB102 | 0402 1nF ±10% 50V X7R | TOP | 38.96 | 109.953 | 90.0 | U_RF_circuit
C89 | 100nF | 0402_Z | C1525 | 国巨(Yageo)/风华高科 | CC0402KRX7R7BB104 | 0402 100nF ±10% 16V X7R | TOP | 39.862 | 112.822 | 270.0 | U_RF_circuit
C88 | 100nF | 0402_Z | C1525 | 国巨(Yageo)/风华高科 | CC0402KRX7R7BB104 | 0402 100nF ±10% 16V X7R | TOP | 38.057 | 109.953 | 90.0 | U_RF_circuit
C87 | 100 pF | 0402_Z | C1546 | 国巨(Yageo)/风华高科 | CC0402JRNPO9BN101 | 0402 100pF ±5% 50V C0G | TOP | 37.155 | 112.822 | 270.0 | U_RF_circuit
U14 | AiP74LVC1G14GC.TR | SOT-353_L2.1-W1.3-P0.65 | C386629 | 无锡中微爱芯(I-CORE) | AiP74LVC1G14GC.TR | 单路反相施密特触发器 SOT-353 | TOP | 87.154 | 126.827 | 90.0 | U_RF_circuit
R34 | 1k | 0402_Z | C25087 | 厚声(UniOhm)/风华高科 | 0402WGF1001TCE | 0402 1kΩ ±1% 贴片电阻 | TOP | 87.115 | 123.503 | 0.0 | U_RF_circuit
R32 | 2k | 0402_Z | C25890 | 厚声(UniOhm)/风华高科 | 0402WGF2201TCE | 0402 2.2kΩ ±1% 贴片电阻 | TOP | 87.116 | 122.603 | 0.0 | U_RF_circuit
C131 | 100pF | 0402_Z | C1546 | 国巨(Yageo)/风华高科 | CC0402JRNPO9BN101 | 0402 100pF ±5% 50V C0G | TOP | 89.209 | 126.998 | 90.0 | U_RF_circuit
R52 | 10k | 0402_Z | C25744 | 厚声(UniOhm)/风华高科 | 0402WGF1002TCE | 0402 10kΩ ±1% 贴片电阻 | TOP | 49.431 | 75.495 | 270.0 | U_Power_Sch
D1 | LED0 | 0603_Z | C99999 | 国产优质供应 | LED0 | 0603_Z LED0 | TOP | 26.407 | 79.426 | 0.0 | U_Power_Sch
R55 | 33R | 0402_Z | C25076 | 厚声(UniOhm)/风华高科 | 0402WGF33RTCE | 0402 33R ±1% 贴片电阻 | TOP | 68.979 | 90.73 | 180.0 | U_MCU_SLAVE
C126 | 100pF | 0402_Z | C1546 | 国巨(Yageo)/风华高科 | CC0402JRNPO9BN101 | 0402 100pF ±5% 50V C0G | TOP | 90.226 | 119.714 | 90.0 | U_RF_circuit
C125 | 100pF | 0402_Z | C1546 | 国巨(Yageo)/风华高科 | CC0402JRNPO9BN101 | 0402 100pF ±5% 50V C0G | TOP | 87.706 | 119.72 | 90.0 | U_RF_circuit
L23 | 390uH | 1210_Z | C1005 | 顺络(Sunlord)/麦捷科技 | SDCL1005C390uHSTF | 0402 390uH 高频叠层贴片电感 | TOP | 60.496 | 72.919 | 0.0 | U_FMRD1616E
L22 | 270uH | 1210_Z | C1005 | 顺络(Sunlord)/麦捷科技 | SDCL1005C270uHSTF | 0402 270uH 高频叠层贴片电感 | TOP | 61.428 | 76.788 | 270.0 | U_FMRD1616E
L20 | NC | 1210_Z | C1005 | 顺络(Sunlord)/麦捷科技 | SDCL1005CNCSTF | 0402 NC 高频叠层贴片电感 | TOP | 58.351 | 76.788 | 90.0 | U_FMRD1616E
L19 | NC | 1210_Z | C1005 | 顺络(Sunlord)/麦捷科技 | SDCL1005CNCSTF | 0402 NC 高频叠层贴片电感 | TOP | 55.275 | 76.788 | 270.0 | U_FMRD1616E
L18 | 390uH | 1210_Z | C1005 | 顺络(Sunlord)/麦捷科技 | SDCL1005C390uHSTF | 0402 390uH 高频叠层贴片电感 | TOP | 53.148 | 72.978 | 180.0 | U_FMRD1616E
L17 | 270uH | 1210_Z | C1005 | 顺络(Sunlord)/麦捷科技 | SDCL1005C270uHSTF | 0402 270uH 高频叠层贴片电感 | TOP | 52.198 | 76.788 | 270.0 | U_FMRD1616E
L15 | 390uH | 1210_Z | C1005 | 顺络(Sunlord)/麦捷科技 | SDCL1005C390uHSTF | 0402 390uH 高频叠层贴片电感 | TOP | 72.726 | 77.804 | 90.0 | U_FMRD1616E
L14 | 270uH | 1210_Z | C1005 | 顺络(Sunlord)/麦捷科技 | SDCL1005C270uHSTF | 0402 270uH 高频叠层贴片电感 | TOP | 69.062 | 78.754 | 0.0 | U_FMRD1616E
L12 | NC | 1210_Z | C1005 | 顺络(Sunlord)/麦捷科技 | SDCL1005CNCSTF | 0402 NC 高频叠层贴片电感 | TOP | 65.252 | 77.804 | 90.0 | U_FMRD1616E
L9 | NC | 1210_Z | C1005 | 顺络(Sunlord)/麦捷科技 | SDCL1005CNCSTF | 0402 NC 高频叠层贴片电感 | TOP | 65.252 | 73.039 | 90.0 | U_FMRD1616E
L8 | 390uH | 1210_Z | C1005 | 顺络(Sunlord)/麦捷科技 | SDCL1005C390uHSTF | 0402 390uH 高频叠层贴片电感 | TOP | 72.726 | 73.039 | 270.0 | U_FMRD1616E
L7 | 270uH | 1210_Z | C1005 | 顺络(Sunlord)/麦捷科技 | SDCL1005C270uHSTF | 0402 270uH 高频叠层贴片电感 | TOP | 68.935 | 72.089 | 0.0 | U_FMRD1616E
C48 | 0R | 0402_Z | C1525 | 国巨(Yageo)/风华高科 | CC0402_0R | 0402 0R 贴片电容 | TOP | 57.47 | 72.47 | 90.0 | U_FMRD1616E
C47 | 100nF | 0402_Z | C1525 | 国巨(Yageo)/风华高科 | CC0402KRX7R7BB104 | 0402 100nF ±10% 16V X7R | TOP | 49.109 | 99.493 | 270.0 | U_FMRD1616E
C44 | NC | 0402_Z | C1525 | 国巨(Yageo)/风华高科 | CC0402KRX7RNC | 0402 NC ±10% X7R | TOP | 58.578 | 71.125 | 0.0 | U_FMRD1616E
C42 | 1nF | 0402_Z | C1532 | 国巨(Yageo)/风华高科 | CC0402KRX7R9BB102 | 0402 1nF ±10% 50V X7R | TOP | 56.955 | 71.125 | 0.0 | U_FMRD1616E
C41 | 75pF | 0402_Z | C1544 | 国巨(Yageo)/风华高科 | CC0402JRNPO9BN5R0 | 0402 5pF ±0.25pF 50V C0G | TOP | 56.757 | 79.551 | 0.0 | U_FMRD1616E
C40 | 1nF | 0402_Z | C1532 | 国巨(Yageo)/风华高科 | CC0402KRX7R9BB102 | 0402 1nF ±10% 50V X7R | TOP | 56.955 | 73.691 | 0.0 | U_FMRD1616E
C38 | 0R | 0402_Z | C1525 | 国巨(Yageo)/风华高科 | CC0402_0R | 0402 0R 贴片电容 | TOP | 56.35 | 72.47 | 90.0 | U_FMRD1616E
C37 | 100nF | 0402_Z | C1525 | 国巨(Yageo)/风华高科 | CC0402KRX7R7BB104 | 0402 100nF ±10% 16V X7R | TOP | 50.004 | 99.493 | 270.0 | U_FMRD1616E
C36 | NC | 0402_Z | C1525 | 国巨(Yageo)/风华高科 | CC0402KRX7RNC | 0402 NC ±10% X7R | TOP | 55.321 | 71.125 | 180.0 | U_FMRD1616E
C30 | 0R | 0402_Z | C1525 | 国巨(Yageo)/风华高科 | CC0402_0R | 0402 0R 贴片电容 | TOP | 68.824 | 75.877 | 180.0 | U_FMRD1616E
C29 | 100nF | 0402_Z | C1525 | 国巨(Yageo)/风华高科 | CC0402KRX7R7BB104 | 0402 100nF ±10% 16V X7R | TOP | 45.335 | 99.485 | 270.0 | U_FMRD1616E
C28 | 1nF | 0402_Z | C1532 | 国巨(Yageo)/风华高科 | CC0402KRX7R9BB102 | 0402 1nF ±10% 50V X7R | TOP | 67.444 | 75.391 | 90.0 | U_FMRD1616E
C27 | NC | 0402_Z | C1525 | 国巨(Yageo)/风华高科 | CC0402KRX7RNC | 0402 NC ±10% X7R | TOP | 70.185 | 76.245 | 270.0 | U_FMRD1616E
C24 | 1nF | 0402_Z | C1532 | 国巨(Yageo)/风华高科 | CC0402KRX7R9BB102 | 0402 1nF ±10% 50V X7R | TOP | 74.58 | 75.411 | 90.0 | U_FMRD1616E
C23 | 75pF | 0402_Z | C1544 | 国巨(Yageo)/风华高科 | CC0402JRNPO9BN5R0 | 0402 5pF ±0.25pF 50V C0G | TOP | 63.496 | 75.391 | 90.0 | U_FMRD1616E
C20 | 0R | 0402_Z | C1525 | 国巨(Yageo)/风华高科 | CC0402_0R | 0402 0R 贴片电容 | TOP | 68.824 | 74.926 | 180.0 | U_FMRD1616E
C19 | 100nF | 0402_Z | C1525 | 国巨(Yageo)/风华高科 | CC0402KRX7R7BB104 | 0402 100nF ±10% 16V X7R | TOP | 46.23 | 99.482 | 270.0 | U_FMRD1616E
C18 | NC | 0402_Z | C1525 | 国巨(Yageo)/风华高科 | CC0402KRX7RNC | 0402 NC ±10% X7R | TOP | 70.173 | 74.571 | 90.0 | U_FMRD1616E
C113 | 5pF | 0402_Z | C1544 | 国巨(Yageo)/风华高科 | CC0402JRNPO9BN5R0 | 0402 5pF ±0.25pF 50V C0G | TOP | 45.964 | 120.364 | 270.0 | U_RF_circuit
U17 | PD0900U03-070 | PD0900U03-070 | C2842421 | 国产微波 | PD0900U03-070 | 800-1000MHz 3dB 90度正交电桥/功分器 | TOP | 81.795 | 85.701 | 90.0 | U_RF_circuit
U15 | MS2351 | MS2351 | C2842417 | 杭州瑞盟(Ruimeng) | MS2351 | 超高频低噪放大射频前端IC QFN-16 | TOP | 76.931 | 80.92 | 180.0 | U_RF_circuit
Y2 | XTAL 3225 | XTAL_2520 | C38807 | 扬兴晶振(YXC) | X3225XTAL 3225 | 贴片无源晶振 3225 XTAL 3225 | TOP | 63.219 | 86.825 | 180.0 | U_MCU_SLAVE
U37 | GD32E232K8Q7TR | QFN-32_L4.0-W4.0-P0.40-TL-EP2.8 | C2838501 | 兆易创新(GigaDevice) | GD32E232K8Q7TR | ARM Cortex-M23 32位MCU QFN-32 | TOP | 65.407 | 91.019 | 90.0 | U_MCU_SLAVE
R57 | 10K | 0402_Z | C25744 | 厚声(UniOhm)/风华高科 | 0402WGF1002TCE | 0402 10kΩ ±1% 贴片电阻 | TOP | 62.182 | 89.551 | 270.0 | U_MCU_SLAVE
R56 | 4.7K | 0402_Z | C25091 | 厚声(UniOhm)/风华高科 | 0402WGF4701TCE | 0402 4.7kΩ ±1% 贴片电阻 | TOP | 65.745 | 86.012 | 180.0 | U_MCU_SLAVE
R2 | 33R | 0402_Z | C25076 | 厚声(UniOhm)/风华高科 | 0402WGF33RTCE | 0402 33R ±1% 贴片电阻 | TOP | 68.979 | 88.844 | 180.0 | U_MCU
R1 | 33R | 0402_Z | C25076 | 厚声(UniOhm)/风华高科 | 0402WGF33RTCE | 0402 33R ±1% 贴片电阻 | TOP | 68.961 | 89.799 | 0.0 | U_MCU
R50 | 110k | 0603_Z | C25076 | 厚声(UniOhm)/风华高科 | 0402WGF110kTCE | 0402 110k ±1% 贴片电阻 | TOP | 36.807 | 121.576 | 90.0 | U_Power_Sch
P1 | Header20 | Header20 | C99999 | 国产优质供应 | Header20 | Header20 Header20 | TOP | 26.513 | 92.007 | 180.0 | U_MCU
L48 | BEAD | 0603_Z | C1005 | 顺络(Sunlord)/麦捷科技 | SDCL1005CBEADSTF | 0402 BEAD 高频叠层贴片电感 | TOP | 68.388 | 86.928 | 270.0 | U_MCU_SLAVE
L46 | 4.7 uH | INDC 4040X25N | C1005 | 顺络(Sunlord)/麦捷科技 | SDCL1005C4.7 uHSTF | 0402 4.7 uH 高频叠层贴片电感 | TOP | 34.56 | 117.414 | 180.0 | U_Power_Sch
C218 | 10 nF | 0402_Z | C1533 | 国巨(Yageo)/风华高科 | CC0402KRX7R9BB103 | 0402 10nF ±10% 50V X7R | TOP | 66.289 | 87.414 | 270.0 | U_MCU_SLAVE
C219 | 100 nF | 0402_Z | C1525 | 国巨(Yageo)/风华高科 | CC0402KRX7R7BB104 | 0402 100nF ±10% 16V X7R | TOP | 67.189 | 87.414 | 270.0 | U_MCU_SLAVE
C221 | 100 nF | 0402_Z | C1525 | 国巨(Yageo)/风华高科 | CC0402KRX7R7BB104 | 0402 100nF ±10% 16V X7R | TOP | 68.4 | 93.125 | 0.0 | U_MCU_SLAVE
C220 | 4.7 uF | 0603_Z | C52923 | 国巨(Yageo)/风华高科 | CC0402KRX5R4.7 uF | 0402 4.7 uF ±10% 贴片电容 | TOP | 68.575 | 94.5 | 0.0 | U_MCU_SLAVE
C217 | 20pF NP0 | 0402_Z | C1546 | 国巨(Yageo)/风华高科 | CC0402JRNPO9BN20pF NP0 | 0402 20pF NP0 ±5% 50V C0G | TOP | 61.132 | 87.401 | 90.0 | U_MCU_SLAVE
C216 | 20pF NP0 | 0402_Z | C1546 | 国巨(Yageo)/风华高科 | CC0402JRNPO9BN20pF NP0 | 0402 20pF NP0 ±5% 50V C0G | TOP | 65.378 | 87.396 | 90.0 | U_MCU_SLAVE
R27 | 0 | 0805 | C17168 | 厚声(UniOhm)/风华高科 | 0402WGF0000TCE | 0402 0Ω ±1% 贴片电阻 | TOP | 75.435 | 126.623 | 180.0 | U_RF_circuit
U35 | SGM2036-1.8V | SOT-23-5 | C312519 | 圣邦微(SGMICRO) | SGM2036-1.8YN5G/TR | 300mA 超低噪声高PSRR LDO SOT-23-5 | TOP | 34.889 | 99.845 | 0.0 | U_Power_Sch
C189 | 4.7uF | 0805_Z | C52923 | 国巨(Yageo)/风华高科 | CC0402KRX5R4.7uF | 0402 4.7uF ±10% 贴片电容 | TOP | 34.047 | 126.671 | 180.0 | U_Power_Sch
U25 | SY8121BABC | SOT-23-6_L2.9-W1.6-P0.95-LS2.8-TL | C2842416 | 矽力杰(Silergy) | SY8121BABC | 18V 2A 高效同步降压转换器 SOT-23-6 | TOP | 34.052 | 122.455 | 180.0 | U_Power_Sch
C180 | 100 pF | 0402_Z | C1546 | 国巨(Yageo)/风华高科 | CC0402JRNPO9BN101 | 0402 100pF ±5% 50V C0G | TOP | 52.152 | 100.809 | 180.0 | U_RF_circuit
RF4 | SMA | SMAmini - duplicate | C492348 | 灿科盟(CKMTW) | SMA-KWE | RF同轴连接器 SMA母头微带贴片座 | TOP | 92.498 | 120.171 | 180.0 | U_RF_circuit
C124 | 100pF | 0402_Z | C1546 | 国巨(Yageo)/风华高科 | CC0402JRNPO9BN101 | 0402 100pF ±5% 50V C0G | TOP | 86.243 | 118.223 | 90.0 | U_RF_circuit
R35 | 1k | 0402_Z | C25087 | 厚声(UniOhm)/风华高科 | 0402WGF1001TCE | 0402 1kΩ ±1% 贴片电阻 | TOP | 74.492 | 107.209 | 270.0 | U_RF_circuit
R33 | 2k | 0402_Z | C25890 | 厚声(UniOhm)/风华高科 | 0402WGF2201TCE | 0402 2.2kΩ ±1% 贴片电阻 | TOP | 75.381 | 107.209 | 270.0 | U_RF_circuit
U13 | MXD8625C | BGA-6_L1.1-W0.7-R3-C2-P0.40-BR | C2838505 | 卓胜微(Maxscend) | MXD8625C | 高隔离度大功率 SPDT 射频开关 DFN-6 | TOP | 86.465 | 120.171 | 180.0 | U_RF_circuit
C128 | 100pF | 0402_Z | C1546 | 国巨(Yageo)/风华高科 | CC0402JRNPO9BN101 | 0402 100pF ±5% 50V C0G | TOP | 87.106 | 121.696 | 180.0 | U_RF_circuit
C127 | 100pF | 0402_Z | C1546 | 国巨(Yageo)/风华高科 | CC0402JRNPO9BN101 | 0402 100pF ±5% 50V C0G | TOP | 88.959 | 120.171 | 0.0 | U_RF_circuit
C123 | 100pF | 0402_Z | C1546 | 国巨(Yageo)/风华高科 | CC0402JRNPO9BN101 | 0402 100pF ±5% 50V C0G | TOP | 88.207 | 118.423 | 180.0 | U_RF_circuit
C155 | 100 pF | 0402_Z | C1546 | 国巨(Yageo)/风华高科 | CC0402JRNPO9BN101 | 0402 100pF ±5% 50V C0G | TOP | 86.199 | 92.917 | 270.0 | U_RF_circuit
C117 | 100pF | 0402_Z | C1546 | 国巨(Yageo)/风华高科 | CC0402JRNPO9BN101 | 0402 100pF ±5% 50V C0G | TOP | 84.778 | 120.713 | 0.0 | U_RF_circuit
C160 | 100 pF | 0402_Z | C1546 | 国巨(Yageo)/风华高科 | CC0402JRNPO9BN101 | 0402 100pF ±5% 50V C0G | TOP | 82.442 | 98.982 | 90.0 | U_RF_circuit
C151 | 100 pF | 0402_Z | C1546 | 国巨(Yageo)/风华高科 | CC0402JRNPO9BN101 | 0402 100pF ±5% 50V C0G | TOP | 77.946 | 86.596 | 180.0 | U_RF_circuit
C190 | 10uF | 0805_Z | C19702 | 国巨(Yageo)/风华高科 | CC0603KRX5R6BB106 | 0603 10uF ±20% 10V X5R | TOP | 34.047 | 125.052 | 180.0 | U_Power_Sch
L38 | 4.9nH | 0603_Z | C1005 | 顺络(Sunlord)/麦捷科技 | SDCL1005C4.9nHSTF | 0402 4.9nH 高频叠层贴片电感 | TOP | 65.867 | 120.79 | 180.0 | U_RF_circuit
L39 | 2.7nH | 0603_Z | C1005 | 顺络(Sunlord)/麦捷科技 | SDCL1005C2.7nHSTF | 0402 2.7nH 高频叠层贴片电感 | TOP | 71.988 | 120.79 | 180.0 | U_RF_circuit
C110 | NC | 0402_Z | C1525 | 国巨(Yageo)/风华高科 | CC0402KRX7RNC | 0402 NC ±10% X7R | TOP | 43.623 | 121.229 | 270.0 | U_RF_circuit
C109 | 100pF | 0603_Z | C1546 | 国巨(Yageo)/风华高科 | CC0402JRNPO9BN101 | 0402 100pF ±5% 50V C0G | TOP | 75.594 | 120.79 | 180.0 | U_RF_circuit
C100 | 8.2pF | 0402_Z | C1551 | 国巨(Yageo)/风华高科 | CC0402JRNPO9BN100 | 0402 10pF ±5% 50V C0G | TOP | 67.681 | 120.364 | 270.0 | U_RF_circuit
C108 | 47pF | 0603_Z | C1548 | 国巨(Yageo)/风华高科 | CC0402JRNPO9BN470 | 0402 47pF ±5% 50V C0G | TOP | 69.37 | 120.79 | 180.0 | U_RF_circuit
C115 | NC | 0402_Z | C1525 | 国巨(Yageo)/风华高科 | CC0402KRX7RNC | 0402 NC ±10% X7R | TOP | 47.236 | 120.364 | 270.0 | U_RF_circuit
C112 | 0.9pF | 0402_Z | C1540 | 国巨(Yageo)/风华高科 | CC0402JRNPO9BN1R0 | 0402 1pF ±0.25pF 50V C0G | TOP | 73.777 | 120.328 | 90.0 | U_RF_circuit
Y1 | XTAL 3225 | XTAL_2520 | C38807 | 扬兴晶振(YXC) | X3225XTAL 3225 | 贴片无源晶振 3225 XTAL 3225 | TOP | 42.75 | 73.455 | 90.0 | U_MCU
U34 | SGM2036-2.8V | SOT-23-5 | C312520 | 圣邦微(SGMICRO) | SGM2036-2.8YN5G/TR | 300mA 超低噪声高PSRR LDO SOT-23-5 | TOP | 81.327 | 126.534 | 0.0 | U_Power_Sch
U33 | SGM2036-ADJ | SOT-23-5 | C312523 | 圣邦微(SGMICRO) | SGM2036-ADJYN5G/TR | 300mA 可调超低噪声高PSRR LDO SOT-23-5 | TOP | 41.757 | 125.776 | 0.0 | U_Power_Sch
U32 | SGM2036-3.3V | SOT-23-5 | C312521 | 圣邦微(SGMICRO) | SGM2036-3.3YN5G/TR | 300mA 超低噪声高PSRR LDO SOT-23-5 | TOP | 50.422 | 104.109 | 0.0 | U_Power_Sch
U31 | SGM2036-5V | SOT-23-5 | C312522 | 圣邦微(SGMICRO) | SGM2036-5.0YN5G/TR | 300mA 超低噪声高PSRR LDO SOT-23-5 | TOP | 79.534 | 73.822 | 180.0 | U_Power_Sch
U30 | SGM2036-3.3V | SOT-23-5 | C312521 | 圣邦微(SGMICRO) | SGM2036-3.3YN5G/TR | 300mA 超低噪声高PSRR LDO SOT-23-5 | TOP | 47.738 | 72.464 | 0.0 | U_Power_Sch
U29 | SGM2036-3.3V | SOT-23-5 | C312521 | 圣邦微(SGMICRO) | SGM2036-3.3YN5G/TR | 300mA 超低噪声高PSRR LDO SOT-23-5 | TOP | 34.625 | 89.789 | 90.0 | U_Power_Sch
U28 | SY8121BABC | SOT-23-6_L2.9-W1.6-P0.95-LS2.8-TL | C2842416 | 矽力杰(Silergy) | SY8121BABC | 18V 2A 高效同步降压转换器 SOT-23-6 | TOP | 34.782 | 79.301 | 180.0 | U_Power_Sch
U26 | SGM2036-5V | SOT-23-5 | C312522 | 圣邦微(SGMICRO) | SGM2036-5.0YN5G/TR | 300mA 超低噪声高PSRR LDO SOT-23-5 | TOP | 87.061 | 73.392 | 0.0 | U_Power_Sch
U22 | MXD8625C | BGA-6_L1.1-W0.7-R3-C2-P0.40-BR | C2838505 | 卓胜微(Maxscend) | MXD8625C | 高隔离度大功率 SPDT 射频开关 DFN-6 | TOP | 77.229 | 108.952 | 0.0 | U_RF_circuit
u24 | FW1103 | FW1103W | C2901240 | 国产射频 | FW1103 | 多功能射频数字衰减/移相器 QFN-16 | TOP | 77.717 | 90.033 | 0.0 | U_RF_circuit
U21 | HGC2005LP4 | HGC2005LP4 | C2842418 | 海矽半导体(HGC) | HGC2005LP4 | 超高频射频高增益驱动功放 QFN-24 | TOP | 61.57 | 104.853 | 270.0 | U_RF_circuit
U23 | MXD8625C | BGA-6_L1.1-W0.7-R3-C2-P0.40-BR | C2838505 | 卓胜微(Maxscend) | MXD8625C | 高隔离度大功率 SPDT 射频开关 DFN-6 | TOP | 82.049 | 100.826 | 0.0 | U_RF_circuit
U20 | DC09T10 | DC09T10 | C2842420 | 国产微波 | DC09T10 | UHF频段贴片高隔离定向耦合器 SMD | TOP | 81.021 | 81.391 | 180.0 | U_RF_circuit
u19 | FW1103 | FW1103W | C2901240 | 国产射频 | FW1103 | 多功能射频数字衰减/移相器 QFN-16 | TOP | 85.992 | 82.655 | 180.0 | U_RF_circuit
u18 | FW1103 | FW1103W | C2901240 | 国产射频 | FW1103 | 多功能射频数字衰减/移相器 QFN-16 | TOP | 85.934 | 96.773 | 180.0 | U_RF_circuit
U16 | HGC2005LP4 | HGC2005LP4 | C2842418 | 海矽半导体(HGC) | HGC2005LP4 | 超高频射频高增益驱动功放 QFN-24 | TOP | 86.991 | 89.408 | 270.0 | U_RF_circuit
U9 | DC0900P10 | DC0900P10 | C2842419 | Anaren/国产微波 | XC0900P-10S | 800-1000MHz 10dB微波定向耦合器 SMD | TOP | 80.517 | 118.606 | 90.0 | U_RF_circuit
U5 | SLBL18-1R500G -05-31T | Balun-0900BL15C050 | C103501 | 顺络(Sunlord) | SLBL18-1R500G | 射频叠层巴伦/平衡-不平衡转换器 0603 | TOP | 42.259 | 102.895 | 270.0 | U_FMRD1616E
U4 | FM13RD1616 | FM13RD1616E | C2842415 | 复旦微(FMSH) | FM13RD1616 | UHF RFID 读写器单芯片SOC QFN-64 | TOP | 46.007 | 91.49 | 270.0 | U_FMRD1616E
U3 | SLBL18-1R500G -05-31T | Balun-0900BL15C050 | C103501 | 顺络(Sunlord) | SLBL18-1R500G | 射频叠层巴伦/平衡-不平衡转换器 0603 | TOP | 55.864 | 93.159 | 180.0 | U_FMRD1616E
U2 | SLBL18-1R500G -05-31T | Balun-0900BL15C050 | C103501 | 顺络(Sunlord) | SLBL18-1R500G | 射频叠层巴伦/平衡-不平衡转换器 0603 | TOP | 51.564 | 99.014 | 270.0 | U_FMRD1616E
U1 | FM15F366 | QFN40 5X5X04P | C5269846 | 复旦微(FMSH) | FM15F366 | 32位安全超低功耗微控制器 LQFP-48 | TOP | 40.642 | 80.931 | 270.0 | U_MCU
RX2 | 1k | 0402_Z | C25087 | 厚声(UniOhm)/风华高科 | 0402WGF1001TCE | 0402 1kΩ ±1% 贴片电阻 | TOP | 41.282 | 127.663 | 0.0 | U_Power_Sch
RX1 | 2.3k | 0402_Z | C25076 | 厚声(UniOhm)/风华高科 | 0402WGF2.3kTCE | 0402 2.3k ±1% 贴片电阻 | TOP | 42.832 | 127.651 | 180.0 | U_Power_Sch
R54 | 22k | 0603_Z | C25076 | 厚声(UniOhm)/风华高科 | 0402WGF22kTCE | 0402 22k ±1% 贴片电阻 | TOP | 37.5 | 82.025 | 90.0 | U_Power_Sch
R53 | 168k | 0603_Z | C25076 | 厚声(UniOhm)/风华高科 | 0402WGF168kTCE | 0402 168k ±1% 贴片电阻 | TOP | 37.325 | 79.45 | 90.0 | U_Power_Sch
R47 | 50 | 0402_Z | C25118 | 厚声(UniOhm)/风华高科 | 0402WGF499JTCE | 0402 49.9Ω ±1% 贴片电阻 | TOP | 62.3 | 101.875 | 180.0 | U_RF_circuit
R45 | 50 | 0402_Z | C25118 | 厚声(UniOhm)/风华高科 | 0402WGF499JTCE | 0402 49.9Ω ±1% 贴片电阻 | TOP | 72.233 | 88.562 | 90.0 | U_RF_circuit
R44 | 6.5k | 0402_Z | C25076 | 厚声(UniOhm)/风华高科 | 0402WGF6.5kTCE | 0402 6.5k ±1% 贴片电阻 | TOP | 73.142 | 91.552 | 270.0 | U_RF_circuit
R43 | 50 | 0402_Z | C25118 | 厚声(UniOhm)/风华高科 | 0402WGF499JTCE | 0402 49.9Ω ±1% 贴片电阻 | TOP | 87.709 | 86.1 | 180.0 | U_RF_circuit
R42 | 50 | 0402_Z | C25118 | 厚声(UniOhm)/风华高科 | 0402WGF499JTCE | 0402 49.9Ω ±1% 贴片电阻 | TOP | 80.885 | 83.131 | 90.0 | U_RF_circuit
R41 | 50 | 0402_Z | C25118 | 厚声(UniOhm)/风华高科 | 0402WGF499JTCE | 0402 49.9Ω ±1% 贴片电阻 | TOP | 90.66 | 84.198 | 270.0 | U_RF_circuit
R40 | 50 | 0402_Z | C25118 | 厚声(UniOhm)/风华高科 | 0402WGF499JTCE | 0402 49.9Ω ±1% 贴片电阻 | TOP | 91.39 | 98.204 | 270.0 | U_RF_circuit
R37 | 0R | 0402_Z | C17168 | 厚声(UniOhm)/风华高科 | 0402WGF0000TCE | 0402 0Ω ±1% 贴片电阻 | TOP | 75.19 | 77.724 | 180.0 | U_RF_circuit
R36 | 50R | 0402_Z | C25118 | 厚声(UniOhm)/风华高科 | 0402WGF499JTCE | 0402 49.9Ω ±1% 贴片电阻 | TOP | 80.885 | 79.561 | 90.0 | U_RF_circuit
R39 | 6.5k | 0402_Z | C25076 | 厚声(UniOhm)/风华高科 | 0402WGF6.5kTCE | 0402 6.5k ±1% 贴片电阻 | TOP | 89.79 | 81.171 | 90.0 | U_RF_circuit
R38 | 6.5k | 0402_Z | C25076 | 厚声(UniOhm)/风华高科 | 0402WGF6.5kTCE | 0402 6.5k ±1% 贴片电阻 | TOP | 90.479 | 95.353 | 90.0 | U_RF_circuit
R28 | 11R | 0603_Z | C25076 | 厚声(UniOhm)/风华高科 | 0402WGF11RTCE | 0402 11R ±1% 贴片电阻 | TOP | 52.47 | 125.895 | 270.0 | U_RF_circuit
R13 | 47k | 0402_Z | C25750 | 厚声(UniOhm)/风华高科 | 0402WGF4702TCE | 0402 47kΩ ±1% 贴片电阻 | TOP | 40.2 | 90.175 | 270.0 | U_FMRD1616E
R12 | 47k | 0402_Z | C25750 | 厚声(UniOhm)/风华高科 | 0402WGF4702TCE | 0402 47kΩ ±1% 贴片电阻 | TOP | 39.3 | 90.175 | 270.0 | U_FMRD1616E
R11 | 33R | 0402_Z | C25076 | 厚声(UniOhm)/风华高科 | 0402WGF33RTCE | 0402 33R ±1% 贴片电阻 | TOP | 42.254 | 83.783 | 270.0 | U_FMRD1616E
R10 | 33R | 0402_Z | C25076 | 厚声(UniOhm)/风华高科 | 0402WGF33RTCE | 0402 33R ±1% 贴片电阻 | TOP | 42.75 | 85.392 | 270.0 | U_FMRD1616E
R9 | 33R | 0402_Z | C25076 | 厚声(UniOhm)/风华高科 | 0402WGF33RTCE | 0402 33R ±1% 贴片电阻 | TOP | 43.256 | 83.783 | 270.0 | U_FMRD1616E
R8 | 33R | 0402_Z | C25076 | 厚声(UniOhm)/风华高科 | 0402WGF33RTCE | 0402 33R ±1% 贴片电阻 | TOP | 43.753 | 85.392 | 270.0 | U_FMRD1616E
R7 | 33R | 0402_Z | C25076 | 厚声(UniOhm)/风华高科 | 0402WGF33RTCE | 0402 33R ±1% 贴片电阻 | TOP | 44.257 | 83.783 | 270.0 | U_FMRD1616E
R6 | 33R | 0402_Z | C25076 | 厚声(UniOhm)/风华高科 | 0402WGF33RTCE | 0402 33R ±1% 贴片电阻 | TOP | 44.756 | 85.392 | 270.0 | U_FMRD1616E
R5 | 33R | 0402_Z | C25076 | 厚声(UniOhm)/风华高科 | 0402WGF33RTCE | 0402 33R ±1% 贴片电阻 | TOP | 45.259 | 83.783 | 270.0 | U_FMRD1616E
R4 | 2.7K | 0402_Z | C25076 | 厚声(UniOhm)/风华高科 | 0402WGF2.7KTCE | 0402 2.7K ±1% 贴片电阻 | TOP | 52.223 | 89.019 | 180.0 | U_FMRD1616E
R3 | 4.7K | 0402_Z | C25091 | 厚声(UniOhm)/风华高科 | 0402WGF4701TCE | 0402 4.7kΩ ±1% 贴片电阻 | TOP | 51.804 | 90.362 | 90.0 | U_FMRD1616E
R51 | 22k | 0603_Z | C25076 | 厚声(UniOhm)/风华高科 | 0402WGF22kTCE | 0402 22k ±1% 贴片电阻 | TOP | 36.807 | 124.301 | 90.0 | U_Power_Sch
P5 | SF9078 | SF8009 | C99999 | 国产优质供应 | SF9078 | SF8009 SF9078 | TOP | 55.262 | 100.808 | 90.0 | U_RF_circuit
P4 | SF9078 | SF8009 | C99999 | 国产优质供应 | SF9078 | SF8009 SF9078 | TOP | 86.185 | 101.907 | 0.0 | U_RF_circuit
P2 | SF9078 | SF8009 | C99999 | 国产优质供应 | SF9078 | SF8009 SF9078 | TOP | 59.998 | 95.572 | 180.0 | U_FMRD1616E
LDMOS1 | LDMOS | LDMOS | C1005 | 顺络(Sunlord)/麦捷科技 | SDCL1005CLDMOSSTF | 0402 LDMOS 高频叠层贴片电感 | TOP | 57.162 | 120.763 | 0.0 | U_RF_circuit
L47 | 4.7 uH | INDC 4040X25N | C1005 | 顺络(Sunlord)/麦捷科技 | SDCL1005C4.7 uHSTF | 0402 4.7 uH 高频叠层贴片电感 | TOP | 35.398 | 74.46 | 180.0 | U_Power_Sch
L45 | 47nH | 0402_Z | C1005 | 顺络(Sunlord)/麦捷科技 | SDCL1005C47nHSTF | 0402 47nH 高频叠层贴片电感 | TOP | 76.198 | 91.895 | 0.0 | U_RF_circuit
L44 | 18nH | 0402_Z | C1005 | 顺络(Sunlord)/麦捷科技 | SDCL1005C18nHSTF | 0402 18nH 高频叠层贴片电感 | TOP | 76.208 | 88.221 | 0.0 | U_RF_circuit
L43 | 47nH | 0402_Z | C1005 | 顺络(Sunlord)/麦捷科技 | SDCL1005C47nHSTF | 0402 47nH 高频叠层贴片电感 | TOP | 86.672 | 80.822 | 180.0 | U_RF_circuit
L42 | 47nH | 0402_Z | C1005 | 顺络(Sunlord)/麦捷科技 | SDCL1005C47nHSTF | 0402 47nH 高频叠层贴片电感 | TOP | 87.37 | 94.936 | 180.0 | U_RF_circuit
L41 | 18nH | 0402_Z | C1005 | 顺络(Sunlord)/麦捷科技 | SDCL1005C18nHSTF | 0402 18nH 高频叠层贴片电感 | TOP | 86.672 | 84.496 | 180.0 | U_RF_circuit
L40 | 18nH | 0402_Z | C1005 | 顺络(Sunlord)/麦捷科技 | SDCL1005C18nHSTF | 0402 18nH 高频叠层贴片电感 | TOP | 87.452 | 98.611 | 180.0 | U_RF_circuit
L35 | BEAD | 0603_Z | C1005 | 顺络(Sunlord)/麦捷科技 | SDCL1005CBEADSTF | 0402 BEAD 高频叠层贴片电感 | TOP | 37.469 | 92.867 | 180.0 | U_FMRD1616E
L33 | BEAD | 0603_Z | C1005 | 顺络(Sunlord)/麦捷科技 | SDCL1005CBEADSTF | 0402 BEAD 高频叠层贴片电感 | TOP | 38.768 | 87.334 | 270.0 | U_FMRD1616E
L32 | BEAD | 0603_Z | C1005 | 顺络(Sunlord)/麦捷科技 | SDCL1005CBEADSTF | 0402 BEAD 高频叠层贴片电感 | TOP | 37.479 | 94.444 | 180.0 | U_FMRD1616E
L31 | BEAD | 0603_Z | C1005 | 顺络(Sunlord)/麦捷科技 | SDCL1005CBEADSTF | 0402 BEAD 高频叠层贴片电感 | TOP | 40.354 | 84.917 | 270.0 | U_FMRD1616E
L30 | BEAD | 0603_Z | C1005 | 顺络(Sunlord)/麦捷科技 | SDCL1005CBEADSTF | 0402 BEAD 高频叠层贴片电感 | TOP | 39.383 | 100.607 | 180.0 | U_FMRD1616E
L29 | 8.2nH | 0402_Z | C1005 | 顺络(Sunlord)/麦捷科技 | SDCL1005C8.2nHSTF | 0402 8.2nH 高频叠层贴片电感 | TOP | 41.782 | 97.682 | 270.0 | U_FMRD1616E
L28 | 8.2nH | 0402_Z | C1005 | 顺络(Sunlord)/麦捷科技 | SDCL1005C8.2nHSTF | 0402 8.2nH 高频叠层贴片电感 | TOP | 44.277 | 97.704 | 270.0 | U_FMRD1616E
L27 | 1.8nH | 0402_Z | C1005 | 顺络(Sunlord)/麦捷科技 | SDCL1005C1.8nHSTF | 0402 1.8nH 高频叠层贴片电感 | TOP | 42.566 | 99.185 | 90.0 | U_FMRD1616E
L26 | 1.8nH | 0402_Z | C1005 | 顺络(Sunlord)/麦捷科技 | SDCL1005C1.8nHSTF | 0402 1.8nH 高频叠层贴片电感 | TOP | 43.418 | 99.185 | 90.0 | U_FMRD1616E
L25 | BEAD | 0603_Z | C1005 | 顺络(Sunlord)/麦捷科技 | SDCL1005CBEADSTF | 0402 BEAD 高频叠层贴片电感 | TOP | 47.552 | 101.062 | 90.0 | U_FMRD1616E
L24 | BEAD | 0603_Z | C1005 | 顺络(Sunlord)/麦捷科技 | SDCL1005CBEADSTF | 0402 BEAD 高频叠层贴片电感 | TOP | 47.54 | 83.97 | 270.0 | U_FMRD1616E
L21 | BEAD | 0603_Z | C1005 | 顺络(Sunlord)/麦捷科技 | SDCL1005CBEADSTF | 0402 BEAD 高频叠层贴片电感 | TOP | 50.325 | 83.97 | 270.0 | U_FMRD1616E
L16 | 12 nH | 0402_Z | C1005 | 顺络(Sunlord)/麦捷科技 | SDCL1005C12 nHSTF | 0402 12 nH 高频叠层贴片电感 | TOP | 53.416 | 92.469 | 270.0 | U_FMRD1616E
L13 | BEAD | 0603_Z | C1005 | 顺络(Sunlord)/麦捷科技 | SDCL1005CBEADSTF | 0402 BEAD 高频叠层贴片电感 | TOP | 54.863 | 97.397 | 0.0 | U_FMRD1616E
L11 | 1nH | 0402_Z | C1005 | 顺络(Sunlord)/麦捷科技 | SDCL1005C1nHSTF | 0402 1nH 高频叠层贴片电感 | TOP | 52.778 | 95.572 | 270.0 | U_FMRD1616E
L10 | BEAD | 0603_Z | C1005 | 顺络(Sunlord)/麦捷科技 | SDCL1005CBEADSTF | 0402 BEAD 高频叠层贴片电感 | TOP | 53.673 | 86.626 | 0.0 | U_FMRD1616E
L6 | 1nH | 0402_Z | C1005 | 顺络(Sunlord)/麦捷科技 | SDCL1005C1nHSTF | 0402 1nH 高频叠层贴片电感 | TOP | 51.797 | 95.572 | 270.0 | U_FMRD1616E
L5 | BEAD | 0603_Z | C1005 | 顺络(Sunlord)/麦捷科技 | SDCL1005CBEADSTF | 0402 BEAD 高频叠层贴片电感 | TOP | 55.864 | 87.334 | 270.0 | U_FMRD1616E
L4 | 33nH | 0603_Z | C1005 | 顺络(Sunlord)/麦捷科技 | SDCL1005C33nHSTF | 0402 33nH 高频叠层贴片电感 | TOP | 58.034 | 91.576 | 180.0 | U_FMRD1616E
L3 | MMZ1608B601C | 0402_Z | C1005 | 顺络(Sunlord)/麦捷科技 | SDCL1005CMMZ1608B601CSTF | 0402 MMZ1608B601C 高频叠层贴片电感 | TOP | 39.223 | 76.01 | 180.0 | U_MCU
L2 | MMZ1608B601C | 0402_Z | C1005 | 顺络(Sunlord)/麦捷科技 | SDCL1005CMMZ1608B601CSTF | 0402 MMZ1608B601C 高频叠层贴片电感 | TOP | 39.223 | 75.095 | 180.0 | U_MCU
L1 | BEAD | 0603_Z | C1005 | 顺络(Sunlord)/麦捷科技 | SDCL1005CBEADSTF | 0402 BEAD 高频叠层贴片电感 | TOP | 47.518 | 76.113 | 0.0 | U_MCU
F1 | JFC1206-1300FS | F1206 | C99999 | 国产优质供应 | JFC1206-1300FS | F1206 JFC1206-1300FS | TOP | 31.6 | 81.425 | 270.0 | U_Power_Sch
C213 | 1uF | 0603_Z | C15849 | 国巨(Yageo)/风华高科 | CC0603KRX7R9BB105 | 0603 1uF ±10% 50V X7R | TOP | 37.498 | 99.982 | 90.0 | U_Power_Sch
C212 | 1uF | 0603_Z | C15849 | 国巨(Yageo)/风华高科 | CC0603KRX7R9BB105 | 0603 1uF ±10% 50V X7R | TOP | 33.818 | 97.149 | 90.0 | U_Power_Sch
C211 | 1uF | 0603_Z | C15849 | 国巨(Yageo)/风华高科 | CC0603KRX7R9BB105 | 0603 1uF ±10% 50V X7R | TOP | 84.073 | 126.76 | 90.0 | U_Power_Sch
C210 | 1uF | 0603_Z | C15849 | 国巨(Yageo)/风华高科 | CC0603KRX7R9BB105 | 0603 1uF ±10% 50V X7R | TOP | 78.493 | 126.76 | 90.0 | U_Power_Sch
C209 | 1uF | 0603_Z | C15849 | 国巨(Yageo)/风华高科 | CC0603KRX7R9BB105 | 0603 1uF ±10% 50V X7R | TOP | 44.895 | 126.009 | 90.0 | U_Power_Sch
C208 | 1uF | 0603_Z | C15849 | 国巨(Yageo)/风华高科 | CC0603KRX7R9BB105 | 0603 1uF ±10% 50V X7R | TOP | 39.186 | 126.003 | 90.0 | U_Power_Sch
C207 | 1uF | 0603_Z | C15849 | 国巨(Yageo)/风华高科 | CC0603KRX7R9BB105 | 0603 1uF ±10% 50V X7R | TOP | 53.201 | 104.274 | 90.0 | U_Power_Sch
C206 | 1uF | 0603_Z | C15849 | 国巨(Yageo)/风华高科 | CC0603KRX7R9BB105 | 0603 1uF ±10% 50V X7R | TOP | 47.832 | 104.326 | 90.0 | U_Power_Sch
C205 | 1uF | 0603_Z | C15849 | 国巨(Yageo)/风华高科 | CC0603KRX7R9BB105 | 0603 1uF ±10% 50V X7R | TOP | 76.778 | 73.597 | 270.0 | U_Power_Sch
C204 | 1uF | 0603_Z | C15849 | 国巨(Yageo)/风华高科 | CC0603KRX7R9BB105 | 0603 1uF ±10% 50V X7R | TOP | 82.36 | 73.597 | 270.0 | U_Power_Sch
C203 | 1uF | 0603_Z | C15849 | 国巨(Yageo)/风华高科 | CC0603KRX7R9BB105 | 0603 1uF ±10% 50V X7R | TOP | 47.553 | 74.689 | 0.0 | U_Power_Sch
C202 | 1uF | 0603_Z | C15849 | 国巨(Yageo)/风华高科 | CC0603KRX7R9BB105 | 0603 1uF ±10% 50V X7R | TOP | 44.889 | 72.689 | 90.0 | U_Power_Sch
C201 | 1uF | 0603_Z | C15849 | 国巨(Yageo)/风华高科 | CC0603KRX7R9BB105 | 0603 1uF ±10% 50V X7R | TOP | 33.95 | 93.1 | 270.0 | U_Power_Sch
C200 | 1uF | 0603_Z | C15849 | 国巨(Yageo)/风华高科 | CC0603KRX7R9BB105 | 0603 1uF ±10% 50V X7R | TOP | 34.749 | 86.75 | 0.0 | U_Power_Sch
C199 | 10uF | 0805_Z | C19702 | 国巨(Yageo)/风华高科 | CC0603KRX5R6BB106 | 0603 10uF ±20% 10V X5R | TOP | 34.8 | 83.681 | 180.0 | U_Power_Sch
C198 | 4.7uF | 0805_Z | C52923 | 国巨(Yageo)/风华高科 | CC0402KRX5R4.7uF | 0402 4.7uF ±10% 贴片电容 | TOP | 34.825 | 81.8 | 180.0 | U_Power_Sch
C192 | 1uF | 0603_Z | C15849 | 国巨(Yageo)/风华高科 | CC0603KRX7R9BB105 | 0603 1uF ±10% 50V X7R | TOP | 89.983 | 73.617 | 90.0 | U_Power_Sch
C191 | 1uF | 0603_Z | C15849 | 国巨(Yageo)/风华高科 | CC0603KRX7R9BB105 | 0603 1uF ±10% 50V X7R | TOP | 84.315 | 73.617 | 90.0 | U_Power_Sch
C195 | 10uF | 0805_Z | C19702 | 国巨(Yageo)/风华高科 | CC0603KRX5R6BB106 | 0603 10uF ±20% 10V X5R | TOP | 37.675 | 71.35 | 180.0 | U_Power_Sch
C194 | 22uF | 0805_Z | C19703 | 国巨(Yageo)/风华高科 | CC0805KRX5R6BB226 | 0805 22uF ±20% 10V X5R | TOP | 32.652 | 71.283 | 0.0 | U_Power_Sch
C193 | 100nF | 0402_Z | C1525 | 国巨(Yageo)/风华高科 | CC0402KRX7R7BB104 | 0402 100nF ±10% 16V X7R | TOP | 34.332 | 77.126 | 180.0 | U_Power_Sch
C172 | 100pF | 0402_Z | C1546 | 国巨(Yageo)/风华高科 | CC0402JRNPO9BN101 | 0402 100pF ±5% 50V C0G | TOP | 76.56 | 110.741 | 270.0 | U_RF_circuit
C179 | 100 pF | 0402_Z | C1546 | 国巨(Yageo)/风华高科 | CC0402JRNPO9BN101 | 0402 100pF ±5% 50V C0G | TOP | 60.411 | 98.756 | 180.0 | U_RF_circuit
C183 | 100 pF | 0402_Z | C1546 | 国巨(Yageo)/风华高科 | CC0402JRNPO9BN101 | 0402 100pF ±5% 50V C0G | TOP | 77.456 | 92.234 | 90.0 | U_RF_circuit
C182 | 100 pF | 0402_Z | C1546 | 国巨(Yageo)/风华高科 | CC0402JRNPO9BN101 | 0402 100pF ±5% 50V C0G | TOP | 77.464 | 87.852 | 90.0 | U_RF_circuit
C175 | 100 pF | 0402_Z | C1546 | 国巨(Yageo)/风华高科 | CC0402JRNPO9BN101 | 0402 100pF ±5% 50V C0G | TOP | 63.482 | 108.001 | 180.0 | U_RF_circuit
C184 | 100pF | 0402_Z | C1546 | 国巨(Yageo)/风华高科 | CC0402JRNPO9BN101 | 0402 100pF ±5% 50V C0G | TOP | 76.297 | 107.199 | 90.0 | U_RF_circuit
C177 | 100 pF | 0402_Z | C1546 | 国巨(Yageo)/风华高科 | CC0402JRNPO9BN101 | 0402 100pF ±5% 50V C0G | TOP | 74.95 | 88.562 | 90.0 | U_RF_circuit
C174 | 100 pF | 0402_Z | C1546 | 国巨(Yageo)/风华高科 | CC0402JRNPO9BN101 | 0402 100pF ±5% 50V C0G | TOP | 74.954 | 91.552 | 270.0 | U_RF_circuit
C171 | 1nF | 0402_Z | C1532 | 国巨(Yageo)/风华高科 | CC0402KRX7R9BB102 | 0402 1nF ±10% 50V X7R | TOP | 74.044 | 88.562 | 90.0 | U_RF_circuit
C170 | 100nF | 0402_Z | C1525 | 国巨(Yageo)/风华高科 | CC0402KRX7R7BB104 | 0402 100nF ±10% 16V X7R | TOP | 74.048 | 91.552 | 270.0 | U_RF_circuit
C169 | 100nF | 0402_Z | C1525 | 国巨(Yageo)/风华高科 | CC0402KRX7R7BB104 | 0402 100nF ±10% 16V X7R | TOP | 73.138 | 88.562 | 90.0 | U_RF_circuit
C167 | 100 pF | 0402_Z | C1546 | 国巨(Yageo)/风华高科 | CC0402JRNPO9BN101 | 0402 100pF ±5% 50V C0G | TOP | 65.316 | 102.16 | 180.0 | U_RF_circuit
C166 | 100 pF | 0402_Z | C1546 | 国巨(Yageo)/风华高科 | CC0402JRNPO9BN101 | 0402 100pF ±5% 50V C0G | TOP | 65.319 | 103.052 | 180.0 | U_RF_circuit
C165 | 100 pF | 0402_Z | C1546 | 国巨(Yageo)/风华高科 | CC0402JRNPO9BN101 | 0402 100pF ±5% 50V C0G | TOP | 65.319 | 103.954 | 180.0 | U_RF_circuit
C164 | 100 pF | 0402_Z | C1546 | 国巨(Yageo)/风华高科 | CC0402JRNPO9BN101 | 0402 100pF ±5% 50V C0G | TOP | 65.301 | 104.868 | 0.0 | U_RF_circuit
C163 | 100 pF | 0402_Z | C1546 | 国巨(Yageo)/风华高科 | CC0402JRNPO9BN101 | 0402 100pF ±5% 50V C0G | TOP | 65.301 | 105.769 | 0.0 | U_RF_circuit
C162 | 100 pF | 0402_Z | C1546 | 国巨(Yageo)/风华高科 | CC0402JRNPO9BN101 | 0402 100pF ±5% 50V C0G | TOP | 65.301 | 106.671 | 0.0 | U_RF_circuit
C161 | 100 pF | 0402_Z | C1546 | 国巨(Yageo)/风华高科 | CC0402JRNPO9BN101 | 0402 100pF ±5% 50V C0G | TOP | 65.309 | 107.59 | 180.0 | U_RF_circuit
C168 | 100 pF | 0402_Z | C1546 | 国巨(Yageo)/风华高科 | CC0402JRNPO9BN101 | 0402 100pF ±5% 50V C0G | TOP | 72.236 | 91.552 | 270.0 | U_RF_circuit
C185 | 100pF | 0402_Z | C1546 | 国巨(Yageo)/风华高科 | CC0402JRNPO9BN101 | 0402 100pF ±5% 50V C0G | TOP | 80.895 | 99.349 | 0.0 | U_RF_circuit
C176 | 100pF | 0402_Z | C1546 | 国巨(Yageo)/风华高科 | CC0402JRNPO9BN101 | 0402 100pF ±5% 50V C0G | TOP | 82.742 | 111.545 | 180.0 | U_RF_circuit
C181 | 100pF | 0402_Z | C1546 | 国巨(Yageo)/风华高科 | CC0402JRNPO9BN101 | 0402 100pF ±5% 50V C0G | TOP | 80.372 | 100.807 | 180.0 | U_RF_circuit
C173 | 100pF | 0402_Z | C1546 | 国巨(Yageo)/风华高科 | CC0402JRNPO9BN101 | 0402 100pF ±5% 50V C0G | TOP | 81.022 | 102.286 | 0.0 | U_RF_circuit
C159 | 100 pF | 0402_Z | C1546 | 国巨(Yageo)/风华高科 | CC0402JRNPO9BN101 | 0402 100pF ±5% 50V C0G | TOP | 81.794 | 83.131 | 90.0 | U_RF_circuit
C158 | 100 pF | 0402_Z | C1546 | 国巨(Yageo)/风华高科 | CC0402JRNPO9BN101 | 0402 100pF ±5% 50V C0G | TOP | 81.794 | 79.561 | 90.0 | U_RF_circuit
C157 | 100 pF | 0402_Z | C1546 | 国巨(Yageo)/风华高科 | CC0402JRNPO9BN101 | 0402 100pF ±5% 50V C0G | TOP | 86.226 | 79.577 | 270.0 | U_RF_circuit
C156 | 100 pF | 0402_Z | C1546 | 国巨(Yageo)/风华高科 | CC0402JRNPO9BN101 | 0402 100pF ±5% 50V C0G | TOP | 86.243 | 85.762 | 270.0 | U_RF_circuit
C154 | 100 pF | 0402_Z | C1546 | 国巨(Yageo)/风华高科 | CC0402JRNPO9BN101 | 0402 100pF ±5% 50V C0G | TOP | 86.199 | 94.599 | 270.0 | U_RF_circuit
C153 | 100 pF | 0402_Z | C1546 | 国巨(Yageo)/风华高科 | CC0402JRNPO9BN101 | 0402 100pF ±5% 50V C0G | TOP | 86.199 | 98.979 | 270.0 | U_RF_circuit
C152 | 100 pF | 0402_Z | C1546 | 国巨(Yageo)/风华高科 | CC0402JRNPO9BN101 | 0402 100pF ±5% 50V C0G | TOP | 87.742 | 93.157 | 270.0 | U_RF_circuit
C150 | 100 pF | 0402_Z | C1546 | 国巨(Yageo)/风华高科 | CC0402JRNPO9BN101 | 0402 100pF ±5% 50V C0G | TOP | 88.061 | 84.198 | 270.0 | U_RF_circuit
C149 | 100 pF | 0402_Z | C1546 | 国巨(Yageo)/风华高科 | CC0402JRNPO9BN101 | 0402 100pF ±5% 50V C0G | TOP | 88.694 | 98.204 | 270.0 | U_RF_circuit
C148 | 100 pF | 0402_Z | C1546 | 国巨(Yageo)/风华高科 | CC0402JRNPO9BN101 | 0402 100pF ±5% 50V C0G | TOP | 88.048 | 81.171 | 90.0 | U_RF_circuit
C147 | 100 pF | 0402_Z | C1546 | 国巨(Yageo)/风华高科 | CC0402JRNPO9BN101 | 0402 100pF ±5% 50V C0G | TOP | 88.682 | 95.353 | 90.0 | U_RF_circuit
C146 | 1nF | 0402_Z | C1532 | 国巨(Yageo)/风华高科 | CC0402KRX7R9BB102 | 0402 1nF ±10% 50V X7R | TOP | 88.927 | 84.198 | 270.0 | U_RF_circuit
C145 | 1nF | 0402_Z | C1532 | 国巨(Yageo)/风华高科 | CC0402KRX7R9BB102 | 0402 1nF ±10% 50V X7R | TOP | 89.593 | 98.204 | 270.0 | U_RF_circuit
C144 | 100nF | 0402_Z | C1525 | 国巨(Yageo)/风华高科 | CC0402KRX7R7BB104 | 0402 100nF ±10% 16V X7R | TOP | 88.919 | 81.171 | 90.0 | U_RF_circuit
C143 | 100nF | 0402_Z | C1525 | 国巨(Yageo)/风华高科 | CC0402KRX7R7BB104 | 0402 100nF ±10% 16V X7R | TOP | 89.581 | 95.353 | 90.0 | U_RF_circuit
C140 | 100 pF | 0402_Z | C1546 | 国巨(Yageo)/风华高科 | CC0402JRNPO9BN101 | 0402 100pF ±5% 50V C0G | TOP | 76.931 | 83.122 | 180.0 | U_RF_circuit
C142 | 100nF | 0402_Z | C1525 | 国巨(Yageo)/风华高科 | CC0402KRX7R7BB104 | 0402 100nF ±10% 16V X7R | TOP | 89.794 | 84.198 | 270.0 | U_RF_circuit
C141 | 100nF | 0402_Z | C1525 | 国巨(Yageo)/风华高科 | CC0402KRX7R7BB104 | 0402 100nF ±10% 16V X7R | TOP | 90.492 | 98.204 | 270.0 | U_RF_circuit
C139 | 100 pF | 0402_Z | C1546 | 国巨(Yageo)/风华高科 | CC0402JRNPO9BN101 | 0402 100pF ±5% 50V C0G | TOP | 90.791 | 86.157 | 180.0 | U_RF_circuit
C138 | 100 pF | 0402_Z | C1546 | 国巨(Yageo)/风华高科 | CC0402JRNPO9BN101 | 0402 100pF ±5% 50V C0G | TOP | 90.791 | 87.201 | 180.0 | U_RF_circuit
C135 | 100 pF | 0402_Z | C1546 | 国巨(Yageo)/风华高科 | CC0402JRNPO9BN101 | 0402 100pF ±5% 50V C0G | TOP | 90.791 | 88.244 | 180.0 | U_RF_circuit
C133 | 100 pF | 0402_Z | C1546 | 国巨(Yageo)/风华高科 | CC0402JRNPO9BN101 | 0402 100pF ±5% 50V C0G | TOP | 90.773 | 89.3 | 0.0 | U_RF_circuit
C132 | 100 pF | 0402_Z | C1546 | 国巨(Yageo)/风华高科 | CC0402JRNPO9BN101 | 0402 100pF ±5% 50V C0G | TOP | 90.773 | 90.343 | 0.0 | U_RF_circuit
C130 | 100 pF | 0402_Z | C1546 | 国巨(Yageo)/风华高科 | CC0402JRNPO9BN101 | 0402 100pF ±5% 50V C0G | TOP | 90.773 | 91.386 | 0.0 | U_RF_circuit
C129 | 100 pF | 0402_Z | C1546 | 国巨(Yageo)/风华高科 | CC0402JRNPO9BN101 | 0402 100pF ±5% 50V C0G | TOP | 90.791 | 92.4 | 180.0 | U_RF_circuit
C137 | 100 pF | 0402_Z | C1546 | 国巨(Yageo)/风华高科 | CC0402JRNPO9BN101 | 0402 100pF ±5% 50V C0G | TOP | 90.66 | 81.171 | 90.0 | U_RF_circuit
C136 | 100 pF | 0402_Z | C1546 | 国巨(Yageo)/风华高科 | CC0402JRNPO9BN101 | 0402 100pF ±5% 50V C0G | TOP | 91.378 | 95.353 | 90.0 | U_RF_circuit
C134 | 100nF | 0402_Z | C1525 | 国巨(Yageo)/风华高科 | CC0402KRX7R7BB104 | 0402 100nF ±10% 16V X7R | TOP | 75.172 | 78.64 | 0.0 | U_RF_circuit
C101 | 100 pF | 0402_Z | C1546 | 国巨(Yageo)/风华高科 | CC0402JRNPO9BN101 | 0402 100pF ±5% 50V C0G | TOP | 77.594 | 110.741 | 90.0 | U_RF_circuit
C107 | 47pF | 0402_Z | C1548 | 国巨(Yageo)/风华高科 | CC0402JRNPO9BN470 | 0402 47pF ±5% 50V C0G | TOP | 48.685 | 120.78 | 180.0 | U_RF_circuit
C106 | 100pF | 0603_Z | C1546 | 国巨(Yageo)/风华高科 | CC0402JRNPO9BN101 | 0402 100pF ±5% 50V C0G | TOP | 42.382 | 119.126 | 270.0 | U_RF_circuit
C99 | NC | 0603_Z | C1525 | 国巨(Yageo)/风华高科 | CC0402KRX7RNC | 0402 NC ±10% X7R | TOP | 66.8 | 125.983 | 270.0 | U_RF_circuit
C98 | NC | 0603_Z | C1525 | 国巨(Yageo)/风华高科 | CC0402KRX7RNC | 0402 NC ±10% X7R | TOP | 65.385 | 125.983 | 270.0 | U_RF_circuit
C97 | 47pF | 0805_Z | C1548 | 国巨(Yageo)/风华高科 | CC0402JRNPO9BN470 | 0402 47pF ±5% 50V C0G | TOP | 69.733 | 125.824 | 90.0 | U_RF_circuit
C96 | NC | 0603_Z | C1525 | 国巨(Yageo)/风华高科 | CC0402KRX7RNC | 0402 NC ±10% X7R | TOP | 68.187 | 125.983 | 270.0 | U_RF_circuit
C95 | 47pF | 0603_Z | C1548 | 国巨(Yageo)/风华高科 | CC0402JRNPO9BN470 | 0402 47pF ±5% 50V C0G | TOP | 48.17 | 125.956 | 270.0 | U_RF_circuit
C94 | 100nF | 1210_Z | C1525 | 国巨(Yageo)/风华高科 | CC0402KRX7R7BB104 | 0402 100nF ±10% 16V X7R | TOP | 72.068 | 125.303 | 270.0 | U_RF_circuit
C92 | 10uF | 0805_Z | C19702 | 国巨(Yageo)/风华高科 | CC0603KRX5R6BB106 | 0603 10uF ±20% 10V X5R | TOP | 46.525 | 125.824 | 270.0 | U_RF_circuit
C178 | 100 pF | 0402_Z | C1546 | 国巨(Yageo)/风华高科 | CC0402JRNPO9BN101 | 0402 100pF ±5% 50V C0G | TOP | 60.797 | 108.509 | 270.0 | U_RF_circuit
C114 | NC | 0402_Z | C1525 | 国巨(Yageo)/风华高科 | CC0402KRX7RNC | 0402 NC ±10% X7R | TOP | 44.692 | 120.364 | 270.0 | U_RF_circuit
C111 | 10pF | 0402_Z | C1551 | 国巨(Yageo)/风华高科 | CC0402JRNPO9BN100 | 0402 10pF ±5% 50V C0G | TOP | 42.378 | 121.229 | 270.0 | U_RF_circuit
C77 | 68 pF | 0402_Z | C1546 | 国巨(Yageo)/风华高科 | CC0402JRNPO9BN68 pF | 0402 68 pF ±5% 50V C0G | TOP | 40.219 | 92.727 | 270.0 | U_FMRD1616E
C76 | 100nF | 0402_Z | C1525 | 国巨(Yageo)/风华高科 | CC0402KRX7R7BB104 | 0402 100nF ±10% 16V X7R | TOP | 39.316 | 92.726 | 270.0 | U_FMRD1616E
C75 | 10uF | 0603_Z | C19702 | 国巨(Yageo)/风华高科 | CC0603KRX5R6BB106 | 0603 10uF ±20% 10V X5R | TOP | 37.469 | 91.354 | 180.0 | U_FMRD1616E
C73 | 1uF | 0402_Z | C52923 | 国巨(Yageo)/风华高科 | CC0402KRX5R6BB105 | 0402 1uF ±10% 10V X5R | TOP | 40.203 | 87.802 | 90.0 | U_FMRD1616E
C72 | 68 pF | 0402_Z | C1546 | 国巨(Yageo)/风华高科 | CC0402JRNPO9BN68 pF | 0402 68 pF ±5% 50V C0G | TOP | 40.219 | 94.248 | 270.0 | U_FMRD1616E
C71 | 100nF | 0402_Z | C1525 | 国巨(Yageo)/风华高科 | CC0402KRX7R7BB104 | 0402 100nF ±10% 16V X7R | TOP | 39.316 | 94.248 | 270.0 | U_FMRD1616E
C70 | 10uF | 0603_Z | C19702 | 国巨(Yageo)/风华高科 | CC0603KRX5R6BB106 | 0603 10uF ±20% 10V X5R | TOP | 37.5 | 95.814 | 180.0 | U_FMRD1616E
C65 | 1uF | 0402_Z | C52923 | 国巨(Yageo)/风华高科 | CC0402KRX5R6BB105 | 0402 1uF ±10% 10V X5R | TOP | 41.565 | 85.374 | 90.0 | U_FMRD1616E
C64 | 100 pF | 0402_Z | C1546 | 国巨(Yageo)/风华高科 | CC0402JRNPO9BN101 | 0402 100pF ±5% 50V C0G | TOP | 39.848 | 95.445 | 0.0 | U_FMRD1616E
C63 | 1 nF | 0402_Z | C1532 | 国巨(Yageo)/风华高科 | CC0402KRX7R9BB102 | 0402 1nF ±10% 50V X7R | TOP | 39.869 | 97.202 | 180.0 | U_FMRD1616E
C62 | 100 nF | 0402_Z | C1525 | 国巨(Yageo)/风华高科 | CC0402KRX7R7BB104 | 0402 100nF ±10% 16V X7R | TOP | 39.869 | 98.098 | 180.0 | U_FMRD1616E
C61 | 10uF | 0603_Z | C19702 | 国巨(Yageo)/风华高科 | CC0603KRX5R6BB106 | 0603 10uF ±20% 10V X5R | TOP | 39.383 | 99.302 | 180.0 | U_FMRD1616E
C60 | 33 pF | 0402_Z | C1546 | 国巨(Yageo)/风华高科 | CC0402JRNPO9BN33 pF | 0402 33 pF ±5% 50V C0G | TOP | 44.277 | 99.203 | 270.0 | U_FMRD1616E
C59 | 33 pF | 0402_Z | C1546 | 国巨(Yageo)/风华高科 | CC0402JRNPO9BN33 pF | 0402 33 pF ±5% 50V C0G | TOP | 41.77 | 99.185 | 90.0 | U_FMRD1616E
C58 | 68pF | 0402_Z | C1546 | 国巨(Yageo)/风华高科 | CC0402JRNPO9BN68pF | 0402 68pF ±5% 50V C0G | TOP | 39.851 | 96.318 | 0.0 | U_FMRD1616E
C57 | 33 pF | 0402_Z | C1546 | 国巨(Yageo)/风华高科 | CC0402JRNPO9BN33 pF | 0402 33 pF ±5% 50V C0G | TOP | 42.578 | 97.682 | 270.0 | U_FMRD1616E
C56 | 12 pF | 0402_Z | C1546 | 国巨(Yageo)/风华高科 | CC0402JRNPO9BN12 pF | 0402 12 pF ±5% 50V C0G | TOP | 42.963 | 100.456 | 0.0 | U_FMRD1616E
C55 | 33 pF | 0402_Z | C1546 | 国巨(Yageo)/风华高科 | CC0402JRNPO9BN33 pF | 0402 33 pF ±5% 50V C0G | TOP | 43.433 | 97.7 | 270.0 | U_FMRD1616E
C54 | 100nF | 0402_Z | C1525 | 国巨(Yageo)/风华高科 | CC0402KRX7R7BB104 | 0402 100nF ±10% 16V X7R | TOP | 45.678 | 97.326 | 0.0 | U_FMRD1616E
C53 | 100nF | 0402_Z | C1525 | 国巨(Yageo)/风华高科 | CC0402KRX7R7BB104 | 0402 100nF ±10% 16V X7R | TOP | 45.676 | 98.228 | 0.0 | U_FMRD1616E
C52 | 10 pF | 0402_Z | C1551 | 国巨(Yageo)/风华高科 | CC0402JRNPO9BN100 | 0402 10pF ±5% 50V C0G | TOP | 47.663 | 97.326 | 0.0 | U_FMRD1616E
C51 | 68pF | 0402_Z | C1546 | 国巨(Yageo)/风华高科 | CC0402JRNPO9BN68pF | 0402 68pF ±5% 50V C0G | TOP | 47.663 | 98.228 | 0.0 | U_FMRD1616E
C50 | 1uF | 0402_Z | C52923 | 国巨(Yageo)/风华高科 | CC0402KRX5R6BB105 | 0402 1uF ±10% 10V X5R | TOP | 47.663 | 99.125 | 0.0 | U_FMRD1616E
C49 | 100nF | 0402_Z | C1525 | 国巨(Yageo)/风华高科 | CC0402KRX7R7BB104 | 0402 100nF ±10% 16V X7R | TOP | 47.738 | 85.729 | 180.0 | U_FMRD1616E
C46 | 100nF | 0402_Z | C1525 | 国巨(Yageo)/风华高科 | CC0402KRX7R7BB104 | 0402 100nF ±10% 16V X7R | TOP | 49.465 | 97.326 | 0.0 | U_FMRD1616E
C45 | 100nF | 0402_Z | C1525 | 国巨(Yageo)/风华高科 | CC0402KRX7R7BB104 | 0402 100nF ±10% 16V X7R | TOP | 49.465 | 98.224 | 0.0 | U_FMRD1616E
C43 | 1 uF | 0402_Z | C52923 | 国巨(Yageo)/风华高科 | CC0402KRX5R6BB105 | 0402 1uF ±10% 10V X5R | TOP | 50.153 | 85.741 | 0.0 | U_FMRD1616E
C39 | 1 nF | 0402_Z | C1532 | 国巨(Yageo)/风华高科 | CC0402KRX7R9BB102 | 0402 1nF ±10% 50V X7R | TOP | 52.159 | 92.049 | 180.0 | U_FMRD1616E
C35 | 100pF | 0402_Z | C1546 | 国巨(Yageo)/风华高科 | CC0402JRNPO9BN101 | 0402 100pF ±5% 50V C0G | TOP | 57.4 | 93.0 | 180.0 | U_FMRD1616E
C34 | 1 nF | 0402_Z | C1532 | 国巨(Yageo)/风华高科 | CC0402KRX7R9BB102 | 0402 1nF ±10% 50V X7R | TOP | 52.165 | 92.856 | 180.0 | U_FMRD1616E
C33 | 10 pF | 0402_Z | C1551 | 国巨(Yageo)/风华高科 | CC0402JRNPO9BN100 | 0402 10pF ±5% 50V C0G | TOP | 54.382 | 94.276 | 0.0 | U_FMRD1616E
C32 | 68pF | 0402_Z | C1546 | 国巨(Yageo)/风华高科 | CC0402JRNPO9BN68pF | 0402 68pF ±5% 50V C0G | TOP | 54.382 | 95.178 | 0.0 | U_FMRD1616E
C31 | 1uF | 0402_Z | C52923 | 国巨(Yageo)/风华高科 | CC0402KRX5R6BB105 | 0402 1uF ±10% 10V X5R | TOP | 54.382 | 96.077 | 0.0 | U_FMRD1616E
C26 | 10uF | 0603_Z | C19702 | 国巨(Yageo)/风华高科 | CC0603KRX5R6BB106 | 0603 10uF ±20% 10V X5R | TOP | 53.673 | 87.902 | 0.0 | U_FMRD1616E
C25 | 68pF | 0402_Z | C1546 | 国巨(Yageo)/风华高科 | CC0402JRNPO9BN68pF | 0402 68pF ±5% 50V C0G | TOP | 51.867 | 87.774 | 270.0 | U_FMRD1616E
C22 | NC | 0402_Z | C1525 | 国巨(Yageo)/风华高科 | CC0402KRX7RNC | 0402 NC ±10% X7R | TOP | 52.275 | 96.799 | 0.0 | U_FMRD1616E
C21 | 1.8pF | 0402_Z | C1546 | 国巨(Yageo)/风华高科 | CC0402JRNPO9BN1.8pF | 0402 1.8pF ±5% 50V C0G | TOP | 52.275 | 94.286 | 0.0 | U_FMRD1616E
C17 | 10uF | 0603_Z | C19702 | 国巨(Yageo)/风华高科 | CC0603KRX5R6BB106 | 0603 10uF ±20% 10V X5R | TOP | 58.054 | 86.829 | 0.0 | U_FMRD1616E
C16 | 22nF | 0402_Z | C1525 | 国巨(Yageo)/风华高科 | CC0402KRX7R22nF | 0402 22nF ±10% X7R | TOP | 53.807 | 89.031 | 180.0 | U_FMRD1616E
C15 | 1nF | 0402_Z | C1532 | 国巨(Yageo)/风华高科 | CC0402KRX7R9BB102 | 0402 1nF ±10% 50V X7R | TOP | 53.076 | 89.909 | 180.0 | U_FMRD1616E
C14 | 1nF | 0402_Z | C1532 | 国巨(Yageo)/风华高科 | CC0402KRX7R9BB102 | 0402 1nF ±10% 50V X7R | TOP | 53.076 | 90.715 | 180.0 | U_FMRD1616E
C13 | 68pF | 0402_Z | C1546 | 国巨(Yageo)/风华高科 | CC0402JRNPO9BN68pF | 0402 68pF ±5% 50V C0G | TOP | 54.327 | 90.375 | 270.0 | U_FMRD1616E
C12 | 100nF | 0402_Z | C1525 | 国巨(Yageo)/风华高科 | CC0402KRX7R7BB104 | 0402 100nF ±10% 16V X7R | TOP | 55.221 | 90.367 | 270.0 | U_FMRD1616E
C11 | 1uF | 0402_Z | C52923 | 国巨(Yageo)/风华高科 | CC0402KRX5R6BB105 | 0402 1uF ±10% 10V X5R | TOP | 56.125 | 90.367 | 270.0 | U_FMRD1616E
C10 | 10uF | 0402_Z | C19702 | 国巨(Yageo)/风华高科 | CC0603KRX5R6BB106 | 0603 10uF ±20% 10V X5R | TOP | 55.769 | 89.096 | 180.0 | U_FMRD1616E
C9 | 100uF | 0805_Z | C52923 | 国巨(Yageo)/风华高科 | CC0402KRX5R100uF | 0402 100uF ±10% 贴片电容 | TOP | 58.315 | 88.415 | 180.0 | U_FMRD1616E
C8 | 100uF | 0805_Z | C52923 | 国巨(Yageo)/风华高科 | CC0402KRX5R100uF | 0402 100uF ±10% 贴片电容 | TOP | 58.315 | 90.135 | 180.0 | U_FMRD1616E
C7 | 20pF NP0 | 0402_Z | C1546 | 国巨(Yageo)/风华高科 | CC0402JRNPO9BN20pF NP0 | 0402 20pF NP0 ±5% 50V C0G | TOP | 40.776 | 73.995 | 270.0 | U_MCU
C6 | 20pF NP0 | 0402_Z | C1546 | 国巨(Yageo)/风华高科 | CC0402JRNPO9BN20pF NP0 | 0402 20pF NP0 ±5% 50V C0G | TOP | 42.75 | 71.481 | 0.0 | U_MCU
C5 | 0.1uF | 0402_Z | C52923 | 国巨(Yageo)/风华高科 | CC0402KRX5R6BB105 | 0402 1uF ±10% 10V X5R | TOP | 47.049 | 77.189 | 180.0 | U_MCU
C4 | 0.1uF | 0402_Z | C52923 | 国巨(Yageo)/风华高科 | CC0402KRX5R6BB105 | 0402 1uF ±10% 10V X5R | TOP | 40.583 | 75.614 | 270.0 | U_MCU
C3 | 100nF | 0402_Z | C1525 | 国巨(Yageo)/风华高科 | CC0402KRX7R7BB104 | 0402 100nF ±10% 16V X7R | TOP | 38.929 | 79.317 | 180.0 | U_MCU
C2 | 100nF | 0402_Z | C1525 | 国巨(Yageo)/风华高科 | CC0402KRX7R7BB104 | 0402 100nF ±10% 16V X7R | TOP | 46.655 | 81.506 | 270.0 | U_MCU
C1 | 100nF | 0402_Z | C1525 | 国巨(Yageo)/风华高科 | CC0402KRX7R7BB104 | 0402 100nF ±10% 16V X7R | TOP | 43.928 | 75.605 | 180.0 | U_MCU
C188 | 10uF | 0805_Z | C19702 | 国巨(Yageo)/风华高科 | CC0603KRX5R6BB106 | 0603 10uF ±20% 10V X5R | TOP | 39.621 | 117.031 | 270.0 | U_Power_Sch
C187 | 22uF | 0805_Z | C19703 | 国巨(Yageo)/风华高科 | CC0805KRX5R6BB226 | 0805 22uF ±20% 10V X5R | TOP | 37.989 | 117.031 | 270.0 | U_Power_Sch
C186 | 100nF | 0402_Z | C1525 | 国巨(Yageo)/风华高科 | CC0402KRX7R7BB104 | 0402 100nF ±10% 16V X7R | TOP | 33.668 | 120.248 | 180.0 | U_Power_Sch
