lyy622516-web/basestation/07_物料映射与走线数据/pcb_net_summary.csv

Net_Name | Net_Class | Segment_Count | Total_Length_mil | Total_Length_mm | Layers | Widths_mil
LDO_PWR | POWER_SUPPLY | 105 | 7227.7 | 183.58 | L1_Top_Layer; L3_Signal1_Power; L5_Signal3_Analog | 7.9; 9.8; 11.8; 15.7
DC_5V | POWER_SUPPLY | 35 | 4292.3 | 109.02 | L1_Top_Layer; L3_Signal1_Power | 7.9; 11.8; 15.7
ADP_IN | POWER_SUPPLY | 13 | 4168.7 | 105.89 | L1_Top_Layer; L3_Signal1_Power | 15.7; 19.7
V4_MCU | GENERAL_SIGNAL | 22 | 3788.4 | 96.23 | L1_Top_Layer; L3_Signal1_Power; L5_Signal3_Analog | 3.9
GND | GROUND | 66 | 3645.0 | 92.58 | L1_Top_Layer; L3_Signal1_Power | 3.9; 7.9; 9.8; 11.0; 11.8; 15.7
LO_LNA_5V | POWER_SUPPLY | 36 | 2968.6 | 75.4 | L1_Top_Layer; L3_Signal1_Power; L4_Signal2_Digital | 5.9; 7.9
VCC_+3.3 V | POWER_SUPPLY | 52 | 2913.5 | 74.0 | L1_Top_Layer; L3_Signal1_Power | 5.9; 7.9; 9.8; 11.8
AMP_IP | DIFF_PAIRS | 30 | 2748.2 | 69.8 | L1_Top_Layer; L5_Signal3_Analog | 5.9
AMP_IN | DIFF_PAIRS | 24 | 2735.6 | 69.48 | L1_Top_Layer; L5_Signal3_Analog | 5.9
LNA_5V | POWER_SUPPLY | 54 | 2711.1 | 68.86 | L1_Top_Layer; L3_Signal1_Power | 7.9; 9.8; 11.8
TX_EN | GENERAL_SIGNAL | 23 | 2626.2 | 66.7 | L1_Top_Layer; L5_Signal3_Analog | 3.9
NetC23_1 | GENERAL_SIGNAL | 20 | 2546.1 | 64.67 | L1_Top_Layer; L5_Signal3_Analog | 5.9
PE1 | GENERAL_SIGNAL | 23 | 2519.2 | 63.99 | L1_Top_Layer; L3_Signal1_Power; L4_Signal2_Digital | 3.9
ATTN1_D0 | DATA_BUS | 30 | 2457.3 | 62.42 | L1_Top_Layer; L4_Signal2_Digital | 3.9
NetC19_2 | GENERAL_SIGNAL | 25 | 2409.9 | 61.21 | L1_Top_Layer; L5_Signal3_Analog | 5.9
VCC_+1.8 V | POWER_SUPPLY | 35 | 2387.9 | 60.65 | L1_Top_Layer; L3_Signal1_Power | 7.9; 11.8
ATTN1_D1 | DATA_BUS | 32 | 2257.3 | 57.34 | L1_Top_Layer; L4_Signal2_Digital | 3.9
ATTN1_D2 | DATA_BUS | 30 | 2160.8 | 54.89 | L1_Top_Layer; L4_Signal2_Digital | 3.9
VCC_SGM_SPDT | POWER_SUPPLY | 32 | 2155.8 | 54.76 | L1_Top_Layer; L3_Signal1_Power | 5.9
NetU1_9 | GENERAL_SIGNAL | 13 | 2146.5 | 54.52 | L1_Top_Layer; L4_Signal2_Digital | 3.9
ATTN1_D4 | DATA_BUS | 31 | 2106.3 | 53.5 | L1_Top_Layer; L4_Signal2_Digital | 3.9
ATTN1_D3 | DATA_BUS | 30 | 2083.0 | 52.91 | L1_Top_Layer; L4_Signal2_Digital | 3.9
MCU_3V3 | POWER_SUPPLY | 32 | 2073.4 | 52.66 | L1_Top_Layer; L3_Signal1_Power | 5.9; 7.9
ATTN1_D6 | DATA_BUS | 24 | 2018.7 | 51.27 | L1_Top_Layer; L4_Signal2_Digital | 3.9
ATTN1_D5 | DATA_BUS | 32 | 2003.4 | 50.89 | L1_Top_Layer; L4_Signal2_Digital | 3.9
PA13 | DATA_BUS | 22 | 1931.4 | 49.06 | L1_Top_Layer; L4_Signal2_Digital; L5_Signal3_Analog | 3.9
PA14 | DATA_BUS | 11 | 1926.7 | 48.94 | L1_Top_Layer; L4_Signal2_Digital; L5_Signal3_Analog | 3.9
AMP_QN | DIFF_PAIRS | 15 | 1755.2 | 44.58 | L1_Top_Layer; L4_Signal2_Digital; L5_Signal3_Analog | 5.9
NetR2_2 | GENERAL_SIGNAL | 9 | 1704.3 | 43.29 | L1_Top_Layer; L4_Signal2_Digital | 3.9
NetC79_1 | GENERAL_SIGNAL | 7 | 1660.3 | 42.17 | L1_Top_Layer; L3_Signal1_Power | 7.9
NetC41_1 | GENERAL_SIGNAL | 18 | 1629.8 | 41.4 | L1_Top_Layer; L5_Signal3_Analog | 5.9
SWCLK | DATA_BUS | 11 | 1467.8 | 37.28 | L1_Top_Layer; L5_Signal3_Analog | 3.9
SWDIO | DATA_BUS | 11 | 1466.2 | 37.24 | L1_Top_Layer; L5_Signal3_Analog | 3.9
NetR1_1 | GENERAL_SIGNAL | 9 | 1445.3 | 36.71 | L1_Top_Layer; L4_Signal2_Digital | 3.9
AMP_QP | DIFF_PAIRS | 28 | 1422.8 | 36.14 | L1_Top_Layer; L5_Signal3_Analog | 5.9
PA15 | GENERAL_SIGNAL | 14 | 1385.8 | 35.2 | L1_Top_Layer; L4_Signal2_Digital | 5.9
PE5 | GENERAL_SIGNAL | 16 | 1381.1 | 35.08 | L1_Top_Layer; L4_Signal2_Digital | 3.9
SPI_SCLK | DATA_BUS | 11 | 1365.5 | 34.68 | L1_Top_Layer; L5_Signal3_Analog | 3.9
SPI_SDO | DATA_BUS | 11 | 1354.6 | 34.41 | L1_Top_Layer; L5_Signal3_Analog | 3.9
SPI_CS | DATA_BUS | 18 | 1255.9 | 31.9 | L1_Top_Layer; L5_Signal3_Analog | 3.9
SPI_SDI | DATA_BUS | 10 | 1250.8 | 31.77 | L1_Top_Layer; L5_Signal3_Analog | 3.9
NetD1_1 | GENERAL_SIGNAL | 15 | 1229.2 | 31.22 | L1_Top_Layer; L3_Signal1_Power | 5.9
NetC89_2 | GENERAL_SIGNAL | 28 | 1188.7 | 30.19 | L1_Top_Layer; L3_Signal1_Power | 11.8
NetC37_2 | GENERAL_SIGNAL | 27 | 1056.0 | 26.82 | L1_Top_Layer; L5_Signal3_Analog | 5.9
LE_A1 | DATA_BUS | 13 | 1006.5 | 25.57 | L1_Top_Layer; L3_Signal1_Power | 3.9
PC7 | GENERAL_SIGNAL | 6 | 943.4 | 23.96 | L1_Top_Layer; L4_Signal2_Digital | 3.9
NetC207_1 | GENERAL_SIGNAL | 11 | 941.8 | 23.92 | L1_Top_Layer; L3_Signal1_Power | 5.9; 7.9
PC8 | GENERAL_SIGNAL | 7 | 916.9 | 23.29 | L1_Top_Layer; L4_Signal2_Digital | 3.9
PC9 | GENERAL_SIGNAL | 8 | 908.6 | 23.08 | L1_Top_Layer; L4_Signal2_Digital | 3.9
VDD_DPDT | POWER_SUPPLY | 19 | 903.9 | 22.96 | L1_Top_Layer; L3_Signal1_Power | 9.8; 11.8; 15.7
VDD | POWER_SUPPLY | 28 | 839.0 | 21.31 | L1_Top_Layer | 5.9
PA0 | GENERAL_SIGNAL | 12 | 820.0 | 20.83 | L1_Top_Layer | 3.9; 5.9
PF1/RX0 | DATA_BUS | 7 | 715.6 | 18.17 | L1_Top_Layer; L4_Signal2_Digital | 3.9
V4 | GENERAL_SIGNAL | 18 | 637.3 | 16.19 | L1_Top_Layer; L5_Signal3_Analog | 3.9
NetC178_2 | GENERAL_SIGNAL | 1 | 620.7 | 15.77 | L1_Top_Layer | 13.9
PB3 | GENERAL_SIGNAL | 12 | 616.7 | 15.66 | L1_Top_Layer; L4_Signal2_Digital | 5.9; 7.9
PF0/TX0 | DATA_BUS | 6 | 616.2 | 15.65 | L1_Top_Layer; L4_Signal2_Digital | 3.9
NetC183_1 | GENERAL_SIGNAL | 1 | 608.4 | 15.45 | L1_Top_Layer | 13.9
NetP5_5 | GENERAL_SIGNAL | 9 | 599.2 | 15.22 | L1_Top_Layer; L3_Signal1_Power | 4.8; 13.9
LE_A2 | DATA_BUS | 10 | 558.3 | 14.18 | L1_Top_Layer; L4_Signal2_Digital | 3.9
NetC58_1 | GENERAL_SIGNAL | 29 | 537.1 | 13.64 | L1_Top_Layer | 5.9; 7.9
NetC124_2 | GENERAL_SIGNAL | 4 | 527.7 | 13.4 | L1_Top_Layer; L3_Signal1_Power | 4.8; 5.9
NetC121_1 | GENERAL_SIGNAL | 4 | 522.8 | 13.28 | L1_Top_Layer | 13.9
NetC120_1 | GENERAL_SIGNAL | 4 | 519.9 | 13.2 | L1_Top_Layer | 13.9
TCXO_EN | GENERAL_SIGNAL | 9 | 490.5 | 12.46 | L1_Top_Layer; L3_Signal1_Power | 3.9
NetC10_2 | GENERAL_SIGNAL | 25 | 485.1 | 12.32 | L1_Top_Layer | 5.9
NetC160_2 | GENERAL_SIGNAL | 1 | 467.0 | 11.86 | L1_Top_Layer | 13.9
NetC176_1 | GENERAL_SIGNAL | 2 | 378.5 | 9.61 | L1_Top_Layer | 13.9
NetC181_1 | GENERAL_SIGNAL | 9 | 356.0 | 9.04 | L1_Top_Layer; L3_Signal1_Power | 4.8; 9.4; 11.0
V1_DPDT | RF_50OHM | 6 | 351.0 | 8.92 | L1_Top_Layer; L4_Signal2_Digital | 7.9
NetC8_1 | GENERAL_SIGNAL | 16 | 337.5 | 8.57 | L1_Top_Layer | 7.9
NIRQ0 | GENERAL_SIGNAL | 8 | 318.9 | 8.1 | L1_Top_Layer; L3_Signal1_Power | 3.9
NetC31_2 | GENERAL_SIGNAL | 15 | 300.0 | 7.62 | L1_Top_Layer; L3_Signal1_Power | 9.1
NetC134_2 | GENERAL_SIGNAL | 6 | 277.2 | 7.04 | L1_Top_Layer | 5.9
NetC94_1 | GENERAL_SIGNAL | 2 | 273.6 | 6.95 | L1_Top_Layer | 20.9
NetC28_1 | GENERAL_SIGNAL | 5 | 237.9 | 6.04 | L1_Top_Layer | 5.9
OSC_OUT | GENERAL_SIGNAL | 6 | 237.0 | 6.02 | L1_Top_Layer | 5.9
NetC169_2 | GENERAL_SIGNAL | 15 | 235.7 | 5.99 | L1_Top_Layer | 7.9
NetC88_2 | GENERAL_SIGNAL | 18 | 234.7 | 5.96 | L1_Top_Layer | 11.8
NetC141_2 | GENERAL_SIGNAL | 22 | 233.5 | 5.93 | L1_Top_Layer | 7.9
NetC20_1 | GENERAL_SIGNAL | 6 | 232.1 | 5.9 | L1_Top_Layer | 5.9
NetC38_1 | GENERAL_SIGNAL | 7 | 230.2 | 5.85 | L1_Top_Layer | 5.9
NetC25_2 | GENERAL_SIGNAL | 9 | 227.6 | 5.78 | L1_Top_Layer | 5.9
NetC83_2 | GENERAL_SIGNAL | 24 | 226.4 | 5.75 | L1_Top_Layer | 7.9
NetC40_1 | GENERAL_SIGNAL | 7 | 216.9 | 5.51 | L1_Top_Layer | 5.9
NetC66_2 | GENERAL_SIGNAL | 17 | 211.0 | 5.36 | L1_Top_Layer | 7.9
NetC50_2 | GENERAL_SIGNAL | 13 | 209.3 | 5.32 | L1_Top_Layer | 5.9
NetC75_2 | GENERAL_SIGNAL | 12 | 203.4 | 5.17 | L1_Top_Layer | 7.9
NetC142_2 | GENERAL_SIGNAL | 15 | 203.4 | 5.17 | L1_Top_Layer | 7.9
GD_OSC_IN | GENERAL_SIGNAL | 7 | 202.4 | 5.14 | L1_Top_Layer | 5.9
V_DPDT | RF_50OHM | 6 | 195.9 | 4.97 | L1_Top_Layer | 11.8
NetC70_2 | GENERAL_SIGNAL | 11 | 184.1 | 4.68 | L1_Top_Layer | 7.9
RX2 | RF_50OHM | 1 | 181.0 | 4.6 | L1_Top_Layer | 13.9
NetR12_2 | GENERAL_SIGNAL | 7 | 174.6 | 4.44 | L1_Top_Layer | 3.9
NRST | GENERAL_SIGNAL | 7 | 170.6 | 4.33 | L1_Top_Layer; L3_Signal1_Power | 3.9
NetC80_1 | GENERAL_SIGNAL | 9 | 164.6 | 4.18 | L1_Top_Layer | 7.9
NetRX1_1 | GENERAL_SIGNAL | 8 | 164.2 | 4.17 | L1_Top_Layer | 7.9
OSC_IN | GENERAL_SIGNAL | 5 | 161.7 | 4.11 | L1_Top_Layer | 5.9
MIX_QP | DIFF_PAIRS | 4 | 161.1 | 4.09 | L1_Top_Layer | 5.9
NetC81_2 | GENERAL_SIGNAL | 7 | 159.1 | 4.04 | L1_Top_Layer | 7.9
GD32_VDDA | POWER_SUPPLY | 6 | 156.9 | 3.99 | L1_Top_Layer | 7.9
NetC27_1 | GENERAL_SIGNAL | 3 | 154.3 | 3.92 | L1_Top_Layer | 5.9
MIX_IN | DIFF_PAIRS | 6 | 149.2 | 3.79 | L1_Top_Layer | 5.9
MIX_IP | DIFF_PAIRS | 12 | 145.6 | 3.7 | L1_Top_Layer | 5.9
NetR48_2 | GENERAL_SIGNAL | 3 | 144.3 | 3.66 | L1_Top_Layer | 13.9
NetC18_1 | GENERAL_SIGNAL | 4 | 143.6 | 3.65 | L1_Top_Layer | 5.9
TCXO_IN | RF_50OHM | 11 | 142.8 | 3.63 | L1_Top_Layer | 7.9
NetC65_1 | GENERAL_SIGNAL | 5 | 142.4 | 3.62 | L1_Top_Layer | 7.9
VDDA | POWER_SUPPLY | 6 | 135.6 | 3.44 | L1_Top_Layer | 7.9
QSPI_D0 | DATA_BUS | 3 | 134.4 | 3.41 | L1_Top_Layer | 3.9
QSPI_SSN | DATA_BUS | 3 | 134.2 | 3.41 | L1_Top_Layer | 3.9
QSPI_D2 | DATA_BUS | 2 | 133.9 | 3.4 | L1_Top_Layer | 3.9
MIX_QN | DIFF_PAIRS | 5 | 133.0 | 3.38 | L1_Top_Layer | 5.9
NetC179_2 | GENERAL_SIGNAL | 1 | 132.9 | 3.37 | L1_Top_Layer | 13.9
NetC137_1 | GENERAL_SIGNAL | 10 | 130.0 | 3.3 | L1_Top_Layer | 7.9
NetC157_1 | GENERAL_SIGNAL | 3 | 129.3 | 3.28 | L1_Top_Layer; L3_Signal1_Power | 4.8; 9.1
NetC15_1 | GENERAL_SIGNAL | 5 | 127.9 | 3.25 | L1_Top_Layer | 5.9
NetC168_1 | GENERAL_SIGNAL | 5 | 127.9 | 3.25 | L1_Top_Layer | 7.9
TCXO | RF_50OHM | 8 | 127.3 | 3.23 | L1_Top_Layer | 7.9
NetC35_1 | GENERAL_SIGNAL | 3 | 127.1 | 3.23 | L1_Top_Layer | 3.9; 13.9; 14.6
NetR13_2 | GENERAL_SIGNAL | 5 | 123.8 | 3.14 | L1_Top_Layer | 3.9
NetC136_1 | GENERAL_SIGNAL | 5 | 122.9 | 3.12 | L1_Top_Layer | 5.9
NetL19_2 | GENERAL_SIGNAL | 1 | 121.1 | 3.08 | L1_Top_Layer | 5.9
NetC87_1 | GENERAL_SIGNAL | 6 | 121.0 | 3.07 | L1_Top_Layer | 11.8
NetC140_2 | GENERAL_SIGNAL | 3 | 117.7 | 2.99 | L1_Top_Layer | 5.9
NetR46_2 | GENERAL_SIGNAL | 3 | 114.7 | 2.91 | L1_Top_Layer | 13.9
V4_INV | GENERAL_SIGNAL | 6 | 113.8 | 2.89 | L1_Top_Layer | 3.9
NetR5_2 | GENERAL_SIGNAL | 2 | 112.6 | 2.86 | L1_Top_Layer | 3.9
NetR7_2 | GENERAL_SIGNAL | 2 | 112.3 | 2.85 | L1_Top_Layer | 3.9
NetR9_2 | GENERAL_SIGNAL | 2 | 112.0 | 2.84 | L1_Top_Layer | 3.9
NetR36_1 | GENERAL_SIGNAL | 4 | 111.9 | 2.84 | L1_Top_Layer | 11.8
NetR11_2 | GENERAL_SIGNAL | 1 | 111.4 | 2.83 | L1_Top_Layer | 3.9
NetC151_2 | GENERAL_SIGNAL | 1 | 109.5 | 2.78 | L1_Top_Layer | 11.8
NetC73_1 | GENERAL_SIGNAL | 5 | 108.5 | 2.75 | L1_Top_Layer | 7.9
RD_RX_P | DIFF_PAIRS | 4 | 104.7 | 2.66 | L1_Top_Layer | 9.8; 13.9
NetC78_2 | GENERAL_SIGNAL | 5 | 103.4 | 2.63 | L1_Top_Layer | 11.8
NetC43_2 | GENERAL_SIGNAL | 6 | 101.6 | 2.58 | L1_Top_Layer | 7.9
GD_OSC_OUT | GENERAL_SIGNAL | 4 | 101.4 | 2.57 | L1_Top_Layer | 5.9
AGND | GENERAL_SIGNAL | 4 | 100.7 | 2.56 | L1_Top_Layer | 7.9
NetC49_2 | GENERAL_SIGNAL | 7 | 100.7 | 2.56 | L1_Top_Layer | 7.9
NetC14_1 | GENERAL_SIGNAL | 6 | 95.7 | 2.43 | L1_Top_Layer | 5.9
NetC44_1 | GENERAL_SIGNAL | 3 | 94.6 | 2.4 | L1_Top_Layer | 5.9
NetC36_1 | GENERAL_SIGNAL | 3 | 93.6 | 2.38 | L1_Top_Layer | 5.9
NetC55_1 | GENERAL_SIGNAL | 5 | 93.5 | 2.38 | L1_Top_Layer | 9.8
NetC186_2 | GENERAL_SIGNAL | 4 | 92.9 | 2.36 | L1_Top_Layer | 11.8
NetC92_2 | GENERAL_SIGNAL | 4 | 91.8 | 2.33 | L1_Top_Layer | 7.9; 15.7
V4_MCU_INV | GENERAL_SIGNAL | 2 | 91.0 | 2.31 | L1_Top_Layer | 3.9
NetC57_1 | GENERAL_SIGNAL | 3 | 88.1 | 2.24 | L1_Top_Layer | 9.8
NetC193_2 | GENERAL_SIGNAL | 5 | 85.3 | 2.17 | L1_Top_Layer | 11.8
NetC39_2 | GENERAL_SIGNAL | 4 | 80.7 | 2.05 | L1_Top_Layer | 9.8; 13.9
NetC34_2 | GENERAL_SIGNAL | 4 | 80.5 | 2.04 | L1_Top_Layer | 9.8; 13.9
RD_RX_N | DIFF_PAIRS | 4 | 80.3 | 2.04 | L1_Top_Layer | 9.8; 13.9
TCXO_VDD | POWER_SUPPLY | 1 | 78.9 | 2.0 | L1_Top_Layer | 7.9
QSPI_SCK | DATA_BUS | 4 | 74.1 | 1.88 | L1_Top_Layer | 3.9
PA3 | GENERAL_SIGNAL | 4 | 73.2 | 1.86 | L1_Top_Layer | 3.9
NetC180_1 | GENERAL_SIGNAL | 2 | 71.0 | 1.8 | L1_Top_Layer | 13.9
NetC56_2 | GENERAL_SIGNAL | 3 | 70.5 | 1.79 | L1_Top_Layer | 9.8; 13.9
QSPI_D3 | DATA_BUS | 3 | 70.0 | 1.78 | L1_Top_Layer | 3.9
NetC105_2 | GENERAL_SIGNAL | 4 | 69.9 | 1.78 | L1_Top_Layer | 11.8
NetC56_1 | GENERAL_SIGNAL | 3 | 69.8 | 1.77 | L1_Top_Layer | 7.9; 13.9
NetR11_1 | GENERAL_SIGNAL | 2 | 69.4 | 1.76 | L1_Top_Layer | 3.9
NetC104_1 | GENERAL_SIGNAL | 4 | 68.5 | 1.74 | L1_Top_Layer | 11.8
QSPI_D1 | DATA_BUS | 4 | 67.9 | 1.73 | L1_Top_Layer | 3.9
EX_CTL | GENERAL_SIGNAL | 3 | 66.9 | 1.7 | L1_Top_Layer | 11.8
NetC22_2 | GENERAL_SIGNAL | 3 | 65.7 | 1.67 | L1_Top_Layer | 13.9
NetC179_1 | GENERAL_SIGNAL | 1 | 65.0 | 1.65 | L1_Top_Layer | 13.9
NetR16_2 | GENERAL_SIGNAL | 3 | 63.9 | 1.62 | L1_Top_Layer | 11.8
NetC180_2 | GENERAL_SIGNAL | 2 | 63.8 | 1.62 | L1_Top_Layer | 13.9
NetC22_1 | GENERAL_SIGNAL | 2 | 63.3 | 1.61 | L1_Top_Layer | 13.9
NetC79_2 | GENERAL_SIGNAL | 4 | 59.4 | 1.51 | L1_Top_Layer | 7.9
NetL9_2 | GENERAL_SIGNAL | 1 | 57.7 | 1.47 | L1_Top_Layer | 5.9
NetC84_1 | GENERAL_SIGNAL | 2 | 55.5 | 1.41 | L1_Top_Layer | 7.9
LO_N | DIFF_PAIRS | 2 | 53.0 | 1.34 | L1_Top_Layer | 9.8
LO_P | DIFF_PAIRS | 2 | 52.1 | 1.32 | L1_Top_Layer | 9.8
NetR43_1 | GENERAL_SIGNAL | 2 | 51.6 | 1.31 | L1_Top_Layer | 3.9
NetR57_2 | GENERAL_SIGNAL | 2 | 50.6 | 1.28 | L1_Top_Layer | 5.9
NetR10_2 | GENERAL_SIGNAL | 2 | 48.7 | 1.24 | L1_Top_Layer | 3.9
NetR8_2 | GENERAL_SIGNAL | 2 | 48.7 | 1.24 | L1_Top_Layer | 3.9
NetR6_2 | GENERAL_SIGNAL | 2 | 48.6 | 1.24 | L1_Top_Layer | 3.9
PA5 | GENERAL_SIGNAL | 3 | 46.5 | 1.18 | L1_Top_Layer | 3.9
PA4 | GENERAL_SIGNAL | 2 | 46.3 | 1.18 | L1_Top_Layer | 3.9
NetC109_2 | GENERAL_SIGNAL | 1 | 45.2 | 1.15 | L1_Top_Layer | 13.9
NetC159_1 | GENERAL_SIGNAL | 2 | 39.0 | 0.99 | L1_Top_Layer | 15.7
NetR47_1 | GENERAL_SIGNAL | 3 | 38.8 | 0.99 | L1_Top_Layer | 7.9
NetC158_1 | GENERAL_SIGNAL | 2 | 38.3 | 0.97 | L1_Top_Layer | 11.8
LO1 | RF_50OHM | 2 | 37.5 | 0.95 | L1_Top_Layer | 11.8
NetC159_2 | GENERAL_SIGNAL | 3 | 37.0 | 0.94 | L1_Top_Layer | 11.8
NetC35_2 | GENERAL_SIGNAL | 1 | 36.2 | 0.92 | L1_Top_Layer | 13.9
NetR42_2 | GENERAL_SIGNAL | 2 | 35.6 | 0.9 | L1_Top_Layer | 11.8
NetC183_2 | GENERAL_SIGNAL | 2 | 33.8 | 0.86 | L1_Top_Layer | 7.9
NetC182_1 | GENERAL_SIGNAL | 2 | 33.7 | 0.86 | L1_Top_Layer | 7.9
NetC153_1 | GENERAL_SIGNAL | 2 | 33.6 | 0.85 | L1_Top_Layer | 7.9
NetC154_2 | GENERAL_SIGNAL | 1 | 29.6 | 0.75 | L1_Top_Layer | 7.9
NetC16_1 | GENERAL_SIGNAL | 2 | 29.1 | 0.74 | L1_Top_Layer | 5.9
NetC57_2 | GENERAL_SIGNAL | 2 | 26.5 | 0.67 | L1_Top_Layer | 9.8; 13.9
NetC55_2 | GENERAL_SIGNAL | 2 | 25.8 | 0.65 | L1_Top_Layer | 7.9; 13.9
NetC181_2 | GENERAL_SIGNAL | 1 | 21.3 | 0.54 | L1_Top_Layer | 13.9
NetC154_1 | GENERAL_SIGNAL | 1 | 3.3 | 0.08 | L1_Top_Layer | 9.1
