lyy622516-web/basestation/05_嘉立创EDA工程/UHF_Reader_MultiFuntion_V5/3D模型与结构腔体/装配体1.SLDASM

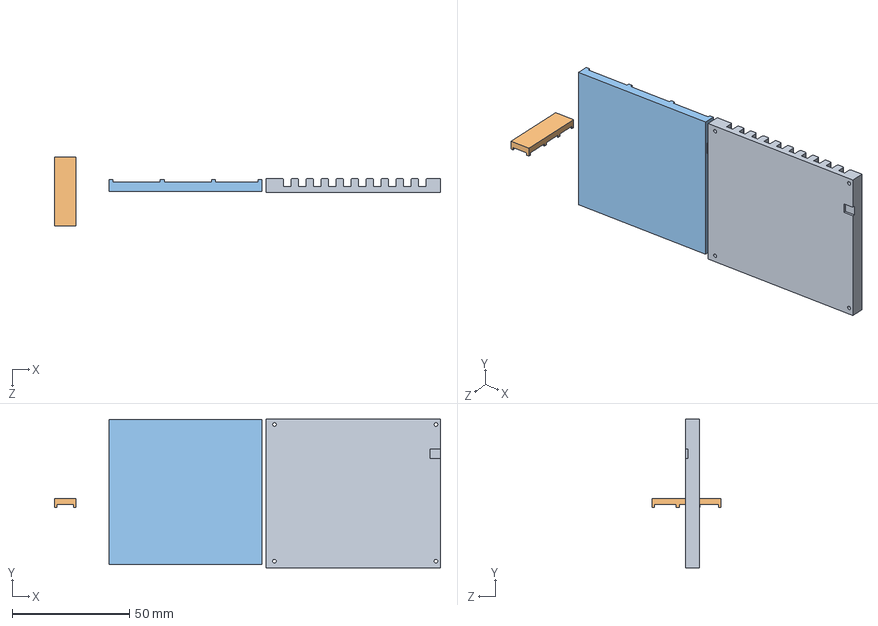
[picture p135: CAD file, 2026-11-07]
05_嘉立创EDA工程/UHF_Reader_MultiFuntion_V5/3D模型与结构腔体/装配体1.SLDASM
164.6 x 63.4 x 29.4 mm
端机腔体top
零件2
腔体bottom
