lyy622516-web/basestation/05_嘉立创EDA工程/UHF_Reader_MultiFuntion_V5/3D模型与结构腔体/零件1.SLDPRT

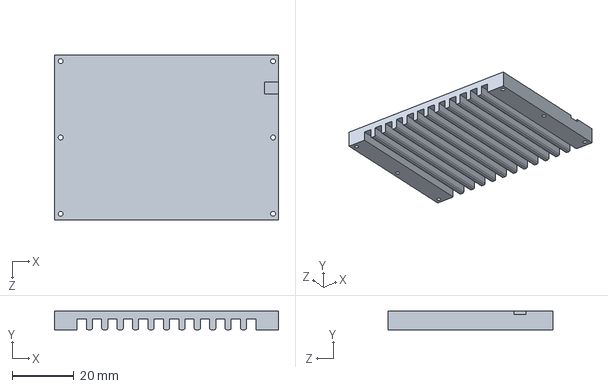
[picture p136: CAD file, 2026-11-07]
05_嘉立创EDA工程/UHF_Reader_MultiFuntion_V5/3D模型与结构腔体/零件1.SLDPRT
72.6 x 6.00 x 53.5 mm
