lyy622516-web/basestation/05_嘉立创EDA工程/UHF_Reader_MultiFuntion_V5/3D模型与结构腔体/零件2.SLDPRT

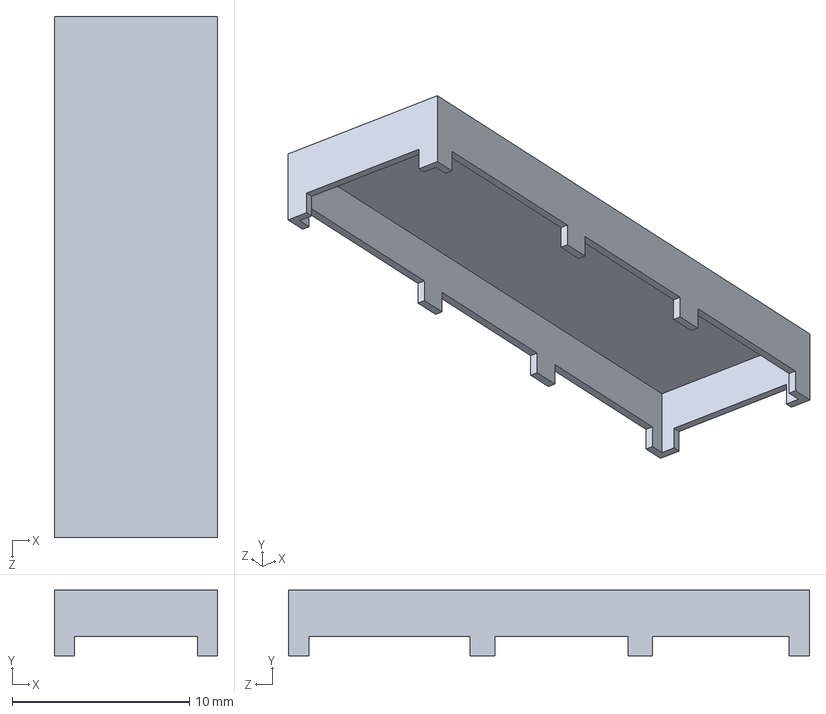
[picture p137: CAD file, 2026-11-07]
05_嘉立创EDA工程/UHF_Reader_MultiFuntion_V5/3D模型与结构腔体/零件2.SLDPRT
9.22 x 3.70 x 29.4 mm
