lyy622516-web/basestation/05_嘉立创EDA工程/UHF_Reader_MultiFuntion_V5/3D模型与结构腔体/UHF_Reader_MultiFunction_V3.step

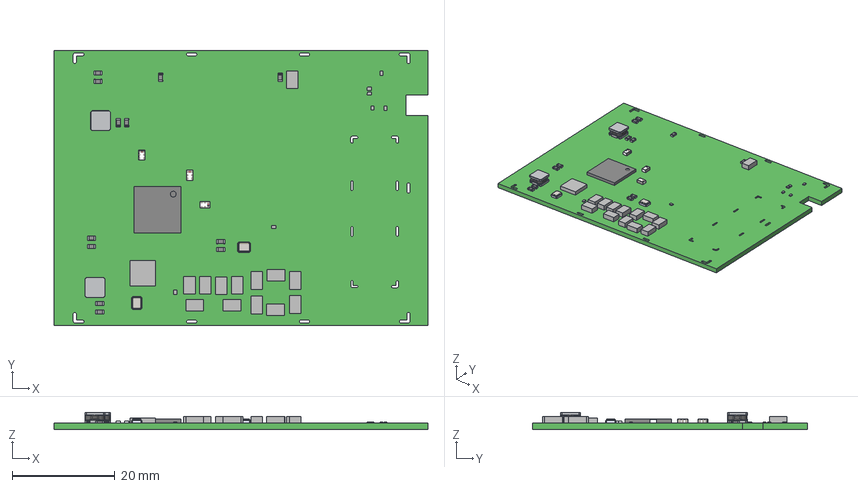
[picture p138: CAD file, 2026-11-07]
05_嘉立创EDA工程/UHF_Reader_MultiFuntion_V5/3D模型与结构腔体/UHF_Reader_MultiFunction_V3.step
72.6 x 53.5 x 3.33 mm
Extruded x 21
User Library-XTAL2520-4 x 2
SRN4026 Series x 2
L0603 x 12
Balun0805-2450FB15L0001 x 3
Thermal_Shape
