lyy622516-web/basestation/05_嘉立创EDA工程/UHF_Reader_MultiFuntion_V5/3D模型与结构腔体/零件3.SLDPRT

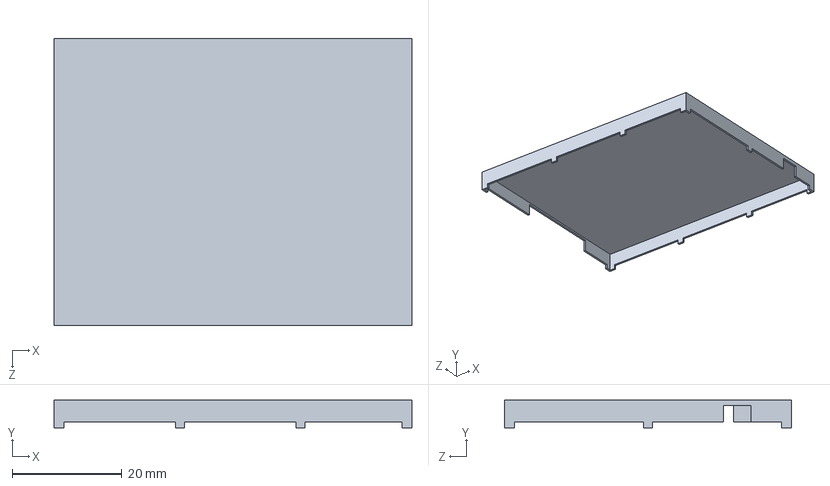
[picture p139: CAD file, 2026-11-07]
05_嘉立创EDA工程/UHF_Reader_MultiFuntion_V5/3D模型与结构腔体/零件3.SLDPRT
65.3 x 5.10 x 52.4 mm
