lyy622516-web/basestation/05_嘉立创EDA工程/UHF_Reader_MultiFuntion_V5/3D模型与结构腔体/腔体bottom.SLDPRT

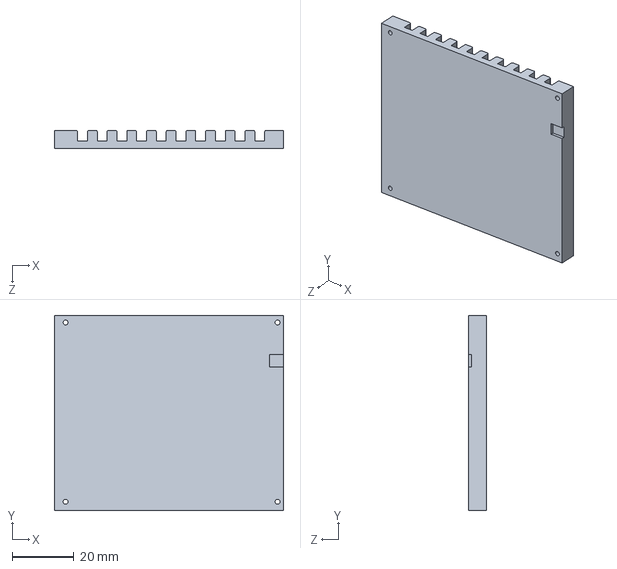
[picture p140: CAD file, 2026-11-07]
05_嘉立创EDA工程/UHF_Reader_MultiFuntion_V5/3D模型与结构腔体/腔体bottom.SLDPRT
74.4 x 63.4 x 6.00 mm
