lyy622516-web/basestation/05_嘉立创EDA工程/UHF_Reader_MultiFuntion_V5/3D模型与结构腔体/端机腔体top.SLDPRT

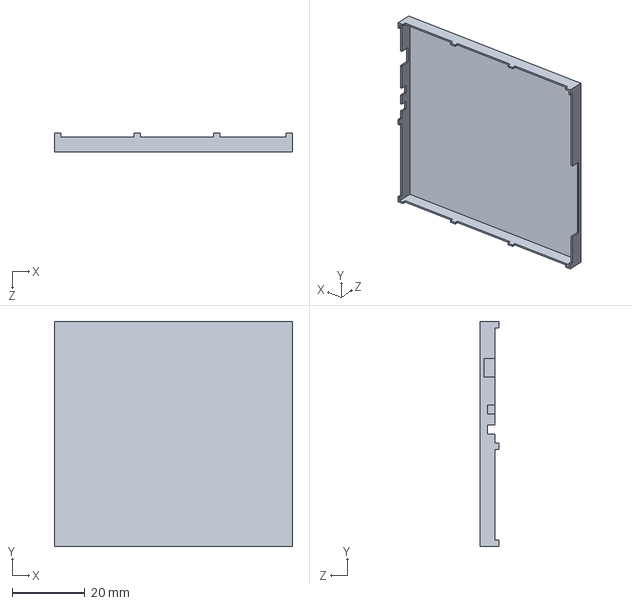
[picture p141: CAD file, 2026-11-07]
05_嘉立创EDA工程/UHF_Reader_MultiFuntion_V5/3D模型与结构腔体/端机腔体top.SLDPRT
65.3 x 61.9 x 5.10 mm
