lyy622516-web/basestation/05_嘉立创EDA工程/UHF_Reader_MultiFuntion_V5/3D模型与结构腔体/UHF_Reader_MultiFunction_V4_完整整板3D器件模型.step

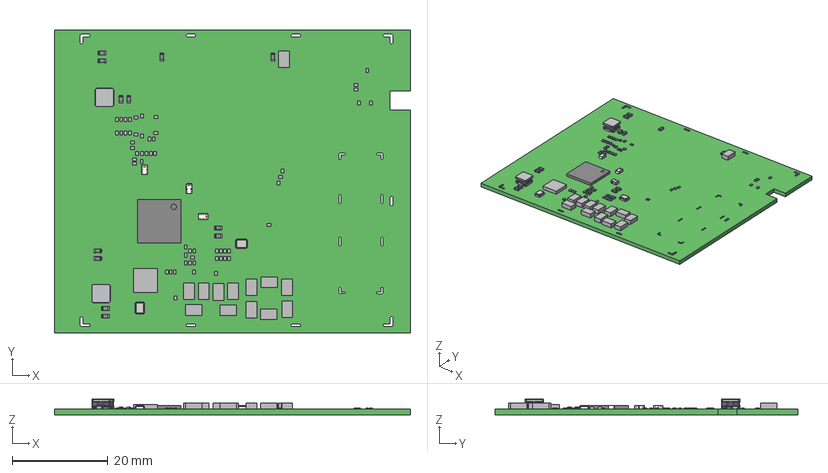
[picture p142: CAD file, 2026-11-06]
05_嘉立创EDA工程/UHF_Reader_MultiFuntion_V5/3D模型与结构腔体/UHF_Reader_MultiFunction_V4_完整整板3D器件模型.step
74.4 x 63.4 x 3.33 mm
Extruded x 71
User Library-XTAL2520-4 x 2
SRN4026 Series x 2
L0603 x 12
Balun0805-2450FB15L0001 x 3
Thermal_Shape
