lyy622516-web/basestation/05_嘉立创EDA工程/UHF_Reader_MultiFuntion_V5/3D模型与结构腔体/装配方案.SLDASM

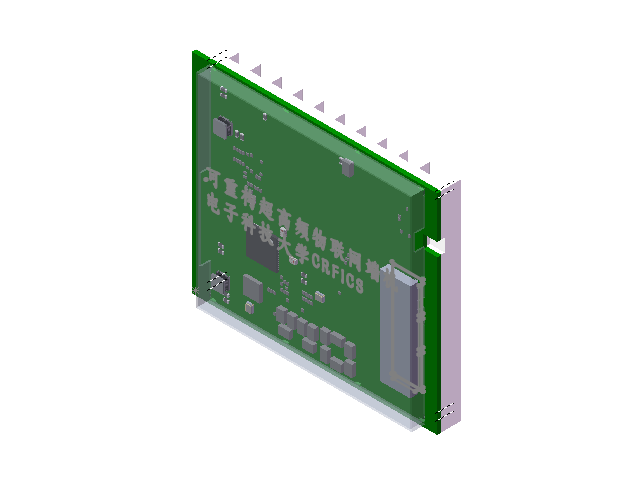
[picture p143: CAD file, 2026-11-07]
05_嘉立创EDA工程/UHF_Reader_MultiFuntion_V5/3D模型与结构腔体/装配方案.SLDASM
Extruded.step x 8
Extruded-0.step x 16
Extruded-1.step x 25
Extruded-2.step x 5
Extruded-3.step x 3
Extruded-4.step x 4
Extruded-5.step x 9
User Library-XTAL2520-4.step x 2
SRN4026 Series.step x 2
L0603.step x 12
Balun0805-2450FB15L0001.step x 3
Thermal_Shape.step
Extruded-6.step
端机腔体top
零件2
腔体bottom
