lyy622516-web/basestation/(list of files, cad)

Other CAD files:
05_嘉立创EDA工程/UHF_Reader_MultiFuntion_V5/3D模型与结构腔体/UHF_Reader_MultiFunction_V3.SLDASM
05_嘉立创EDA工程/UHF_Reader_MultiFuntion_V5/3D模型与结构腔体/端机腔体top.SLDDRW
05_嘉立创EDA工程/UHF_Reader_MultiFuntion_V5/3D模型与结构腔体/腔体bottom.SLDDRW
05_嘉立创EDA工程/UHF_Reader_MultiFuntion_V5/3D模型与结构腔体/零件2.SLDDRW
