lyy622516-web/basestation/06_Altium_Designer工程/UHF_Reader_MultiFunction_V4.pdf

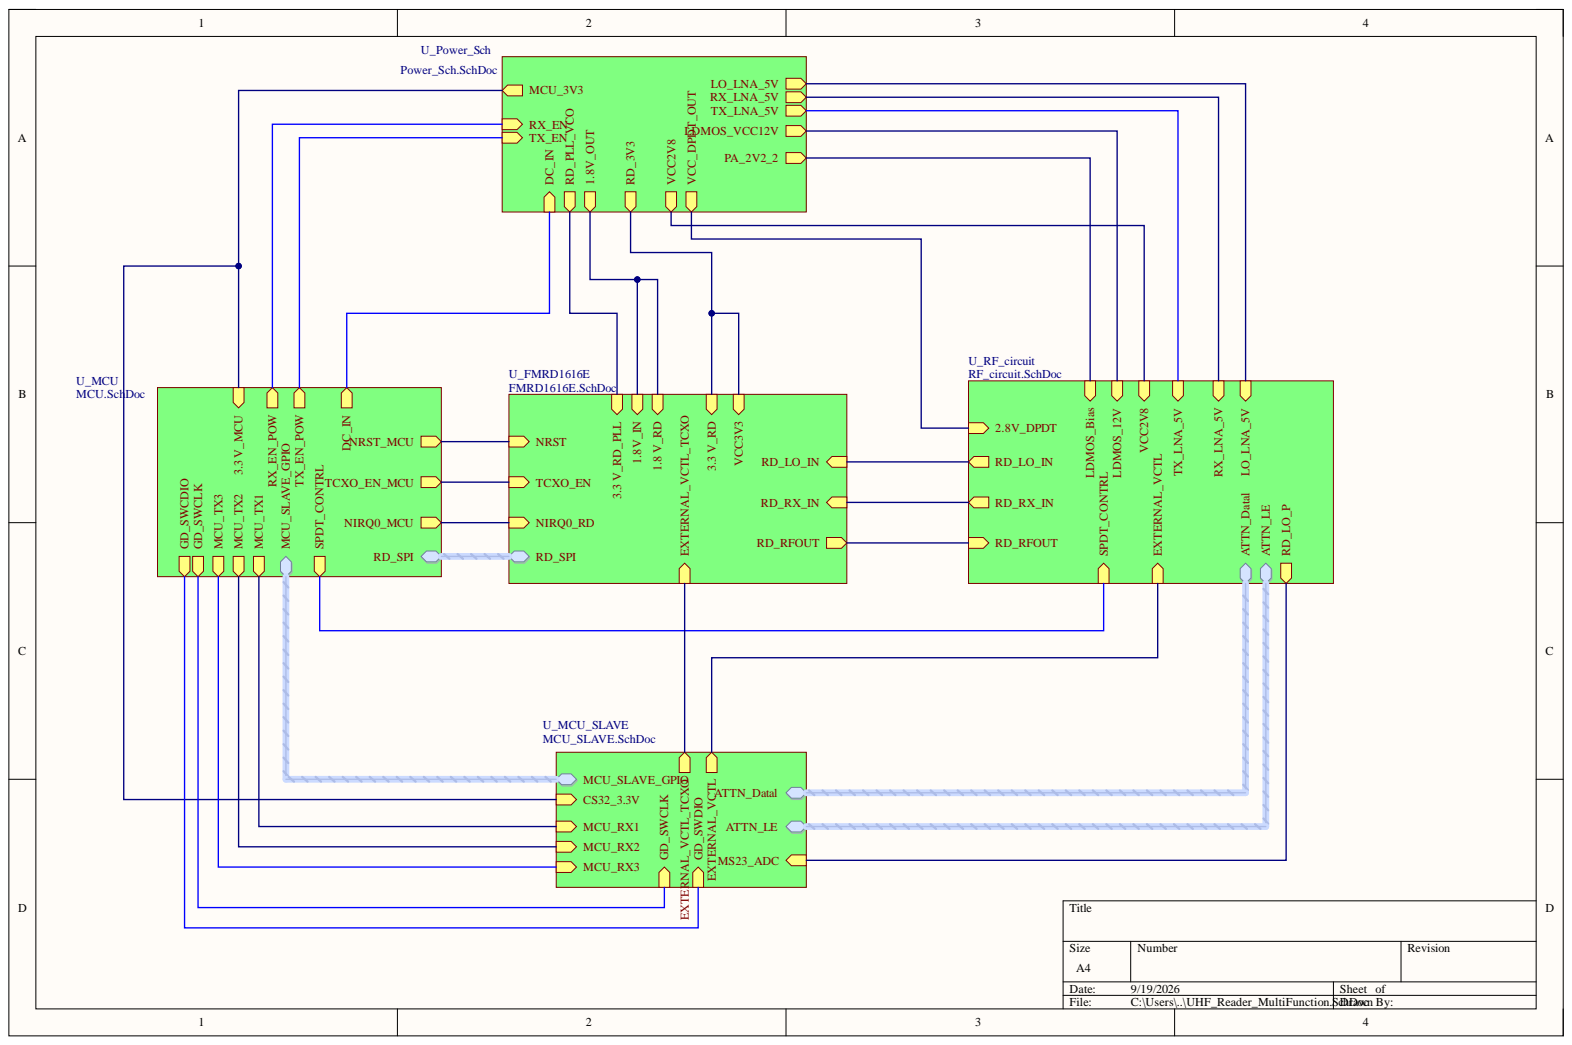
[picture p144: page 1]

U_FMRD1616E | U_RF_circuit RF_circuit.SchDoc

NRST_MCU TCXO_EN_MCU RD_SPI MCU_TX1 NIRQ0_MCU

2.8V_DPDT RD_LO_IN RD_RX_IN RD_RFOUT

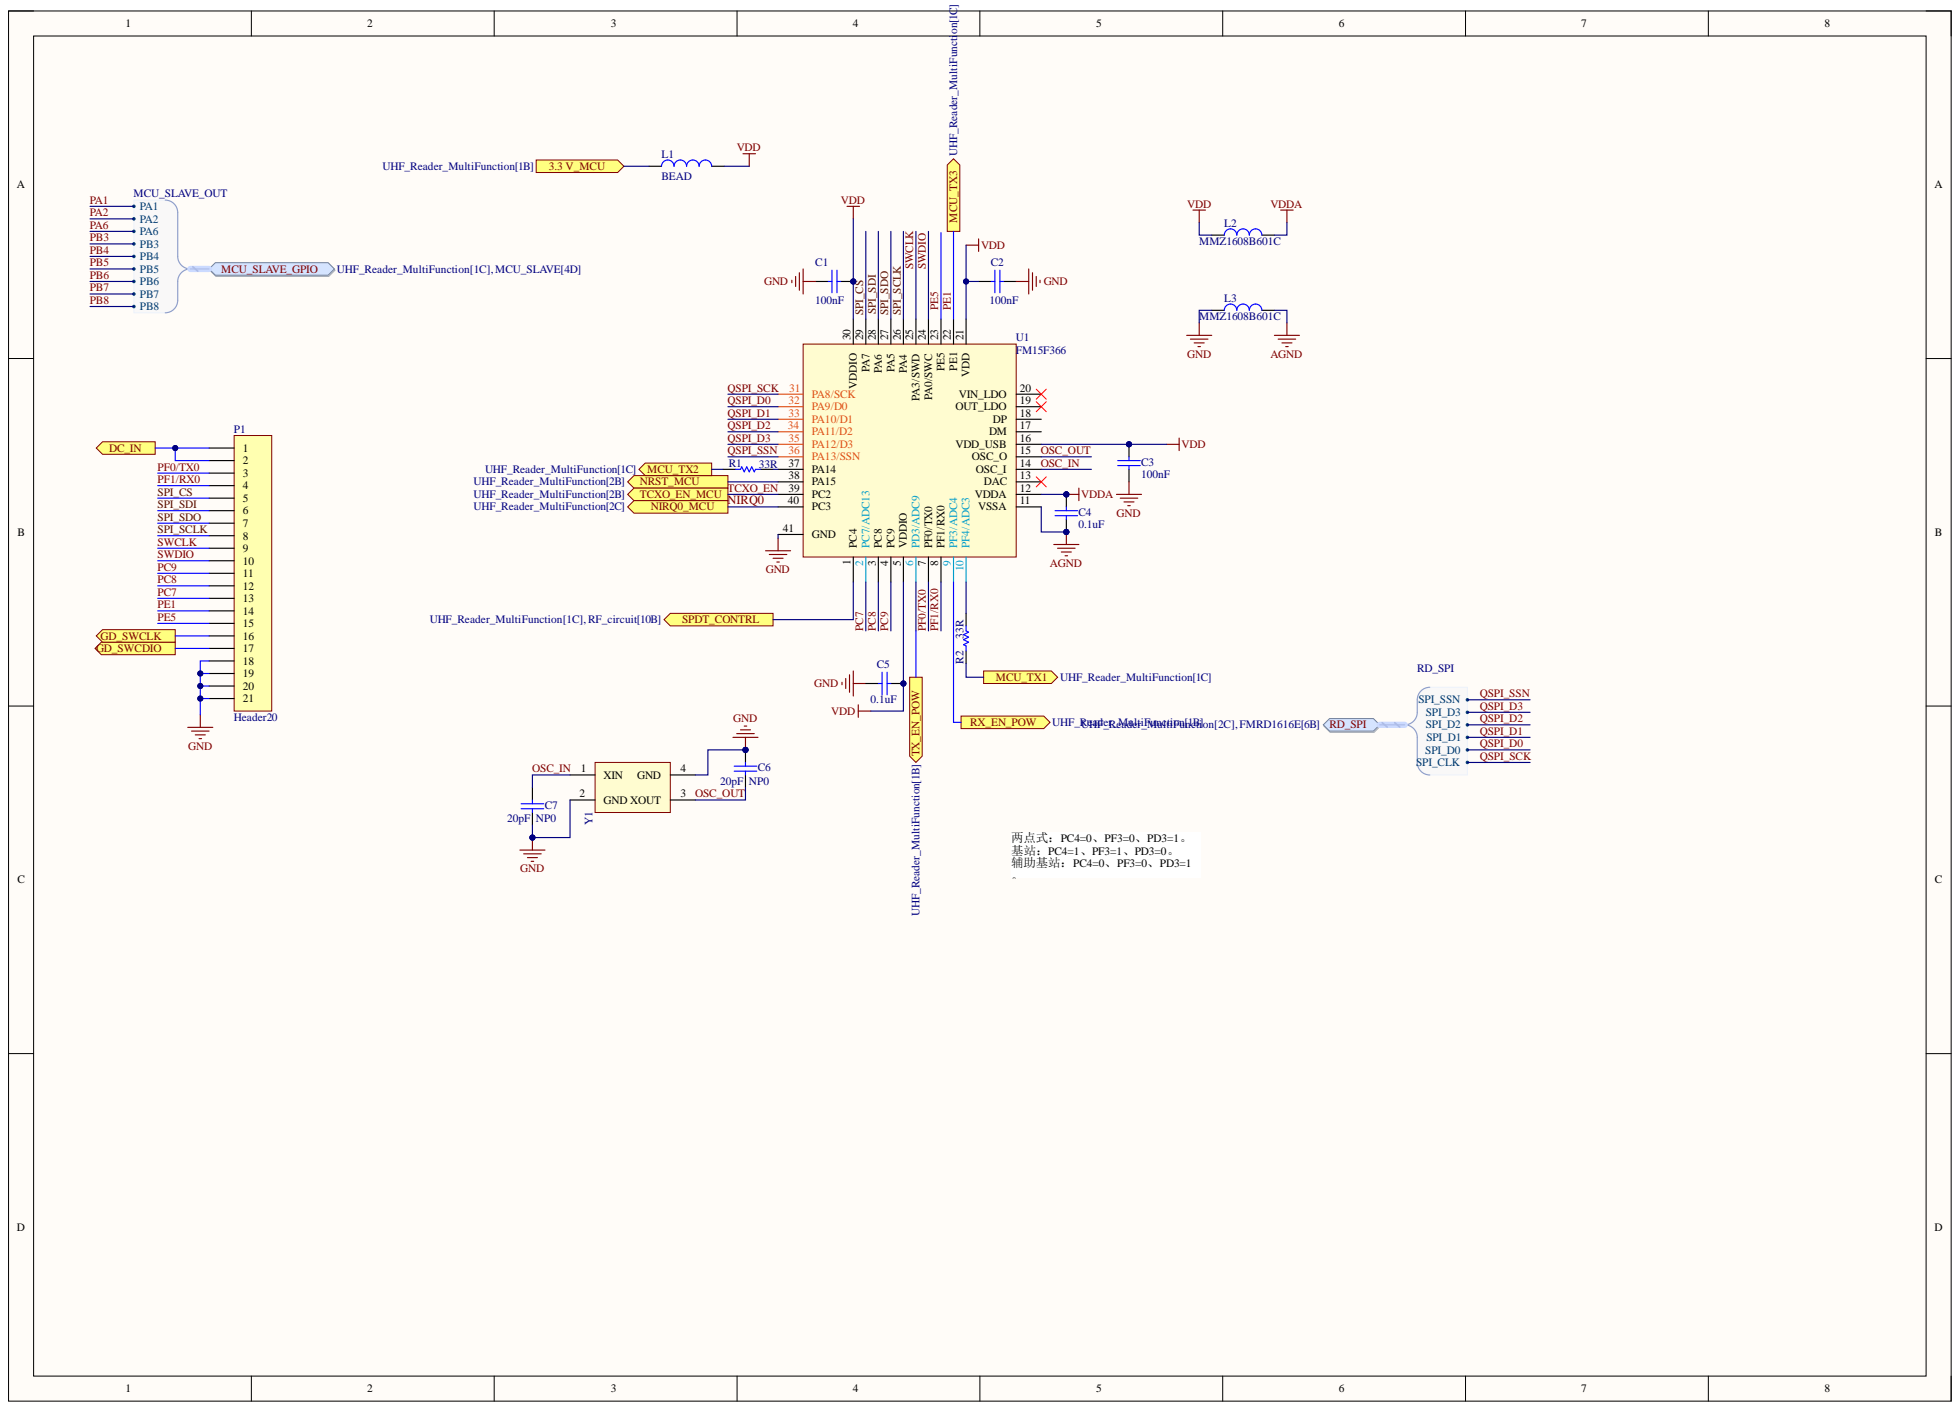
[picture p145: page 2]

VDD 21 PE1 22 PE5 23 PA0/SWC 24 PA3/SWD 25 PA4 26 PA5 27 PA6 28 PA7 29 VDDIO 30

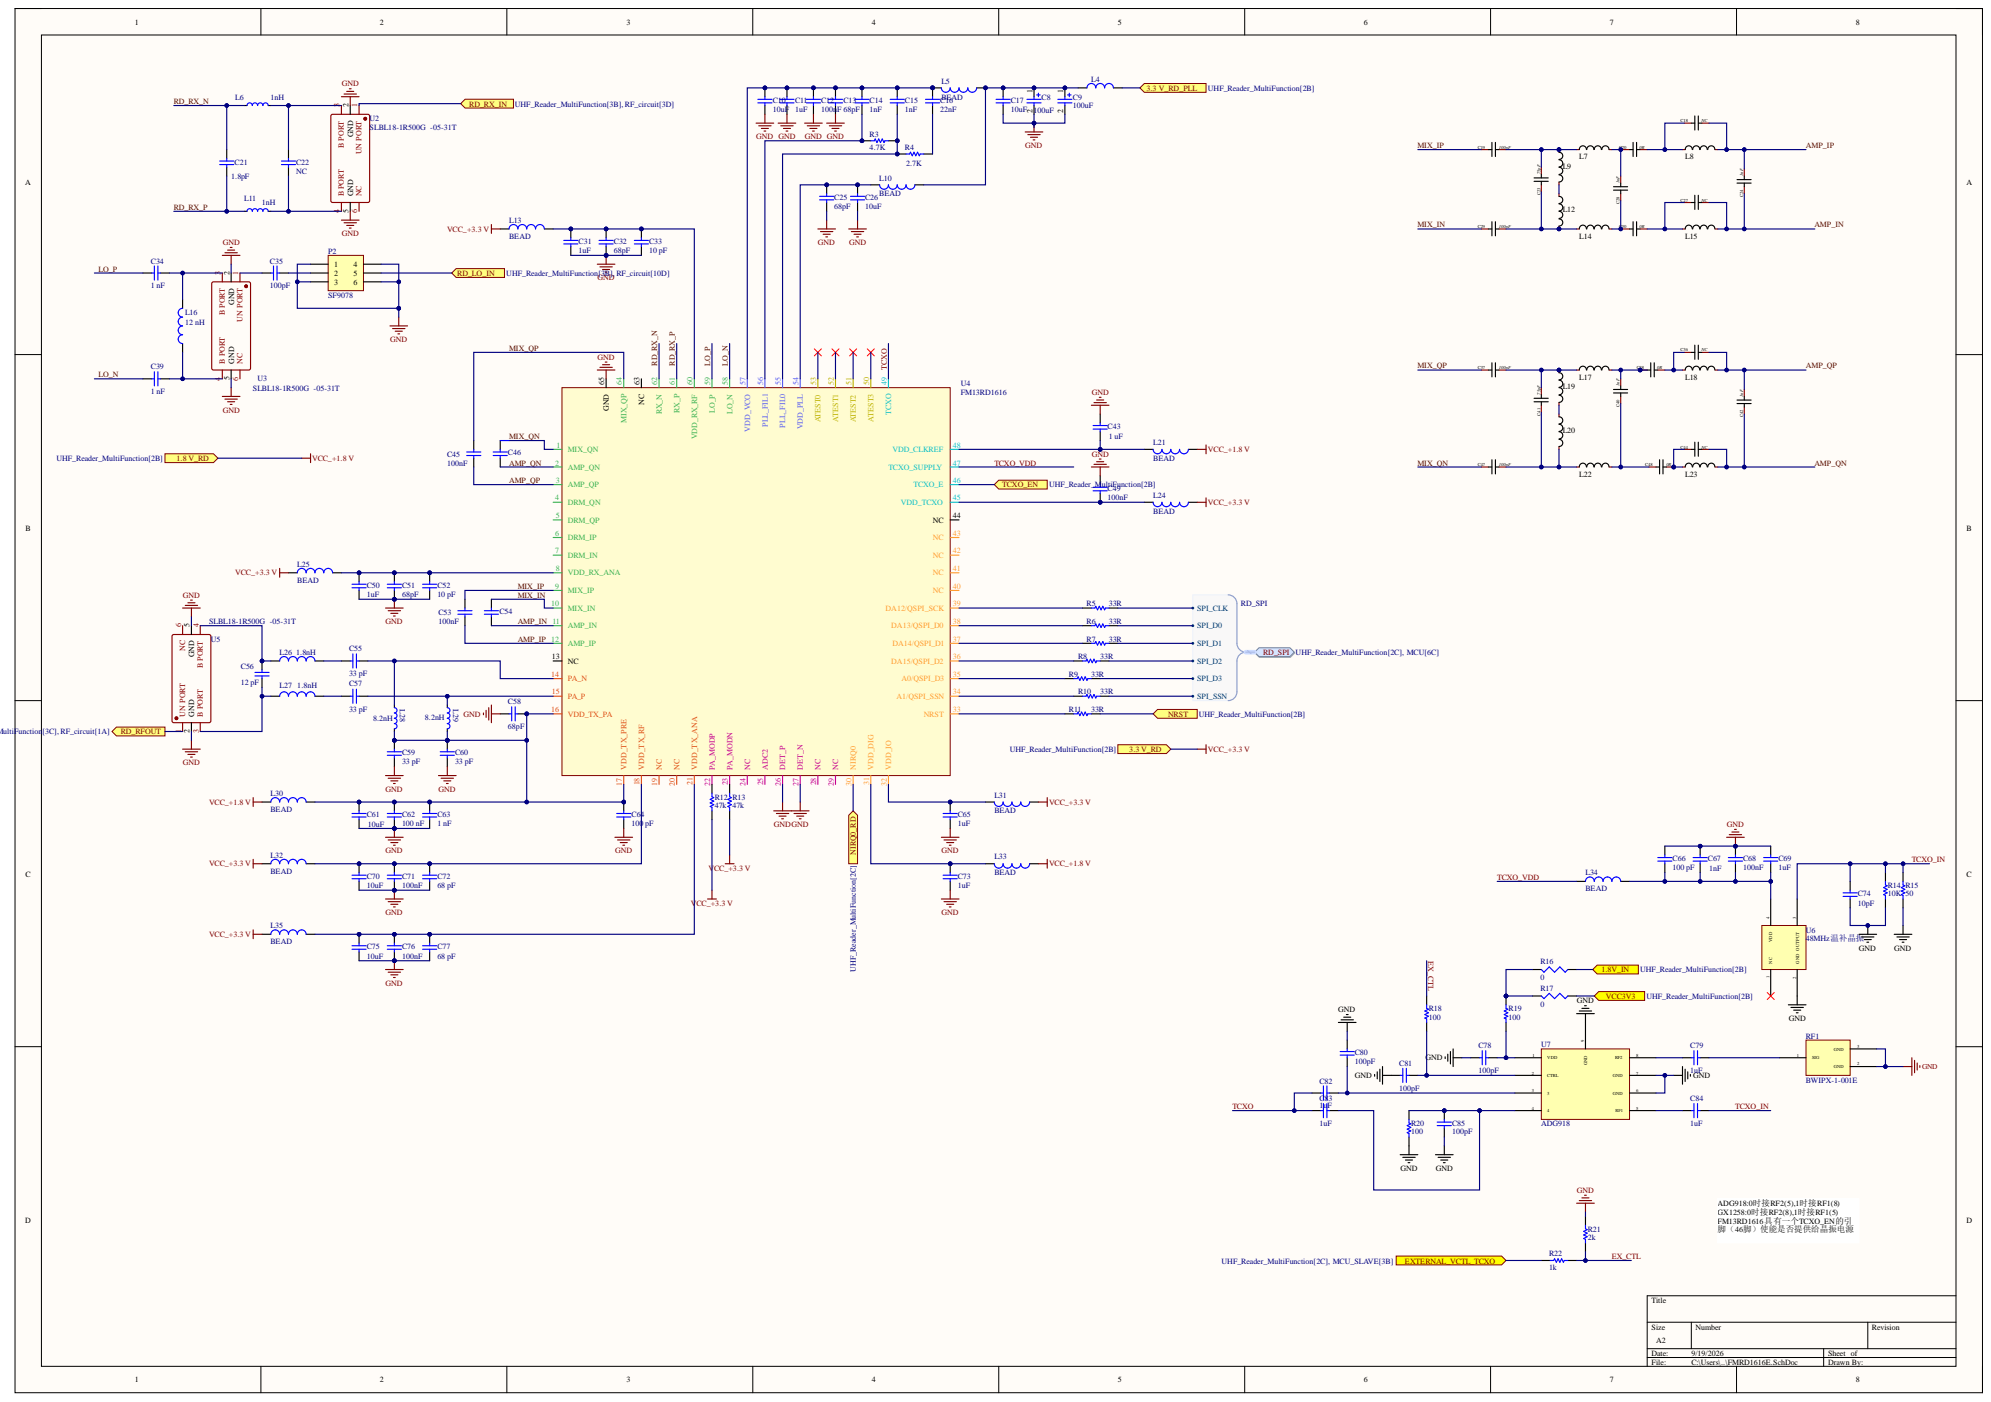
[picture p146: page 3]

UN PORT 1 GND 2 B PORT 3 B PORT 4

B PORT 3 B PORT 4 GND 5 NC 6

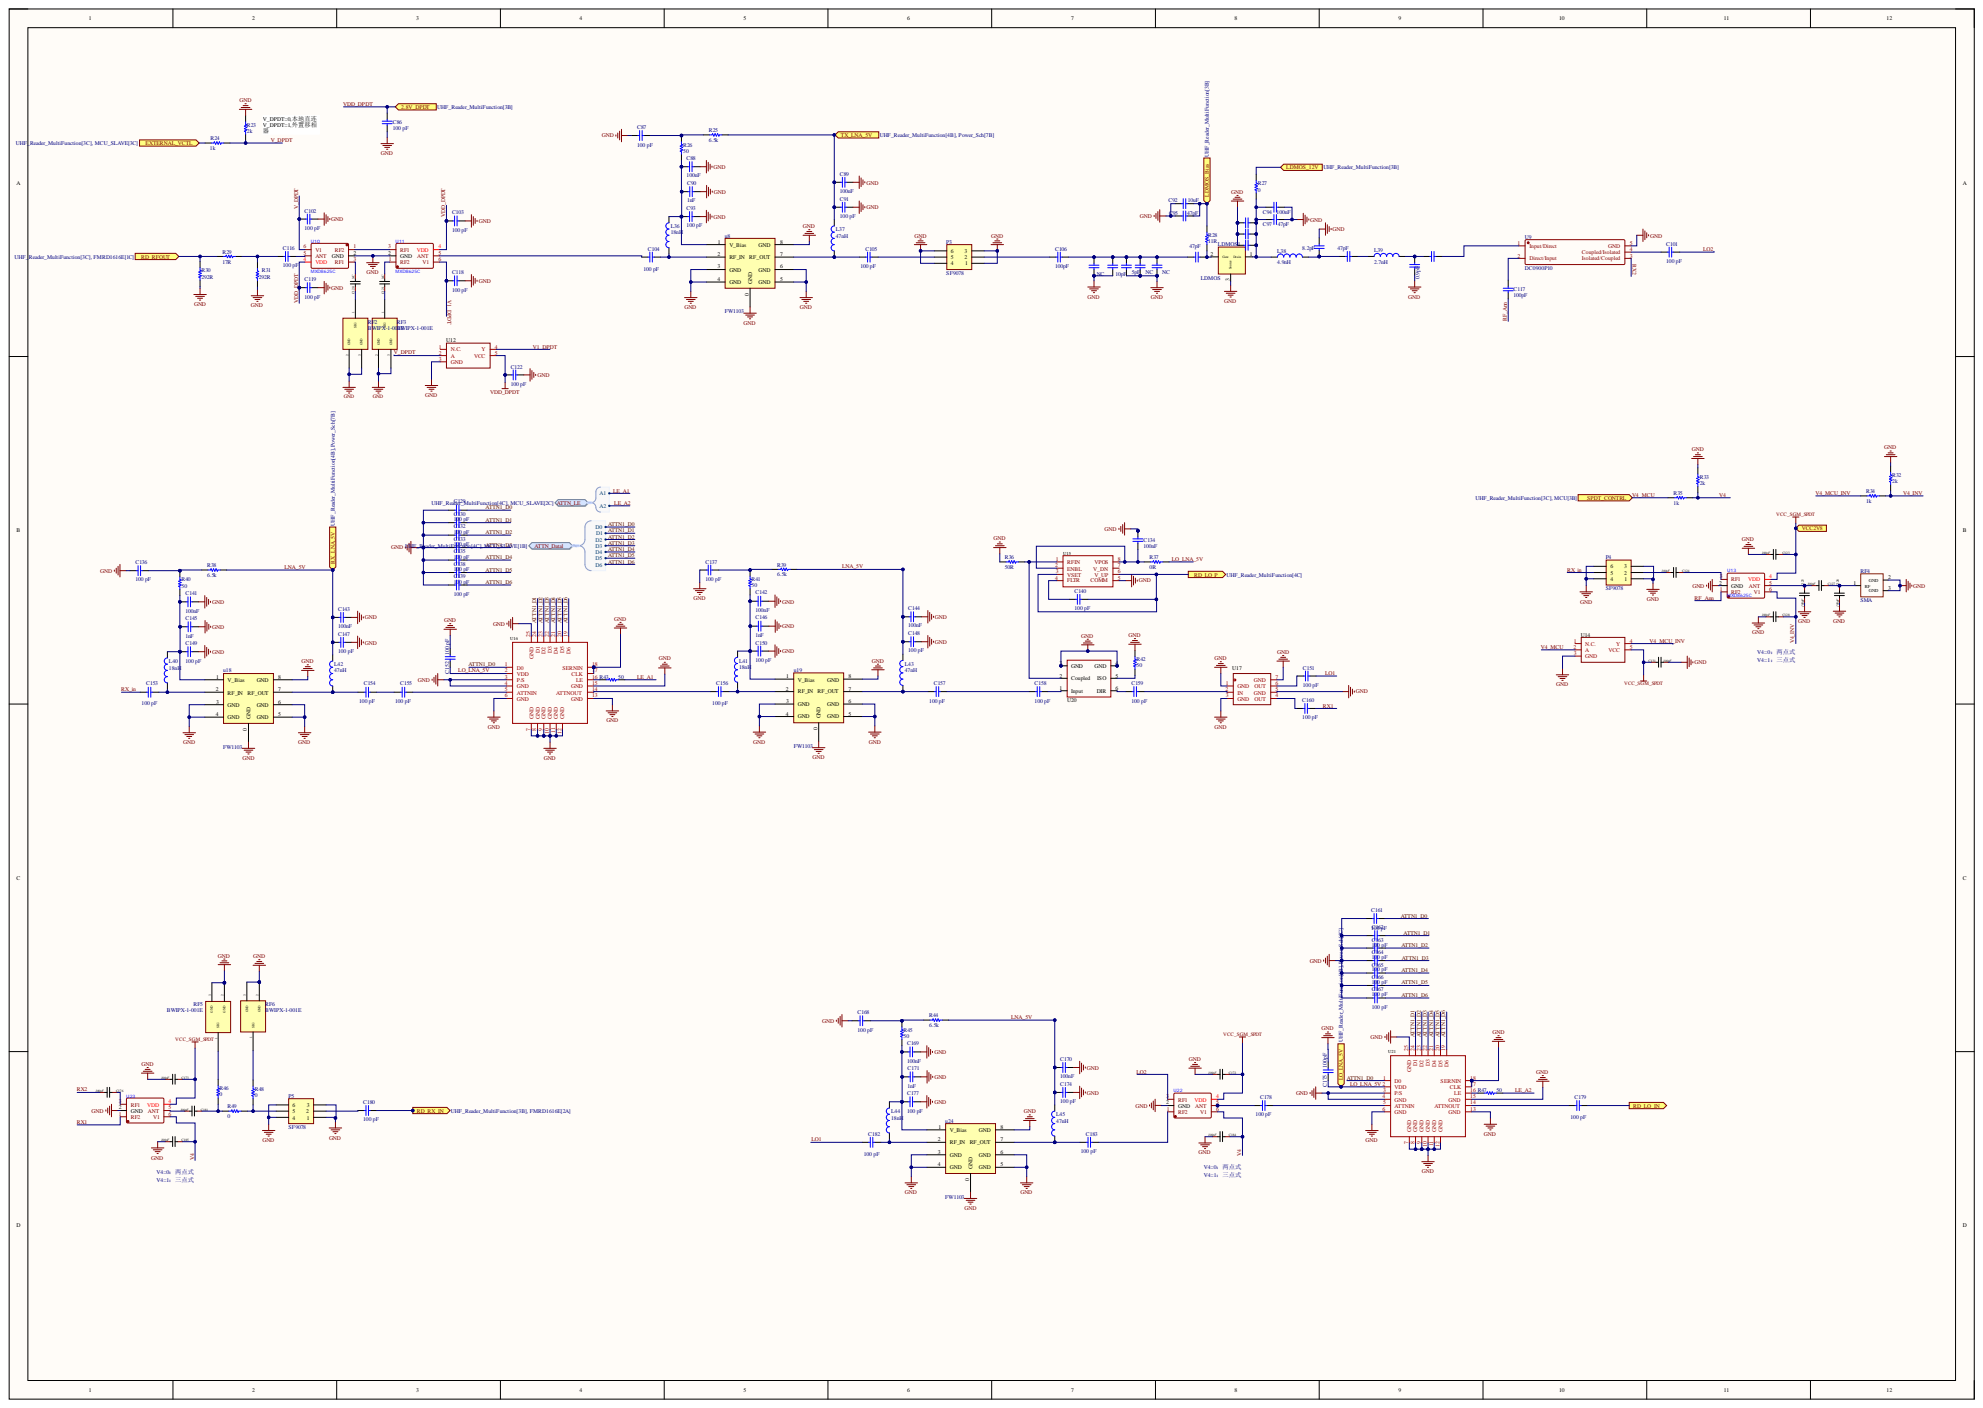
[picture p147: page 4]

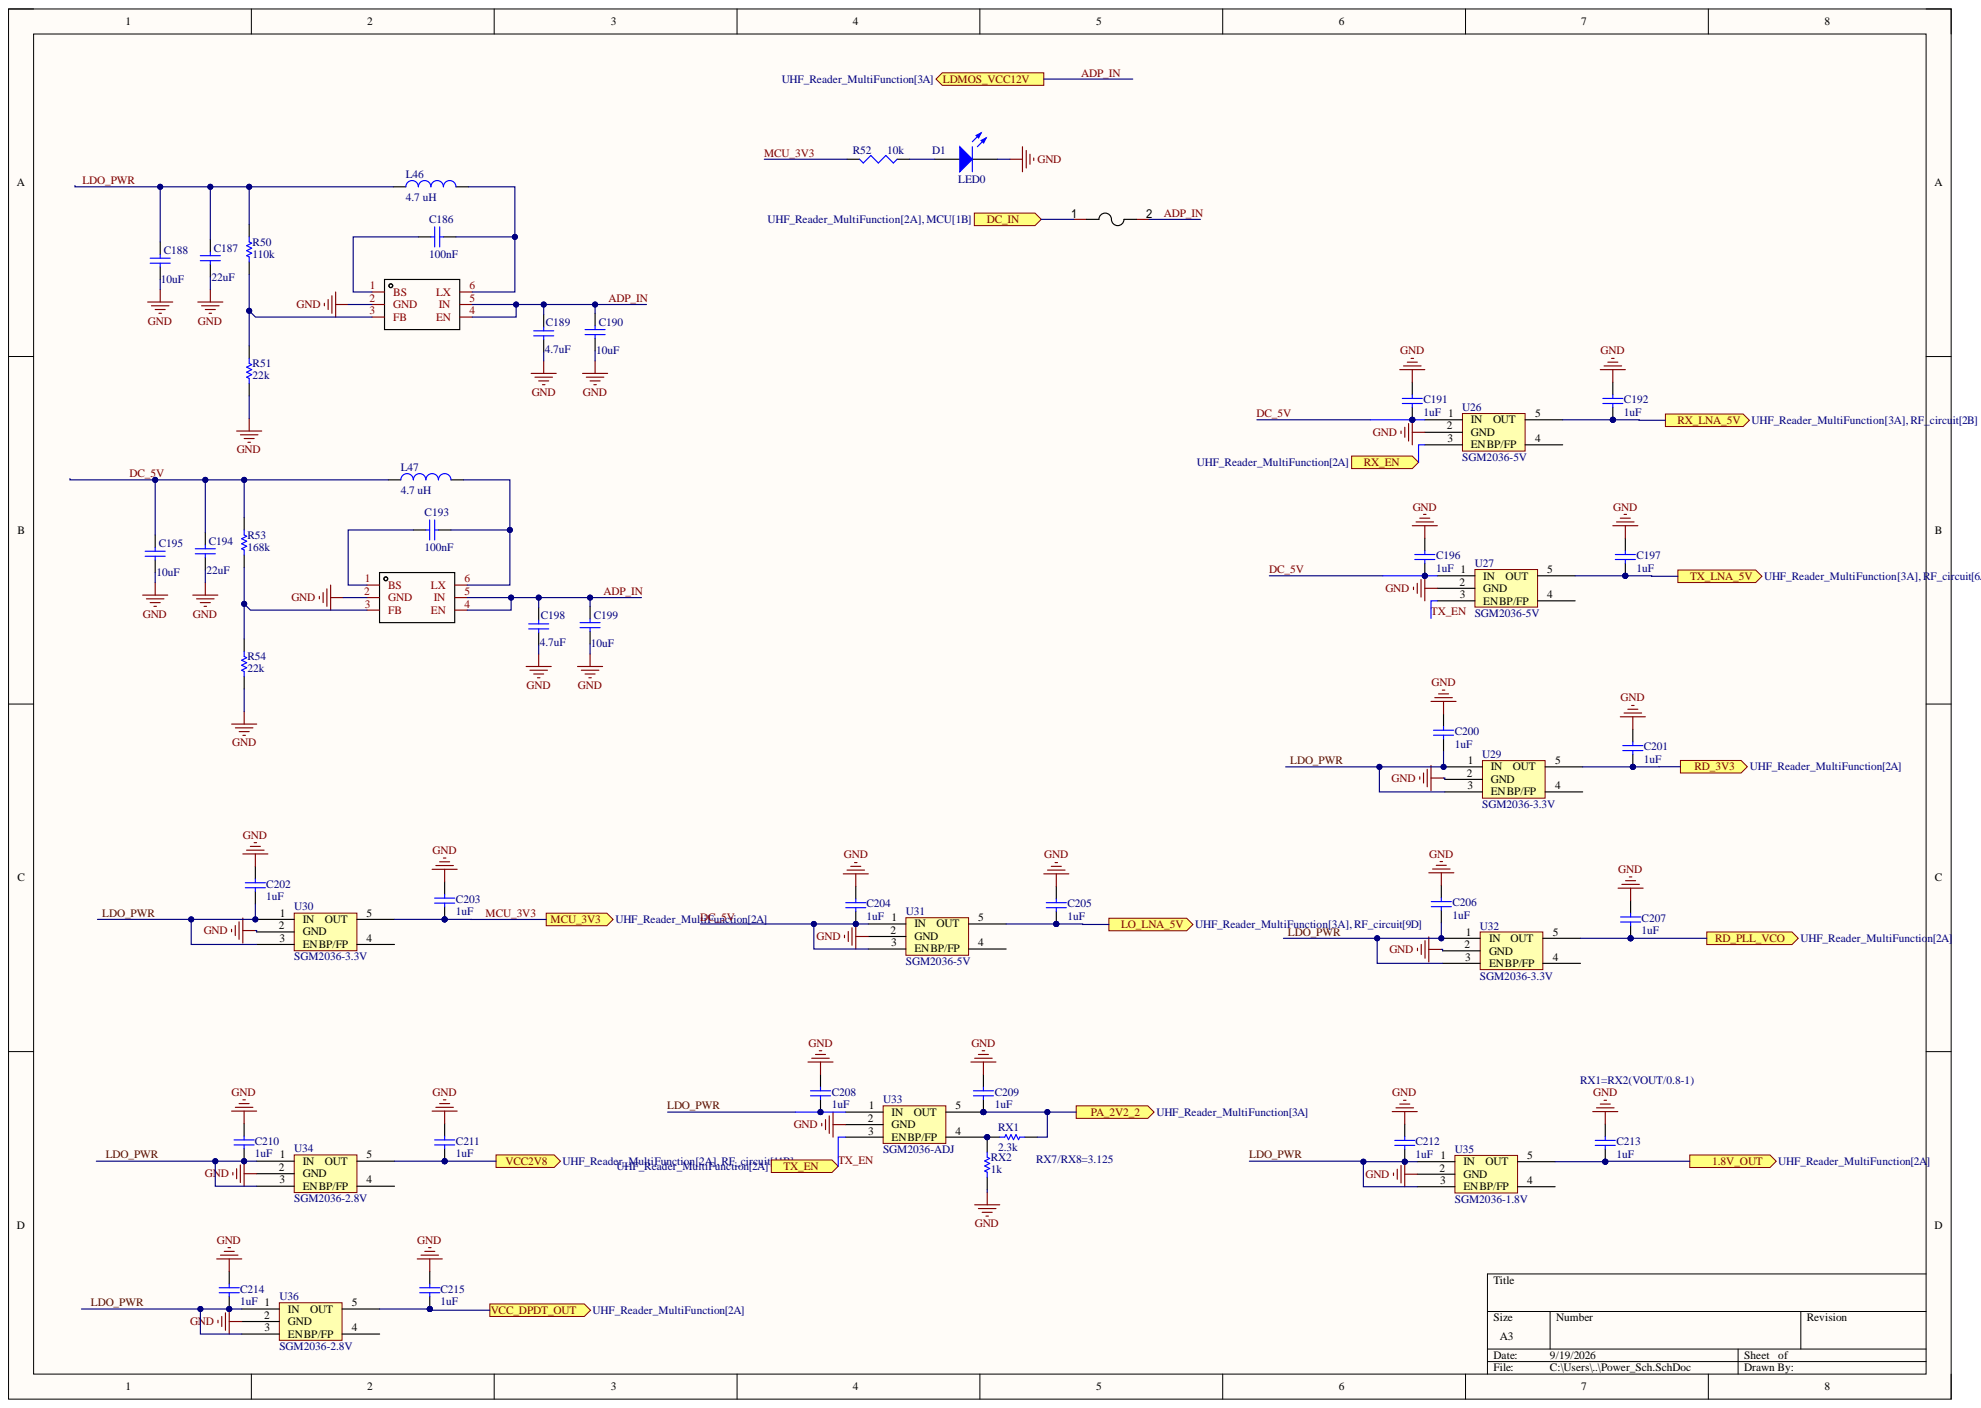
[picture p148: page 5]

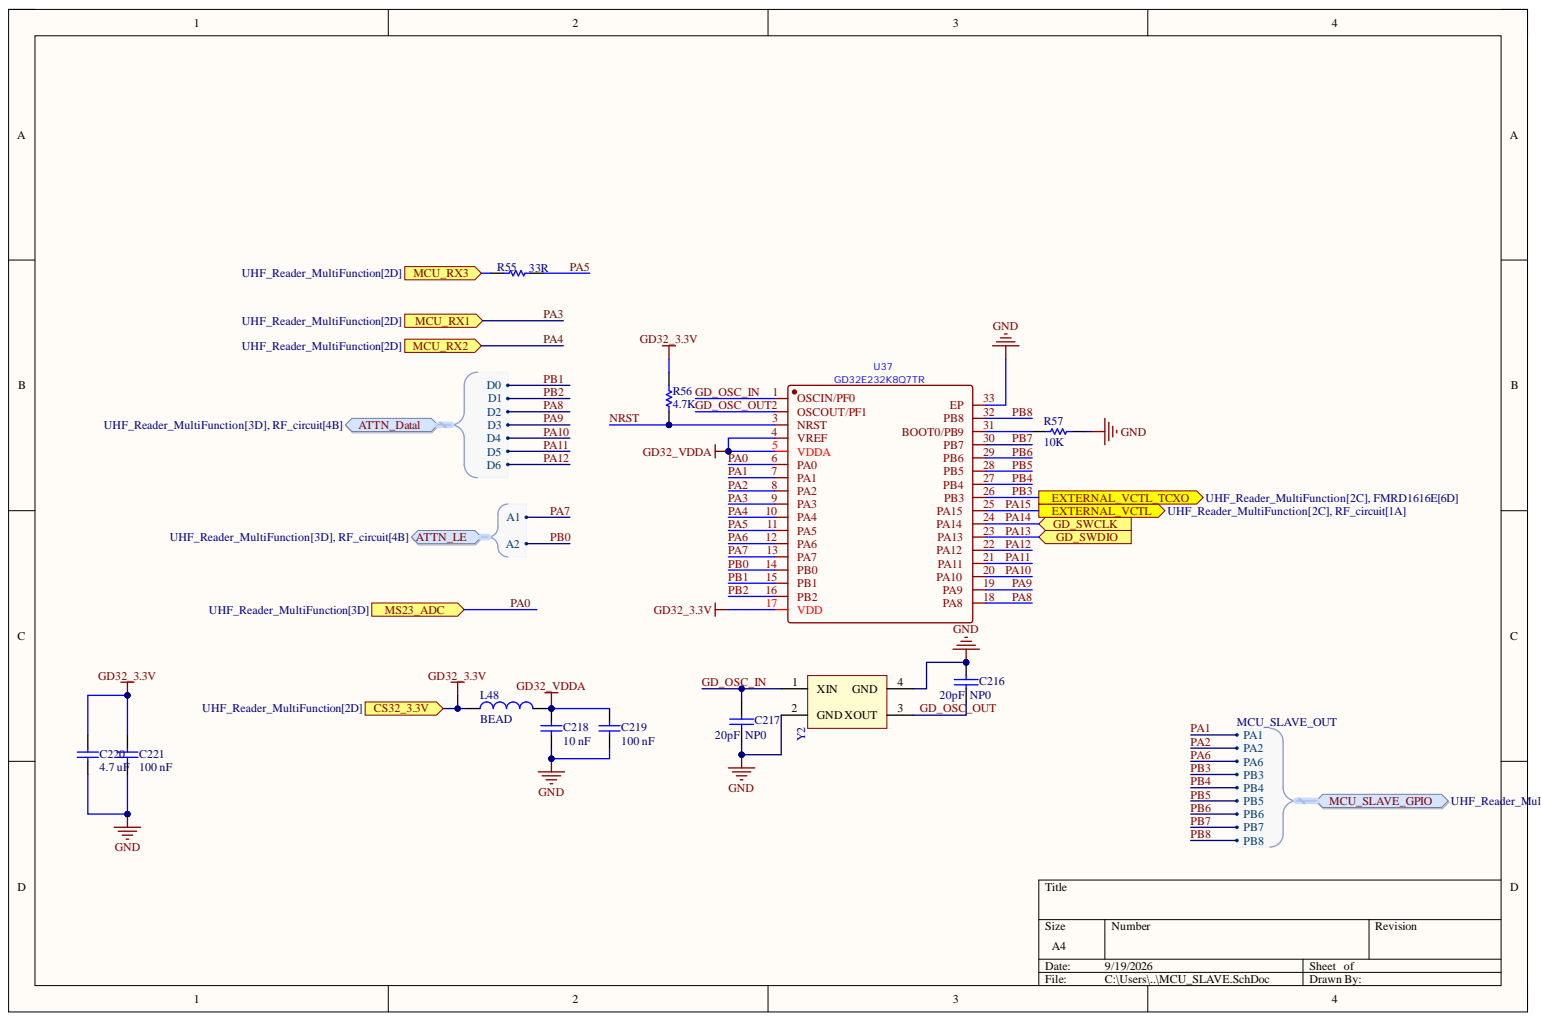
[picture p149: page 6]

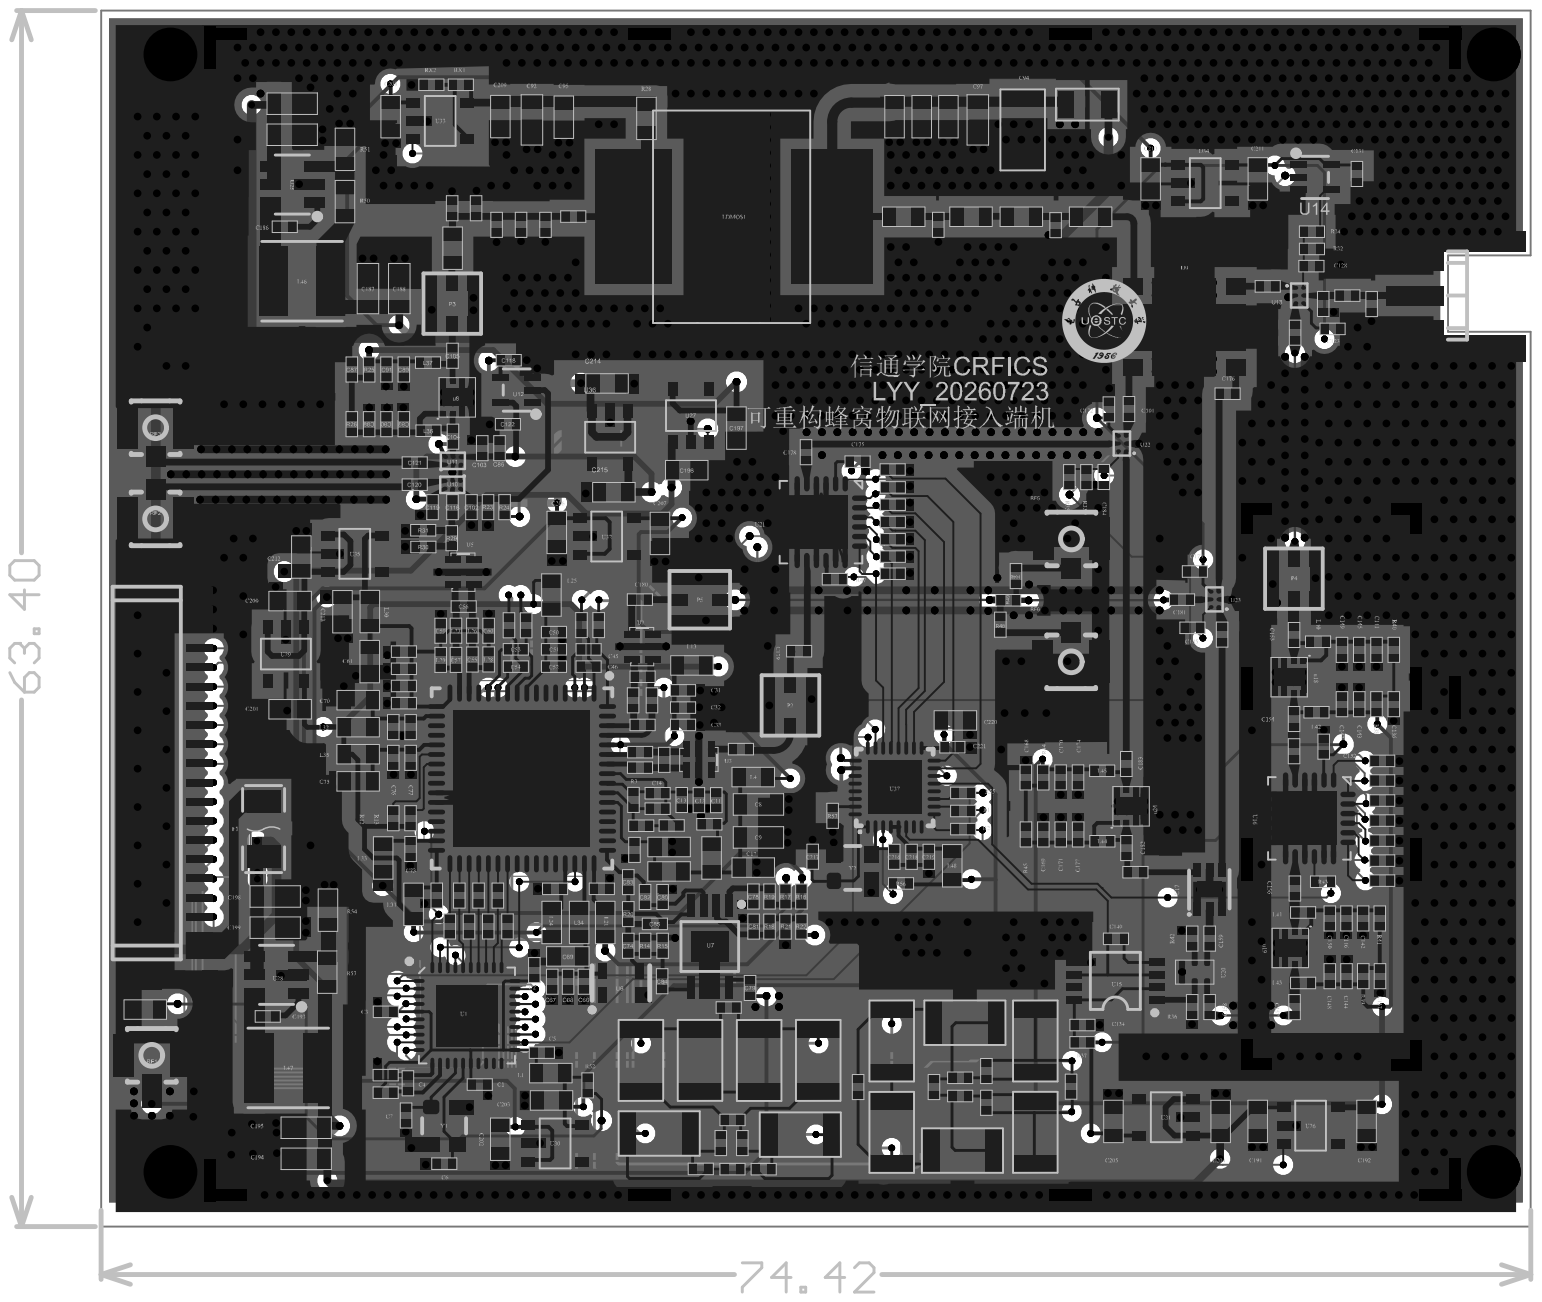
[picture p150: page 7]
