lyy622516-web/basestation/(list of files, drawings)

Other design files:
06_Altium_Designer工程/FMRD1616E.SchDoc
06_Altium_Designer工程/MCU.SchDoc
06_Altium_Designer工程/MCU_SLAVE.SchDoc
06_Altium_Designer工程/Power_Sch.SchDoc
06_Altium_Designer工程/RF_circuit.SchDoc
06_Altium_Designer工程/UHF_Reader_MultiFunction.SchDoc
06_Altium_Designer工程/UHF_Reader_MultiFunction_V4.PcbDoc
06_Altium_Designer工程/UHF_Reader_MultiFunction_V4.PrjPcb
07_物料映射与走线数据/pcb_pad_nets_truth.json
