lyy622516-web/basestation/(commit log)

2026-11-06 feat: 初始化 UHF_Reader_MultiFunction 基站样机完整硬件工程
    1. 包含 01~07 七大标准化工程目录与详细 README.md
    2. 包含 01_技术方案与设计报告 (电源树分析、走线分析与24份相干设计思考)
    3. 包含 02_硬件架构与拓扑图 (6层走线300DPI高清图谱、电源树与系统架构SVG矢量图、Visio工程)
    4. 包含 03_BOM_物料清单 (嘉立创LCSC贴片物料表)
    5. 包含 04_器件手册_Datasheet (23份原厂芯片手册PDF)
    6. 包含 05_嘉立创EDA工程 (专业版工程源码与eprj2包)
    7. 包含 06_Altium_Designer工程 (PrjPcb, PcbDoc, SchDoc, 3D Step)
    8. 包含 07_物料映射与走线数据 (2028段走线明细、网络汇总与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
    [FMRD1616E.SchDoc, MCU.SchDoc, MCU_SLAVE.SchDoc, Power_Sch.SchDoc, RF_circuit.SchDoc, UHF_Reader_MultiFunction.SchDoc, UHF_Reader_MultiFunction_V4.PcbDoc, UHF_Reader_MultiFunction_V4.PrjPcb]
2026-11-07 feat(3d): 集成完整样机整板STEP与腔体装配3D模型资产至嘉立创EDA工程
    [UHF_Reader_MultiFunction_V3.SLDASM, UHF_Reader_MultiFunction_V3.step, UHF_Reader_MultiFunction_V4_完整整板3D器件模型.step, 端机腔体top.SLDDRW, 端机腔体top.SLDPRT, 腔体bottom.SLDDRW, 腔体bottom.SLDPRT, 装配体1.SLDASM]
